SSSound13/Cambridge_640A_PowerAmp/REVIEW_ROUTING_2026-09-28.md

> Исторический документ сентября 2026 года. Его выводы и разрешения на заказ не относятся к текущим исправленным исходникам. В изготовленной v2 позднее обнаружена ошибочная связь U6.2 с +15V. Актуальная v2 находится на проверке; см. [README](README.md) и [текущие исправления](doc/v2/MINIMAL_FIXES.md).

# Проверка разводки после переразводки — 2026-09-28

Проверялась плата `640A_PowerAmp.kicad_pcb` версии от 2026-09-28 16:51 (после полной переразводки
сигнальных цепей, KiCad 10). Найденное исправлено прямо в файле платы; исходный файл —
`_archive_2026-09-28_routing_review/640A_PowerAmp.kicad_pcb.before`, скрипты проверки и план правок —
`_archive_2026-09-28_routing_review/scripts/`. Краткая запись — в `CHANGELOG.md` (2026-09-28, 18:35).

## Итог

* Ошибок соединений нет: ERC 0/0, DRC с перезаливкой зон и проверкой соответствия схеме — 0 ошибок,
  0 неразведённых, только прежние 148 исключённых пересечений courtyard.
* Главный недочёт разводки — питание выходных транзисторов U2 (−45V) и U5 (+45V): полигоны In1 были
  связаны с шинами батареи только через площадки резисторов R41/R98, а реальное сечение полигонов
  с учётом вырезов под площадки в узких местах составляло 1,1–3,3 мм при 35 мкм. Исправлено
  переходными отверстиями и расширением зон; одно узкое место (колонна −45V к U2) без перестановки
  элементов не расширяется — см. «Что осталось».
* Ширины 143 отрезков доведены до классовых там, где позволяет зазор; 8 площадок переведены на
  сплошное подключение к полигонам. Элементы не сдвигались, цепи и площадки не менялись.

## Что проверялось

| Проверка | Способ | Результат |
|---|---|---|
| Соответствие схеме, ERC, DRC | kicad-cli 10.0.6: `sch erc`, `pcb drc --schematic-parity --refill-zones --all-track-errors --severity-all` | 0 / 0 / только исключённые courtyard |
| Связность силовых цепей по меди | свой граф: дорожки, площадки, переходные отверстия, контуры зон, перекрытия зон одной цепи | +45V, −45V, PGND — по одному связному куску; найден ввод через площадки R41.2/R98.2 |
| Сечение полигонов In1/In2 | растр залитых полигонов из файла, минимальная ширина меди по строкам/столбцам | цифры ниже |
| Ширины дорожек против классов | по всем отрезкам, с расчётом максимально возможной ширины по зазору | план расширения |
| Лучи GND, возвраты АС, звезда | обход графа GND от NT1.2, PGND от NT1.1 | как описано в README (слева и справа по три луча GND; возвраты АС — плечи F.Cu 3,0 мм) |
| Параллельные пробеги сигнальных цепей с ±45V/обмотками, зазоры <0,25 мм, HV–HV <0,6 мм | геометрический перебор | замечаний нет |
| Касание корпусов | контуры слоя Fab всех посадочных мест, попарно | таблица ниже |
| Коридоры для обходных силовых дорожек | поиск самого широкого коридора (растр 0,1 мм, зазор 0,5 мм) на F.Cu, B.Cu, In1 | обходов ≥2 мм нет |

## Исправлено

### 1. Ввод ±45V в полигоны для U2 и U5

Шины батареи (B.Cu, 3,5 мм) для U2 и U5 кончались на площадках R41.2 (−45V) и R98.2 (+45V) —
fusible 150R, площадка Ø1,6 мм, отверстие 0,8 мм, тепловые мостики 4 × 1,0 мм × 35 мкм. Полигоны
In1 других связей с шиной не имели, то есть весь ток коллектора выходного транзистора шёл через
гильзу и мостики резисторной площадки.

Сделано: переходные отверстия 1,2/0,6 мм на шинах внутри полигонов —
3 шт. у R41 (111,2/133,2; 112,9/133,7; 113,8/132,8 — зона −45V расширена под них: x 112,4–116,5,
y 131,6–136,5, зазор до зоны +45V 0,6 мм), 2 шт. у R98 (187,3/112,1; 187,9/113,6).
Для U3 и U4 полигоны питались через одну гильзу конденсатора (C23.1, C30.2, Ø1,2 мм) — добавлено
по 2 отверстия на шинах рядом (121,3 и 122,6/102,73; 174,9 и 176,3/129,7). Всего 9 силовых отверстий.

Полигон +45V у U5.3 заканчивался на y = 61,0 при центре площадки 61,07 (у U2 язычок доходит до 63,2) —
связь держалась на перекрытии заливкой верхней части площадки. Язычок продлён до y = 63,2.

### 2. Сечения полигонов

Минимальная ширина меди (по заливке, с вырезами под площадки и зазоры), мм при 35 мкм.
Критерий из README: 3,5 мм внутри для 4 А при +20 °C; для тока заряда батареи (~6 А) — 6,1 мм.

| Участок | Было | Стало | Что сделано |
|---|---|---|---|
| −45V → U2, верхняя полоса (у R120) | 1,1 | 3,55 | полоса опущена с y 56,5 до 59,0 (x 82–100,5) |
| −45V → U2, колонна, ряд Q19 (y 72) | 1,7 | 2,6 | колонна расширена до x 112,4 |
| −45V → U2, колонна, ряд Q14/R27–R29 (y 91) | 2,1 | 2,1 | расширение не помогает — R27/R28 стоят в новой полосе |
| −45V → U2, колонна, y 101 | 2,2 | 3,0 | то же расширение |
| +45V → U5, верхняя полоса | 3,1 | 4,05 | полоса опущена до y 59,0 (x 193–215) |
| +45V → U5, колонна | 3,25 | 3,9 | колонна расширена до x 184,6 |
| +45V мост → батарея, стебель (ряд NT1–NT3, C25.2/C26.2) | 4,75 | 12,5 | стебель расширен до x 134–163 на y 98–118 |
| PGND между рядами батареи (у NT1.2) | 4,35 | ≥24,6 | вырезы убраны: сплошной блок x 116–181, y 107,5–134 |
| PGND у CN20.3 (стебель к мосту) | 4,65 | ≥24,6 | нижний блок x 132–165, y 142–157 |
| +45V → U3, −45V → U4 | 4,95 | 4,95 | без изменений |

Опущенные полосы оставляют 0,57 мм до ряда выводов U2/U5. В полосы попали D2.2/C46.2 (−45V) и
C48.1/D10.1 (+45V) — им дано сплошное подключение (у C48.1 тепловое подключение иначе получается
с одним мостиком, DRC «starved thermal»).

### 3. Сплошное подключение к полигонам

Было тепловое: C11.1, C65.2, C64.1, C45.2 (выводы PGND развязки 220 µF выходных каскадов),
D2.2, C46.2, C48.1, D10.1 (см. выше). R41.2/R98.2 оставлены с тепловыми мостиками — после
добавления отверстий они не несут ток полигона, а fusible-резисторы должны легко перепаиваться.

### 4. Ширины дорожек

Расширены до классовой ширины 143 отрезка там, где остаётся зазор ≥0,3 мм (≥0,5 мм до ±45V и обмоток;
до площадок — по описанной окружности прямоугольных площадок):

| Цепь | Было → стало | Отрезков |
|---|---|---|
| digital | 0,3 → 0,8 | 4 |
| digital | 0,6 → 0,7–0,8 | 31 |
| +5V | 0,6 → 0,8 | 21 |
| GND | 0,6 → 0,8 | 8 |
| PIC CLIP / DC / OVERCURRENT / STANDBY / TEMP | 0,4–0,5 → 0,5–0,8 | 38 |
| вход CN11 (Net-(CN11-Pin_1)) | 0,5 → 0,8 | 6 |
| база Q20 (термодатчик) | 0,5–0,6 → 0,7–0,8 | 21 |
| CN21.3 → D16 (вспомогательная обмотка) | 0,8 → 0,9–1,0 | 3 |
| отводы ±45V к C11, C46, C48, D10 | 1,2–1,5 → 1,35–2,0 | 11 |

Не трогались: ответвления выходных цепей RO/LO/RE/LE (R101, отводы цобеля и защиты, контрольные
точки) и отвод CN20.1 → C32 (снаббер) — ток там мал, ширина 1,0–1,5 мм выбрана осознанно.
49 отрезков остались уже классовой ширины, потому что не проходят по зазору.

## Что оставалось после 2026-09-28 (сделано 2026-09-29, см. ниже)

1. **Колонна −45V к U2 (x 104–112,4)** пересечена насквозь рядами выводов Q19 (y 72) и Q14/R27–R29
   (y 90–92): 2,1–2,6 мм × 35 мкм. По IPC-2221 (внутренний слой) это ≈2 А при +10 °C и ≈3,3 А при
   +30 °C. На 8 Ом (≈2 А RMS на плечо при полной мощности) и для музыки достаточно; длительная
   синусоида на 4 Ом (≈3,5 А RMS) даст нагрев порядка +35 °C в этом месте. Обходной дорожки ≥2 мм
   на F.Cu или B.Cu с зазором 0,5 мм по текущей расстановке нет (самый широкий коридор — 1,8 мм с
   обходом 125 мм через сигнальную зону канала). Радикально помогает только перестановка: вынести
   Q14, Q19 и R29 из колонны или развернуть их ряды вдоль неё. Правая сторона (U5) после правок
   проходит по критерию 3,5 мм.
2. **R120** (100R параллельно R116) стоит поперёк верхней полосы −45V; если повернуть его выводом 2
   на запад (x ≈ 85,5), полоса вырастет с 3,55 до ≈5,9 мм. Не делалось — при ограничении колонны
   выигрыш не реализуется.
3. **Корпуса по контурам Fab.** В комментариях исключений courtyard часть пар отнесена к «TO-92 без
   контура на Fab», но контур у `TO-92_Inline_Wide` есть, и по нему корпуса перекрываются:
   Q21/C27 — 0,50 мм, R109/Q19 — 0,27, C46/C13 — 0,10, R49/R50 — 0,09, R117/Q22 — 0,06;
   пары TO-92 с шагом 3,5 мм Q7/Q8, Q9/Q10, Q26/Q27, Q28/Q29 — 0,74 мм, Q3/Q4, Q5/Q6 — 0,23 мм
   (ставить с наклоном, как на заводской плате). Известные: R44/R45 0,36, C22/R42 0,37, C21/C22 0,24.
   Электрически это ни на что не влияет — только внимание при сборке.
4. Переходные отверстия 1,2/0,6 мм — новый размер для платы (было 0,6/0,3); стандартный для любого
   производителя, но при заказе проверить, что класс отверстий 0,6 мм включён.

## Проверки после правок

* ERC: 0 ошибок, 0 предупреждений (`_archive_2026-09-28_routing_review/erc_check.rpt`).
* DRC (KiCad 10, перезаливка зон, соответствие схеме, все ошибки дорожек): 0 ошибок, 0 неразведённых,
  0 расхождений со схемой; 148 исключённых пересечений courtyard как раньше —
  `doc/DRC_after_routing_review_2026-09-28.rpt`.
* Сравнение разобранных данных до/после: 1354 отрезка (изменена только ширина у 143 запланированных),
  6 → 15 переходных отверстий, 297 посадочных мест на тех же местах, 9 зон (контуры изменены у четырёх),
  изменены только 8 площадок (`zone_connect`), контур платы и цепи те же.
* Файл сохранён kicad-cli (перезаливка зон), концы строк CRLF, как в исходном файле. Все три файла
  открываются в KiCad 10; в KiCad 9 плата не откроется (формат 20260206 — так было и до правок).

## Доделано 2026-09-29 (по разделу «Что осталось»)

1. **Колонна −45V к U2.** Вместо перестановки Q14/Q19/R29 проложена вторая колонна −45V по свободному
   коридору In1 между полигоном +45V и центром платы: новая зона x 124,1–132,3, y 50,8–132 (приоритет 1,
   зазор 0,5 мм), соединённая со старой полосой через полосу над верхом полигона +45V (x 111,5–124,1,
   y 50,8–56,4) и питаемая с шины батареи четырьмя переходными отверстиями 1,2/0,6 мм прямо на шине.
   Сечение по заливке: колонна ≥5,0 мм, полоса над +45V 5,65 мм, старая полоса 5,75 мм. Старая колонна
   осталась параллельным путём. Сигнал PIC OVERCURRENT/SHORT, шедший по In1 через коридор, на участке
   пересечения переведён на F.Cu (два переходных отверстия 0,6/0,3).
2. **R120 повёрнут** выводом 2 на запад (оба вывода в ряду y 54,93): полоса −45V под R116/R120 — 5,75 мм
   вместо 3,55. Дорожки к U2.4 и R116.1 переподключены под 45°, надпись перенесена над корпус.
3. **Комментарии исключений DRC** для пар корпусов с реальным перекрытием по Fab переписаны с цифрами
   (Q21/C27 0,50; R109/Q19 0,27; R117/Q22 0,06; R49/R50 0,09; пары TO-92 0,74 и 0,23 мм). Корпуса не
   двигались — на сборке ставить с наклоном, как на заводской плате.
4. Отверстия 1,2/0,6 мм и 0,6/0,3 мм — стандартные; при заказе проверить класс отверстий 0,3 и 0,6 мм.

Итог по питанию выходных транзисторов (минимальное сечение полигонов In1 по заливке, 35 мкм):
U3 4,95 мм, U4 4,95 мм, U5 3,9 мм, U2 5,0 мм (новая колонна) + 2,1 мм (старая). Критерий из README —
3,5 мм для 4 А — выполнен везде.

Проверки после доделки: ERC 0/0 (`_archive_2026-09-28_routing_review/erc_check_2026-09-29.rpt`);
DRC (KiCad 10, перезаливка, соответствие схеме, все ошибки дорожек) — 0 ошибок, 0 неразведённых, только
148 исключённых пересечений courtyard (`doc/DRC_after_routing_review_2026-09-29.rpt`). Изменения в файле
платы против 28.09: +1 зона, +6 переходных отверстий, +4/−1 отрезка, 3 отрезка укорочены/сдвинуты,
повёрнут один элемент (R120), больше ничего не тронуто.

**3D-модели разъёмов.** В этой копии проекта они на месте: у CN2–CN24 ссылки `${KIPRJMOD}/640A.3dshapes/…step`,
файлы лежат в `640A.3dshapes/` (JST XH — библиотечные KiCad, JST VH — упрощённые модели проекта), kicad-cli
их грузит и рендерит (`_archive_2026-09-28_routing_review/render_cn20.png`). Если в вашем рабочем экземпляре
разъёмов в 3D нет, рядом с `640A_PowerAmp.kicad_pro` отсутствует папка `640A.3dshapes` — скопируйте её отсюда.
