SSSound13/Cambridge_640A_PowerAmp/REVIEW_REPORT_2026-09-28.md

> Исторический документ сентября 2026 года. Его выводы и разрешения на заказ не относятся к текущим исправленным исходникам. В изготовленной v2 позднее обнаружена ошибочная связь U6.2 с +15V. Актуальная v2 находится на проверке; см. [README](README.md) и [текущие исправления](doc/v2/MINIMAL_FIXES.md).

# Отчёт внешней проверки — 2026-09-28

**Cambridge Audio Azur 640A (V1), Power Amp PCB AP12707/6: схема и новая 4-слойная плата (релиз 2026-09-27/28, KiCad 9.0.4).**
Задание — `REVIEW_BRIEF.md`. Проверка сделана на копии проекта средствами KiCad 10.0.6 (kicad-cli) и скриптами по файлам схемы и платы; на железе ничего не измерялось.

## 0. Кратко

* **Блокеров не найдено.** Схема совпадает с мануалом везде, кроме заявленных доработок (проверено сравнением списков цепей по всем выводам). Распиновки, полярности, разделение земель, разъёмы и звезда на плате сходятся. ERC и DRC чистые и в KiCad 10.
* **Заказывать плату можно** после одной правки платы — заземлить радиатор U8–U10 через H7/H8 (п. 2). Остальные важные пункты — уровня BOM (диоды моста, проверка Vin для TSR) или необязательные улучшения разводки (зазоры, термобарьеры).
* Из доработок две советую пересмотреть: Шоттки SB5200 в мосте (заменить на кремниевые) и металлоплёночный резистор цобеля (оставить проволочный).

## 1. Что и как проверялось

| Проверка | Как | Результат |
|---|---|---|
| Схема ↔ мануал | список цепей проекта (kicad-cli 10) сравнён по каждому выводу со списком цепей эталонной версии — схема мануала стр. 17–20 после удаления LK и замыкания WIRE LINK | 274 общих элемента: ни один вывод не переехал; отличия — только PGND/GND/AUX0V, удалённые CN22/CN4/J17/J18, новые C16/C79–C81/R120–R123/TP1–6/NT1–3 и заявленные номиналы (`**`, 1N4004) |
| ERC / DRC | KiCad 10.0.6, с проверкой соответствия плата↔схема | 0 неразведённых, 0 нарушений меди; 140 courtyard (исключения), 199 «расхождений» — только поле Datasheet «~»/пусто (косметика, п. 11) |
| Распиновки | пад → цепь для всех транзисторов, SAP15, стабилизаторов, TSR; ориентация двойников в двух каналах | стандартная цоколёвка везде (MPSA E-B-C, BC327/337 C-B-E, MJE E-C-B, MPSA13 E-B-C, SAP15N B-D-C-S-E, SAP15P E-S-C-D-B, 7815 I-G-O, 7915 G-I-O, TSR I-G-O); повороты двойников каналов одинаковы (сдвиг 98,9 мм) |
| Полярность | электролиты и диоды по топологии цепей | мост D17–D20, вспомогательный мост, зажимные D2/D4/D8/D10, стабилитроны, все электролиты питания — верно; не проверялись C70/C71/C74/C75 (двуполярный узел детектора DC) |
| Земли | net-tie, цепи, рендеры слоёв | четыре земли соединены только в NT1–NT3 (`net_tie_pad_groups` есть, DRC замыканий не видит); лучи GND приходят на NT1.2, силовые токи входят в NT1.1 и уходят в полигон In2 — звезда сделана правильно |
| Разъёмы | пад → цепь | CN20: 1 и 2 — концы обмотки, 3 — средняя точка (PGND); CN21: 1 и 3 — концы, 2 — средняя точка (AUX0V); CN23/CN24: 1 OUT, 2 RTN (PGND) |
| Ширины, зазоры, отверстия | скрипт по файлу платы | минимальная ширина 0,30 мм (узких 0,17–0,26 мм уже нет — п. 10 брифа устарел); минимальный зазор между разными цепями 0,20 мм; сверловка под все выводы достаточна (SAP15 1,3; VH 1,7; DO-201AD 1,6; 2200 µF 1,2; TSR 1,0) |

## 2. Замечания

### Блокеры

Нет. Оговорка: цвета проводов и ориентация деталей снимались автором с реальной платы и меди оригинала; я проверил только внутреннюю согласованность проекта (см. раздел 1 и приложение).

### Важно

1. **D17–D20 SB5200 (Шоттки 5 A 200 В) — заменить на кремниевые в том же корпусе DO-201AD:** BY550-400 (обычный, 5 A) или MUR460 / UF5404 (быстрые, мягкие — под снабберы). Причина: у Шоттки класса 200 В обратный ток растёт с температурой на порядки (по даташиту до ~20 мА при 100 °C на 200 В), а диоды моста греются: при полной мощности ≈2–2,5 Вт на диод без радиатора. При 93 В обратного напряжения утечка 10 мА — ещё ≈1 Вт, положительная обратная связь по теплу. Выигрыш по Vf (≈0,85 против ≈1 В) ничтожен, запас по обратному напряжению тот же, что у 1N5402 (200 В). Плату замена не трогает.
2. **H7/H8 (штыри радиатора U8–U10) без цепи.** По списку деталей мануала U8 (7805) ставится **без** изолятора («U8 MUST NOT USE AN INSULATION KIT»), U9/U10 — с изоляторами, то есть в оригинале радиатор сидит на земле `digital` через фланец 7805. У TSR 1-2450 фланца нет — радиатор повисает: ёмкостно связан с фланцем 7915 (−Vin с пульсациями 100 Гц), работает антенной. Присвоить H7/H8 цепь `digital` (символ `Mechanical:MountingHole_Pad` на листе Power Supply, площадки уже металлизированные), изоляторы U9/U10 оставить.
3. **TSR 1-2450 — предел входного напряжения 36 В.** На той же шине стоит C53 470 µF **35 В**, то есть шина при высокой сети и холостом ходе близка к пределу модуля. Измерить `Net-(D14-K)` без нагрузки при +10 % сети; если больше 32 В — брать TSRN 1-2450 (вход до 42 В, уточнить по даташиту) или вернуть 7805 (его нагрев на общем радиаторе — штатный режим, не отказ).
4. **Зазоры на внешних слоях у ±45 В и обмотки.** Минимумы: 0,20 мм LOCLIP — конец обмотки RED (`Net-(CN20-Pin_1)`, 47 В пер.) на B.Cu у (179,5; 142,3); 0,23 мм −45V — BIAS_HI_R у площадки R121; 0,46 мм между концами обмотки (94 В пик) у CN20. IPC-2221 для 51–100 В на внешнем слое без покрытия — 0,6 мм; с маской практика допускает ~0,3. Сигнал детектора клипа в 0,2 мм от 47 В переменного — и наводка, и риск. Отвести LOCLIP на ≥0,5 мм, R121 — на 0,3 (собственное правило новых дорожек).
5. **C13/C47 «10u NP 16V»** стоят на посадочном месте плёночного конденсатора `C_Rect_L7.2mm_W3.0mm_P5.00mm`. Плёнки 10 µF в таком корпусе нет; если ставится NP-электролит с шагом 5 мм (Ø8–10), сменить посадочное место на радиальное P5.00, чтобы BOM и сборка не спорили.

### Замечания

6. **Термобарьеры на силовых площадках внутренних слоёв.** Зоны ±45V (In1) и PGND (In2) подключаются термобарьерами 1,0 мм/зазор 0,5, DRC допускает 2 спицы (`min_resolved_spokes 2`). Это единственный путь тока между слоями (переходных отверстий нет). Для батареи, моста, коллекторов SAP15, CN20.3, возвратов АС и NT1 лучше `zone_connect solid` или минимум 4 спицы: две спицы 1×0,035 мм² ток 4–6 А выдержат (короткий отрезок, теплоотвод в площадку и полигон), но запаса нет. Пайке не мешает — на внешних слоях полигонов нет.
7. **Медь под шайбами крепежа.** Ближайшие дорожки к центрам H2, H7, H8, H9 — 2,4–2,5 мм (B.Cu, медь оригинала); шайба M3 Ø7 ляжет на маску над ними. Нейлоновые шайбы или keep-out Ø7,5 на внешних слоях.
8. **NT2/NT3:** площадка 1,3 мм при сверле 1,0 — кольцо 0,15 мм, предел большинства фабрик. Сделать 2,0/1,0, место есть.
9. **Стек 70/35 мкм:** заказывать явно 2 oz снаружи и 1 oz внутри (у многих фабрик внутри по умолчанию 0,5 oz); для 2 oz уточнить у фабрики минимальные ширину/зазор (в проекте 0,30/0,20 мм).
10. **Шелкография 0,8 мм** допустима, но 1,0 мм читается надёжнее — поднять там, где есть место.
11. **Поле Datasheet:** на плате «~», в схеме пусто — KiCad 10 даёт 199 «расхождений» при проверке соответствия. Привести к одному виду, чтобы парность оставалась чистой в новых версиях.
12. **Имена каналов.** Лист «Left Channel» несёт цепи R* (RO, RE1, RICLIP…), «Right Channel» — L*; так подписаны страницы 19/20 мануала. Внутри платы всё согласовано: детекторы клипа и DC, выход и контрольные точки одного канала под одной буквой, защита суммирует оба канала — функциональных последствий нет. Какой канал физически левый, задаёт жгут (CN2/CN11 от PREOUT L/R платы Input & Tone, CN23/CN24 к Loudspeaker PCB), а он не меняется, потому что разъёмы стоят на местах клемм оригинала. Переименовать листы по цепям или добавить примечание, чтобы при наладке не искать «правый» на «левом».
13. **C66/C7/C43/C33 220 µF 50 В** сидят на ≈43 В — запас 15 %, как в оригинале; при закупке брать 63 В (Ø10×16 существует).
14. **C81 10 µF X7R:** у дискового X7R при 24 В смещения остаётся 40–60 % ёмкости — TSR хватит, но лучше 50 В-ный или два параллельно; на выходе U8 оставить C59 47 µF рядом с выводом 3.

## 3. Оценка доработок

| Доработка | Вердикт | Обоснование |
|---|---|---|
| R43, R41, R96, R98 → 150R 0,5 Вт fusible | **оставить** | ток фронт-энда 10–15 мА, рассеивание 20–30 мВт; при аварии размыкается без обугливания; корпус 0207 тот же |
| R120, R121 100R ‖ R116/R68 | **оставить** (82–100 Ом) | в мануале движок подстроечника замкнут на крайний вывод (R116.1 = R116.2): при обрыве движка сопротивление становится равным всей дорожке 47 Ом, а не бесконечности — «уход в максимум» и в оригинале ограничен. R120 снижает этот максимум до 32 Ом ценой трети диапазона регулировки: польза умеренная, вреда нет. Ниже 82 Ом не опускать. Главная защита от разогрева — термодатчик Q20/U7 — остаётся |
| TP1–TP6 | **оставить** | |
| C17, C41 → 220 µF NP | **оставить** | срез цепи ОС 0,7 Гц; постоянная времени установления смещения 0,22 с (вдвое дольше) — незаметно; после прогрева проверить смещение на выходе |
| C18, C39 → 2,2 µF плёнка | **оставить** | срез 1,9 Гц (R35 + R36 = 37,7 кОм): −0,04 дБ и 5° на 20 Гц; полюс входа выше полюса ОС — правильный порядок |
| R44, R50 → металлоплёночный 3 Вт | **изменить: оставить проволочный 3 Вт** (лучше безындуктивный, Ayrton-Perry, например Vishay AC03-AT) | индуктивность малого 3 Вт ПЭВ 0,1–0,3 мкГн — 0,1–0,2 Ом на 100 кГц против 4,7 Ом, на устойчивость не влияет. При ВЧ-возбуждении цобель греется ваттами: проволочный переживает, плёнка сгорает. Заодно снимается перекрытие корпусов R44/R45 |
| C24, C28 → 100 nF 250 В | **оставить** | |
| D17–D20 → SB5200 | **заменить**: BY550-400 или MUR460 (DO-201AD) | см. п. 1; сама идея «5 А вместо 3 А» верна, Шоттки — нет |
| R122+C79, R123+C80 | **оставить, подобрать** | 47 Ом / 100 nF — рабочий старт (полоса выше 34 кГц), мощность на 50 Гц ничтожна; при переходе на кремниевые диоды подбор обязателен |
| U8 → TSR 1-2450 | **оставить условно** | заземлить радиатор (п. 2), проверить Vin (п. 3), C81 у выводов. Помехи: модуль стоит у выпрямителя и стабилизаторов, далеко от входных каскадов, питает только цифру — приемлемо |
| Разделение земель, звезда NT1–NT3 | **оставить** | сделано правильно: опорные цепи входа на NT1.2 без тока, силовые токи в полигон In2 через NT1.1, возвраты АС отдельными плечами |
| Разъёмы CN20/CN21/CN23/CN24 | **оставить** | VH 10 А на обмотку 6 А и выходы 5,5 А, XH на вспомогательную; средние точки на CN20.3 и CN21.2 верны |

## 4. Ответы на открытые вопросы

1. **U8 и земля `digital`** — допустимо. Контур импульсного входного тока замыкается через C81 (Vin → U8 → GND → C81 → Vin) рядом с модулем, через звезду идёт только средний ток (≈0,25 × I_5V у понижающего преобразователя — меньше, чем у 7805). Переносить общий вывод на AUX0V не нужно: тогда +5 В был бы привязан к AUX0V, а PIC — к digital, и весь ток нагрузки пошёл бы через звезду. Держать C81 (и выходной C59) в пределах 5 мм от выводов.
2. **C22** — ставить. Он фильтрует опору источника тока хвоста дифкаскада (узел R42/R39, `Net-(C22-Pad2)`): без него пульсации шины через R42 попадают в опору. Коричневый клей — заводская фиксация высоких деталей; конденсатор, скорее всего, отвалился при ремонте или вибрации. Двойник C42 в правом канале должен стоять.
3. **C16/C44** — оставить DNP. 5 pF между выходом VAS и базой источника тока — коррекция «на всякий случай», завод их не ставил. Впаивать только при возбуждении на меандре 10 кГц.
4. **R120/R121 = 100 Ом** — подходит, диапазон 82–100 Ом. Если подстроечник выкручен больше 70 % — 150–220 Ом, как задумано.
5. **Снабберы** — 47 Ом / 100 nF можно оставить до подбора; вреда от неоптимальных значений нет (реактивная мощность мала). С кремниевыми диодами подобрать по Quasimodo/Hagerman.
6. **D13–D16, D31** — 1N4004, как в списке деталей (в CHANGELOG 2026-09-28 уже так; п. 6 брифа устарел). Электрически безразлично: обмотка даёт ~50 В обратного.
7. **R44** — с проволочным 3 Вт вопрос корпуса снимается: Ø4–4,5 × 12–13 мм (Vishay AC03, Royal Ohm KNP300 и подобные) входят в шаг 18,42 мм без наложения на R45. Если всё же плёнка — достаточно 2 Вт MOX 0414 (Ø4,2 × 11,5): в норме цобель рассеивает < 0,5 Вт.

## 5. Заключение

Заказывать можно после правки п. 2 (H7/H8 → `digital`). Пп. 4 и 6–8 — по желанию, в ту же итерацию платы. Пп. 1, 3, 5 — правки BOM и одно измерение, плату не трогают. Остальное — замечания.

## Приложение. Что проверить руками и что осталось за рамками

* **Цвета проводов.** По схеме верно: средние точки на CN20.3 и CN21.2. Соответствие реальным проводам (CN20: 1 YELLOW, 2 RED, 3 ORANGE; CN21: 1 GREEN, 2 VIOLET, 3 GREY) подтвердить омметром: средняя точка — вывод с одинаковым сопротивлением до двух других.
* **Ориентация корпусов** (по меди оригинала) проверена косвенно: пад→цепь соответствует стандартной цоколёвке, повороты двойников каналов одинаковы, полярности по топологии сходятся. Не проверялись C70/C71/C74/C75 (узел детектора DC с двуполярным сигналом).
* **Напряжение вспомогательной шины** (п. 3), токи покоя, устойчивость, фон — только на железе.
* **KiCad 10:** проект открывается и проверяется без ошибок; 36 предупреждений «символ отличается от библиотеки» — версии библиотек, на схему не влияют.
