SSSound13/Cambridge_640A_PowerAmp/REVIEW_BRIEF.md

> Исторический документ сентября 2026 года. Его выводы и разрешения на заказ не относятся к текущим исправленным исходникам. В изготовленной v2 позднее обнаружена ошибочная связь U6.2 с +15V. Актуальная v2 находится на проверке; см. [README](README.md) и [текущие исправления](doc/v2/MINIMAL_FIXES.md).

# Задание на повторную проверку

**Cambridge Audio Azur 640A (V1) — плата усилителя мощности AP12707/6: схема и новая 4-слойная плата в KiCad**

Релиз 2026-09-28 (вечер) · KiCad 10.0 · DRC: 0 ошибок, 0 предупреждений, 0 неразведённых, 0 расхождений
со схемой (148 обоснованных исключений) · ERC: 0 ошибок

Это второй круг. Первая проверка — `REVIEW_REPORT_2026-09-28.md` (блокеров нет, заказывать можно после
заземления радиатора). После неё плата заметно изменилась: заказаны детали и под них поправлены посадочные
места, **все сигнальные цепи разведены заново**, внесены правки по отчёту. Нужно проверить именно эти изменения.

---

## 1. Что нужно от проверяющего

1. Проверить, что правки по первому отчёту сделаны правильно (раздел 3).
2. Проверить новую разводку сигнальных цепей и новые места элементов (раздел 4) — это самое большое
   изменение, проверки первого круга его не покрывают.
3. Оценить сборочные решения там, где детали стоят впритык (раздел 5).
4. Ответить на открытые вопросы (раздел 7) и дать заключение: можно ли заказывать плату.

Формат ответа — в разделе 9.

## 2. Исходные данные

| Файл | Что это |
|---|---|
| `640A_PowerAmp.kicad_pro` | открывать проект через этот файл (KiCad 10.0) |
| `*.kicad_sch` (5 шт.) | схема: корневой лист + Power Supply, Protection, Left Channel, Right Channel |
| `640A_PowerAmp.kicad_pcb` | плата |
| `640A.pretty`, `640A.3dshapes` | свои посадочные места и 3D-модели разъёмов |
| `doc/DRC_final.rpt` | отчёт DRC с исключениями и комментариями |
| `doc/cambridge_azur-640a_sm.pdf` | сервис-мануал: схема стр. 17–20, чертёж платы стр. 21, медь стр. 22, детали стр. 23–25 |
| `doc/SAP15.pdf` | даташит Sanken SAP15N/P |
| `REVIEW_REPORT_2026-09-28.md` | отчёт первой проверки |
| `CHANGELOG.md` | хронология всех правок 2026-09-28 с координатами |
| `README.md` | описание проекта (земли, разводка, разъёмы, купленные детали) |

У изменённых и новых элементов в схеме — пометка `**` (поле `Mod`) и причина в Description. У купленных
деталей есть поля `Manufacturer`, `MPN`, `Supplier`, `Supplier PN` (номер «ЧИП и ДИП»).

## 3. Правки по отчёту первой проверки

| № отчёта | Замечание | Что сделано |
|---|---|---|
| 1 | SB5200 в мосте → кремниевые | D17–D20 → **Diotec BY550-400** (5 А, 400 В, Iпик 220 А, Ø5,4 × 7,5), посадочное место прежнее |
| 2 | радиатор U8–U10 висит | **H8 → `digital`** дорожкой к цепи digital у U8; H7 без цепи (одна точка). Изоляторы U9/U10 остаются |
| 3 | TSR 1-2450: Vin до 36 В | не менялось — нужен замер (раздел 7, вопрос 1) |
| 4 | зазоры сигналов у ±45 В и обмотки | при переразводке сигнальные дорожки держатся **≥0,5 мм** от +45V, −45V, концов обмотки CN20 и выходов RO/LO/RE/LE; LOCLIP и BIAS_HI_R разведены заново |
| 5 | C13/C47 10 µF NP на плёночном посадочном месте | новое `640A:C_Radial_D5.0mm_P5.00mm_NP` (Ø5 × 11, выводы в шаг 5) |
| 6 | термобарьеры на силовых площадках | `zone_connect solid` у 28 площадок ±45V/PGND: C21/C23/C25/C26/C29/C30/C62/C63, D17–D20, U2–U5, CN20, CN23, CN24, NT1 |
| 7 | медь под шайбами H2/H7/H8/H9 | не менялось — нейлоновые шайбы (раздел 7, вопрос 4) |
| 8 | NT2/NT3 кольцо 0,15 мм | площадки 2,0 мм при сверле 1,0 |
| 9, 10, 12, 13 | стек, шелкография, имена листов, 63 В | не менялось; стек и 63 В — при заказе |
| 11 | Datasheet «~»/пусто | плата синхронизирована со схемой, расхождений 0 |
| 14 | C81 X7R | C81 → Murata RDEC71H106K3K1H03B, 10 µF 50 В X7S |
| оценка доработок | R44/R50 оставить проволочные | R44/R50 → **Vishay AC03 4R7 3 Вт проволочный** (Ø4,8 × 13) — см. раздел 5 |

## 4. Что изменилось на плате (проверить)

### 4.1. Посадочные места под купленные детали

| Элемент | Деталь | Посадочное место | Что изменилось |
|---|---|---|---|
| C24, C28 (цобель) | TDK B32560J3104K000, 100 nF 250 В, **шаг 7,5 мм** | `C_Rect_L9.0mm_W3.2mm_P7.50mm_MKT` | отверстия раздвинуты от прежнего центра (C24: 88,5 / 96,0; C28: 89,26 / 96,76) |
| C79, C80 (снабберы) | то же | то же | C79 — (154,0; 158,5)/(154,0; 151,0); C80 — (141,8; 156,3)/(141,8; 148,8) |
| C18, C39 (вход) | WIMA MKS2 2,2 µF 100 В, **11 × 16 × 7,2 мм** | `C_Rect_L7.2mm_W11.0mm_P5.00mm_…` | C18 на своём месте, повёрнут на 90°, **C49 сдвинут на 0,3 мм**; C39 перенесён на 9 мм ниже, под C76 |
| C81 | Murata RDE 5,5 × 4,0 мм | `640A:C_Rect_L5.5mm_W4.0mm_P5.00mm_Murata_RDE` | отверстия прежние |
| C13, C47 | NP-электролит 10 µF Ø5 | `640A:C_Radial_D5.0mm_P5.00mm_NP` | отверстия прежние |
| C17, C41 | Panasonic ECE-A1AN221U 220 µF **10 В** NP, Ø8 | прежнее | номинал 16 → 10 В (на конденсаторе < 1 В) |

Остальные замены — в те же отверстия: R41/R43/R96/R98 TE FRN50 (fusible 0,5 Вт), R120/R121 MF-25 100R 1 %,
R122/R123 MO-50 47R 0,5 Вт, U8 TSR 1-2450, разъёмы JST.

### 4.2. Переразводка сигнальных цепей

Медь сигнальных цепей в первом круге была медью оригинала, переведённой из PDF (короткие отрезки,
произвольные углы, обходы по краю). Теперь **107 сигнальных цепей разведены заново** автотрассировкой:

* дорожки 0/45/90°, ширина 0,8 мм (в тесных местах 0,5–0,6), в основном B.Cu, F.Cu — для пересечений;
* **6 переходных отверстий** 0,6/0,3 мм (раньше не было ни одного): CN5-Pin_1 ×3, Q19-C, Q22-C, Q32-C;
* зазор ≥0,2 мм, до ±45V / обмотки / выходов ≥0,5 мм;
* **не трогались** (медь и топология первого круга): ±45V, PGND, GND (включая дорожки-замены WIRE LINK на
  F.Cu — пути земли оригинала), AUX0V, digital, ±15V, +5V, выходы и эмиттерные цепи, обмотки, цепи на
  внутренних слоях (PIC …), цобели и снабберы, Net-(D1-A), Net-(Q3-C), Net-(Q20-B).

Проверить:
1. **Длинные и чувствительные трассы:** входы CN2/CN11 → C18/C39 → входной каскад; цепи обратной связи;
   детекторы клипа (LICLIP/LOCLIP/RICLIP/ROCLIP) и DC; BIAS_HI/LO. Нет ли трассы, которая прошла через
   «грязную» зону (обмотка, мост, выход) или параллельно силовой шине на длинном участке.
2. **Входная цепь правого канала:** CN11.1 → C39.1 идёт по F.Cu 0,5 мм между столбцами C40 и R84, около 12 мм.
3. **Переходные отверстия** проходят сквозь полигоны In1 (±45V) и In2 (PGND) — зазор даёт заливка; нет ли
   претензий по месту (CN5-Pin_1 — три отверстия у разъёма платы входов).
4. **Земли:** медь GND/PGND/AUX0V/digital не менялась; H8 добавил связь радиатора с digital — не образует ли
   она второй путь между землями (радиатор прикручен ещё и через H7, который без цепи).

## 5. Места, где детали стоят впритык (сборка)

Все случаи — 18 новых исключений DRC «пересечение courtyard» с комментариями; корпуса по даташитам не
пересекаются, но запаса почти нет:

| Место | Зазор между корпусами | Что предлагается |
|---|---|---|
| C18 (WIMA 11 × 7,2) ↔ C49, CN2, площадки R35/R39 | 0,05 / 0,19 / 0,08 / 0,11 мм | паять прижатым ровно |
| C81 ↔ U8, U9 | ≈0,08 мм с каждой стороны | то же |
| C13 ↔ C46, C47 ↔ C48 | касание на пределе допусков (≈0,08 мм) | — |
| C80 ↔ CN20 | ≈0,3 мм | — |
| **R44 ↔ R45** | AC03 Ø4,8 мм перекроет R45 на ≈0,26 мм | **R44 (и R50) ставить на выводах с зазором 3 мм над платой**; родной проволочный встаёт без зазора |
| C21/C22, C22/R42 | по 3D-моделям KiCad 0,29/0,32 мм | C22 брать Ø5 мм |

## 6. Как проверено

* DRC KiCad 10 с перезаливкой полигонов и сверкой платы со схемой: 0/0/0/0, 148 исключений (все —
  courtyard, с комментариями). Проверка «посадочное место/символ отличается от библиотеки» отключена
  в настройках проекта: отличия намеренные (обрезанная шелкография, свои 3D-модели, NT2/NT3, свои символы).
* ERC: 0 ошибок.
* Разводка: собственная проверка зазоров по точной геометрии площадок и связности всех 107 цепей.
* На железе ничего не измерялось.

## 7. Открытые вопросы

1. **TSR 1-2450 и шина `Net-(D14-K)`** (п. 3 отчёта): замер на холостом ходу при +10 % сети ещё не сделан.
   Если выше 32 В — TSRN 1-2450 (до 42 В по даташиту?) или вернуть 7805. Есть ли у проверяющего оценка
   напряжения по данным трансформатора?
2. **Заземление радиатора через H8 на `digital`** — правильно ли выбрана точка (у U8, а не у звезды), и
   нужно ли что-то делать с H7.
3. **Переходные отверстия в силовых полигонах** — допустимы ли шесть сигнальных отверстий сквозь In1/In2,
   или лучше увести их из-под силовых зон.
4. **Шайбы крепежа** — нейлоновые шайбы под H2/H7/H8/H9 достаточно, или нужна keep-out зона на плате.
5. **C59 47 µF на выходе U8** стоит на месте оригинала, ≈30 мм от вывода 3 TSR. Нужен ли дополнительный
   конденсатор у самого модуля (отчёт, п. 14)?
6. **R44/R50 на выводах 3 мм** — нет ли возражений (вибрация, индуктивность выводов в цобеле).

## 8. Ограничения и допущения

* Схема и плата восстановлены по векторному PDF мануала и сверены с реальной платой (2026-09-25).
* Расстановка существующих деталей — заводская (AP12708/6a); отсюда 130 исключений courtyard первого круга.
* Размеры корпусов купленных деталей — по даташитам производителей.
* Ни одна доработка на железе ещё не измерена.

## 9. Каким должен быть результат проверки

* **Список замечаний:** уровень (блокер / важно / замечание), где (обозначение, цепь, слой, координаты),
  что не так, что предлагается.
* **Оценка правок по первому отчёту (раздел 3):** принято / нужно доделать.
* **Ответы на вопросы раздела 7.**
* **Заключение:** можно ли заказывать плату в текущем виде.
