SSSound13/Cambridge_640A_PowerAmp/doc/v2/preview/back-markings.png

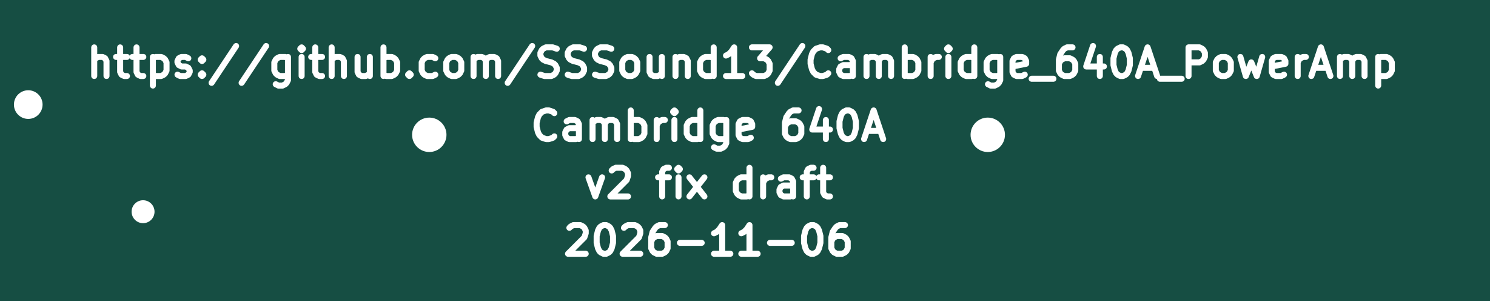
doc/v2/preview/back-markings.png
