SSSound13/Cambridge_640A_PowerAmp/doc/v2/preview/font-comparison.png

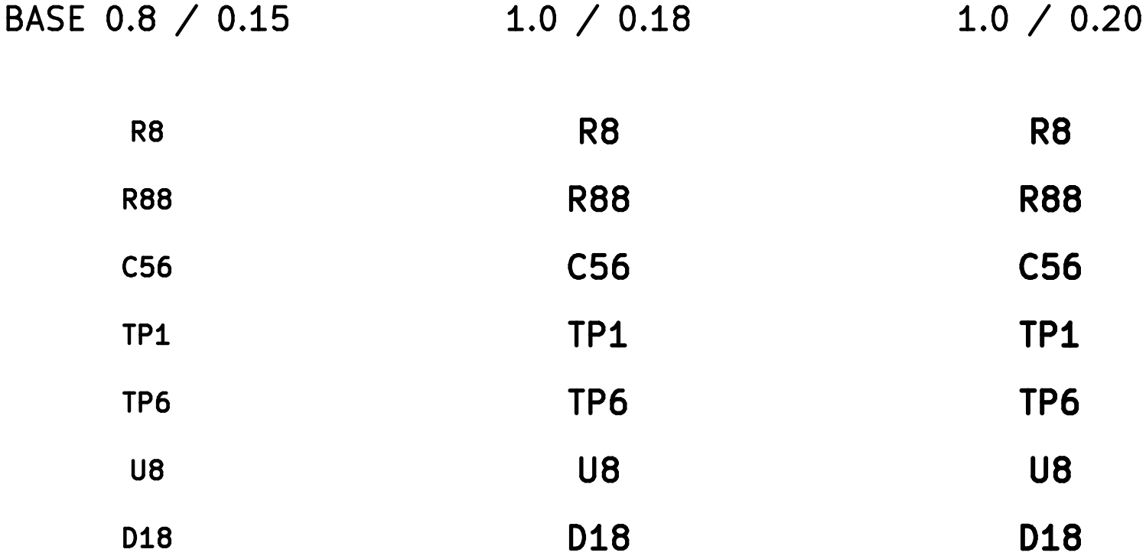
doc/v2/preview/font-comparison.png
