SSSound13/Cambridge_640A_PowerAmp/doc/v2/preview/front-silkscreen.png

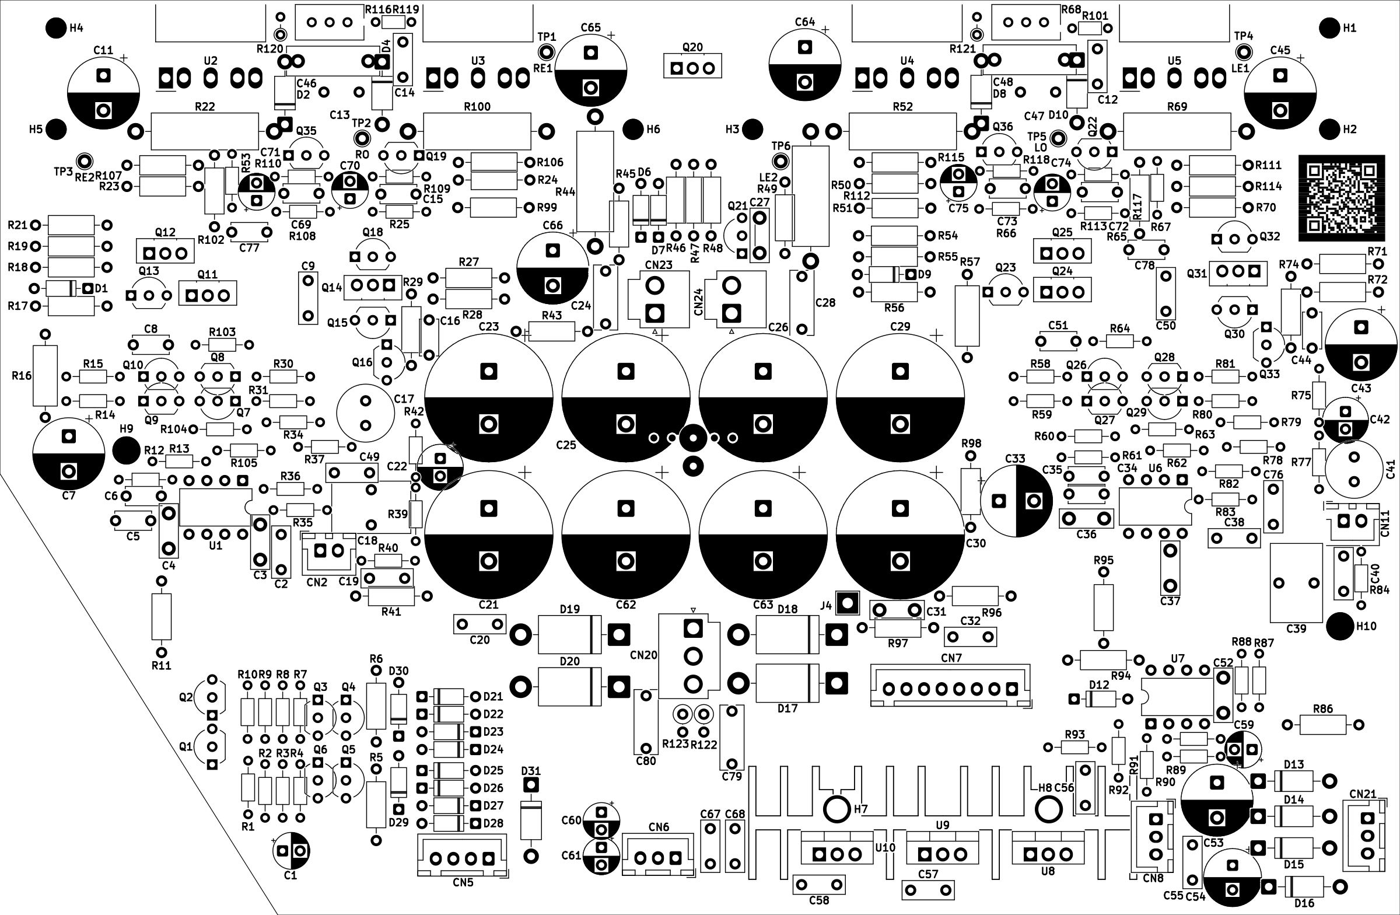
doc/v2/preview/front-silkscreen.png
