SSSound13/Cambridge_640A_PowerAmp/doc/v2/preview/R12_before_2026-11-07.png

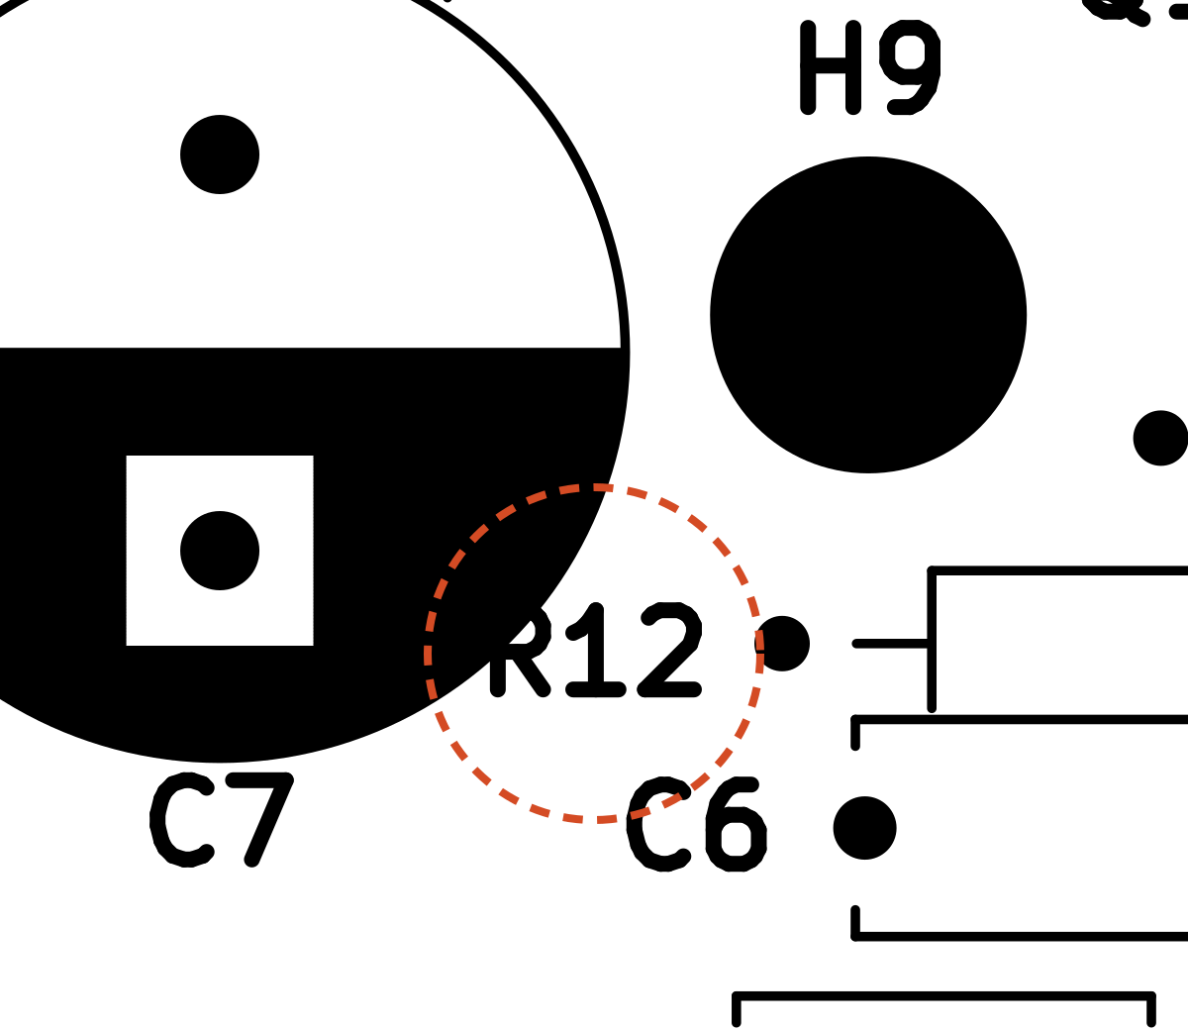
doc/v2/preview/R12_before_2026-11-07.png
