SSSound13/Cambridge_640A_PowerAmp/doc/v2/preview/top-qr.png

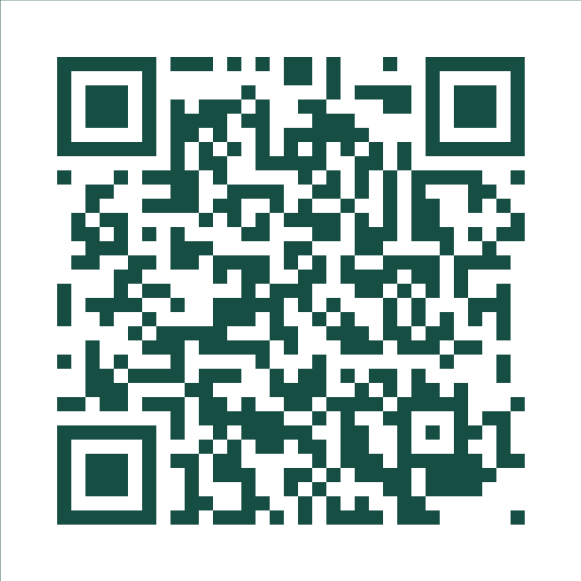
doc/v2/preview/top-qr.png
