SSSound13/Cambridge_640A_PowerAmp/BOM.md

# Перечень элементов (BOM) — Azur 640A Power Amp v2: минимальные исправления

Исходный BOM изготовленной v2 обновлён 06.11.2026 только для возврата U8=7805 и удаления C81. Всего **283 позиции**: 274 детали для пайки, 2 места не устанавливаются (C16, C44 — DNP), 7 площадок без деталей (TP1–TP6, J4). Перемычки net-tie NT1–NT3 — часть меди платы, в перечень не входят.

**Жирным** выделены элементы, которых нет в оригинале или которые заменены (в схеме у них пометка `**`). Остальное — номиналы оригинальной платы AP12707/6 по сервис-мануалу; «0,125 Вт» — резисторы с пометкой «8th» в мануале, резисторы без указания мощности — 0,25 Вт. Машиночитаемая версия — [`BOM.csv`](BOM.csv).

**Проверочная копия, не производственный релиз.** Расстановка и шаги остальных деталей сохранены как у изготовленной v2. Посадка использованного 7805 в готовую плату проверена при сборке. Проверить монтаж радиатора, изоляцию и тепловой режим. В исходниках выбран стандартный KiCad TO-220; готовые отверстия не меняются.

## Что купить, если переносите детали со своей платы 640A

Остальные детали предполагается перенести со старой платы, включая выходные модули SAP15N/SAP15P. Геометрия изготовленной v2 сохранена, но перечисленные ниже плотные посадки и фактические корпуса требуют проверки. Номера — каталог «ЧИП и ДИП», по которому детали заказывались.

| Кол-во | Обозначения | Деталь | Что это | Код «ЧИП и ДИП» |
|---:|---|---|---|---|
| 2 | C17, C41 | Panasonic ECE-A1AN221U | 220 мкФ 10 В неполярный, Ø8 (ОС) | 8072492276 |
| 2 | C18, C39 | WIMA MKS2D042201N00KO00 (MKS2-2.2U/100-R) | 2,2 мкФ 100 В плёнка MKS2 (вход) | 9000788913 |
| 4 | C24, C28, C79, C80 | TDK (EPCOS) B32560J3104K000 | 100 нФ 250 В MKT (Цобель, снабберы) | 8002013680 |
| 1 | CN20 | JST B3P-VH | разъём основной вторички | 222965310 |
| 1 | CN21 | JST B3B-XH-A | разъём вспомогательной вторички | 203820430 |
| 2 | CN23, CN24 | JST B2P-VH | разъёмы выходов на АС | 56245612 |
| 4 | D17, D18, D19, D20 | Diotec BY550-400 | диоды моста 5 А 400 В | 8026566344 |
| 4 | R41, R43, R96, R98 | TE Connectivity (Neohm) FRN50J150R/S | 150 Ом 0,5 Вт огнестойкие | 8003870514 |
| 2 | R44, R50 | Vishay AC03000004708JAC00 | 4,7 Ом 3 Вт проволочные (Цобель) | 8017149996 |
| 2 | R120, R121 | MF-25 0.25W 100R 1% | 100 Ом 1 % (ограничение подстроечника) | 47324 |
| 2 | R122, R123 | MO-50 0.5W 47R 5% | 47 Ом 0,5 Вт (снабберы) | 9000040018 |
| 1 | к CN20 | JST VHR-3N | ответная колодка | 341262979 |
| 2 | к CN23, CN24 | JST VHR-2N | ответные колодки | 22003845 |
| 1 | к CN21 | JST XHP-3 | ответная колодка | 56753032 |
| 7 | к CN20, CN23, CN24 | JST SVH-21T-P1.1 | контакты VH (обжим) | 765705792 |
| 3 | к CN21 | JST SXH-001T-P0.6 | контакты XH (обжим) | 320005067 |

Контакты лучше взять с запасом: обжим без родного инструмента не всегда получается с первого раза.

## Полный перечень

### Резисторы

| Кол-во | Обозначения | Номинал | Корпус | Деталь | Примечание |
|---:|---|---|---|---|---|
| 11 | R1, R2, R3, R8, R9, R10, R39, R42, R75, R77, R93 | 10k, 0,125 Вт | DIN0204, шаг 7,62 |  |  |
| 6 | R4, R7, R35, R83, R87, R91 | 4k7, 0,125 Вт | DIN0204, шаг 7,62 |  |  |
| 3 | R5, R6, R94 | 4k7 | DIN0207, шаг 10,16 |  |  |
| 8 | R11, R17, R21, R51, R56, R70, R95, R99 | 100R | DIN0207, шаг 10,16 |  |  |
| 4 | R12, R13, R60, R61 | 1M, 0,125 Вт | DIN0204, шаг 7,62 |  |  |
| 4 | R14, R15, R58, R59 | 47R, 0,125 Вт | DIN0204, шаг 7,62 |  |  |
| 2 | R16, R57 | 8k2 0,66 Вт | DIN0309, шаг 11,81 |  |  |
| 5 | R18, R29, R55, R74, R86 | 1k | DIN0207, шаг 10,16 |  |  |
| 4 | R19, R47, R48, R54 | 18k | DIN0207, шаг 10,16 |  |  |
| 4 | R22, R52, R69, R100 | 0.22R 3 Вт | DIN0516, шаг 19,69 |  |  |
| 4 | R23, R24, R111, R112 | 2k2 | DIN0207, шаг 10,16 |  |  |
| 4 | R25, R66, R108, R113 | 470R, 0,125 Вт | DIN0204, шаг 7,62 |  |  |
| 4 | R27, R28, R71, R72 | 150R | DIN0207, шаг 10,16 |  |  |
| 5 | R30, R31, R80, R81, R89 | 100R, 0,125 Вт | DIN0204, шаг 7,62 |  |  |
| 3 | R34, R79, R92 | 1k, 0,125 Вт | DIN0204, шаг 7,62 |  |  |
| 2 | R36, R82 | 33k, 0,125 Вт | DIN0204, шаг 7,62 |  |  |
| 2 | R37, R78 | 330k, 0,125 Вт | DIN0204, шаг 7,62 |  |  |
| 3 | R40, R84, R90 | 10R, 0,125 Вт | DIN0204, шаг 7,62 |  |  |
| 4 | **R41, R43, R96, R98** | **150R 0,5 Вт fusible** | DIN0207, шаг 10,16 | TE Connectivity (Neohm) FRN50J150R/S |  |
| 2 | **R44, R50** | **4R7 3 Вт wirewound** | DIN0516, шаг 18,42 | Vishay AC03000004708JAC00 | ставить на выводах ~3 мм над платой (иначе касается R45); можно родные со старой платы |
| 2 | R45, R49 | 47k | DIN0207, шаг 10,16 |  |  |
| 1 | R46 | 4k7, 0,125 Вт | DIN0207, шаг 10,16 |  |  |
| 1 | R53 | 150R, 0,125 Вт | DIN0204, шаг 7,62 |  |  |
| 4 | R62, R63, R104, R105 | 220k, 0,125 Вт | DIN0204, шаг 7,62 |  |  |
| 3 | R64, R67, R103 | 150R | DIN0204, шаг 7,62 |  |  |
| 2 | R65, R102 | 33k | DIN0207, шаг 10,16 |  |  |
| 2 | R68, R116 | 47R | Bourns 3296W |  | подстроечник тока покоя |
| 1 | R88 | 11k, 0,125 Вт | DIN0204, шаг 7,62 |  |  |
| 1 | R97 | 47R | DIN0207, шаг 10,16 |  |  |
| 2 | R101, R119 | 47R, 0,125 Вт | DIN0204, шаг 5,08 |  |  |
| 4 | R106, R107, R114, R115 | 100k | DIN0207, шаг 10,16 |  |  |
| 4 | R109, R110, R117, R118 | 820R, 0,125 Вт | DIN0204, шаг 7,62 |  |  |
| 2 | **R120, R121** | **100R 1%** | DIN0204 вертикально | MF-25 0.25W 100R 1% |  |
| 2 | **R122, R123** | **47R 0,5 Вт MO** | DIN0207 вертикально | MO-50 0.5W 47R 5% | номинал подобрать по звону вторички |

### Конденсаторы

| Кол-во | Обозначения | Номинал | Корпус | Деталь | Примечание |
|---:|---|---|---|---|---|
| 1 | C1 | 1u 16V | радиальный Ø5, шаг 2,5 |  |  |
| 2 | C2, C38 | 100p poly | 7,2×2,5 мм, шаг 5 |  |  |
| 6 | C3, C4, C31, C36, C37, C52 | 100n | диск Ø7,5, шаг 5 |  |  |
| 4 | C5, C6, C34, C35 | 5p | диск Ø5, шаг 5 |  |  |
| 8 | C7, C11, C33, C43, C45, C64, C65, C66 | 220u 50V | радиальный Ø10, шаг 5 |  | C7/C33/C43/C66 желательно на 63 В |
| 2 | C8, C51 | 470p | диск Ø5, шаг 5 |  |  |
| 2 | C9, C50 | 33p | 7,2×2,5 мм, шаг 5 |  |  |
| 2 | C12, C14 | 15n poly | 7,2×2,5 мм, шаг 5 |  |  |
| 2 | C13, C47 | 10u NP 16V | радиальный Ø5, шаг 5 |  |  |
| 4 | C15, C69, C72, C73 | 220p | диск Ø5, шаг 5 |  |  |
| 2 | C16, C44 | 5p | диск Ø5, шаг 5 |  | **не устанавливать** (DNP), место под коррекцию на случай возбуждения |
| 2 | **C17, C41** | **220u NP 10V (D8)** | радиальный Ø8, шаг 3,5 | Panasonic ECE-A1AN221U |  |
| 2 | **C18, C39** | **2u2 100V film (MKS2)** | 7,2×11 мм, шаг 5 | WIMA MKS2D042201N00KO00 (MKS2-2.2U/100-R) |  |
| 10 | C19, C20, C32, C40, C55, C56, C57, C58, C67, C68 | 47n poly | 7,2×2,5 мм, шаг 5 |  |  |
| 8 | C21, C23, C25, C26, C29, C30, C62, C63 | 2200uF | радиальный Ø18, шаг 7,5 |  |  |
| 2 | C22, C42 | 47u 50V | радиальный Ø6,3, шаг 2,5 |  | C22 брать Ø5 мм — место тесное |
| 4 | **C24, C28, C79, C80** | **100n 250V MKT** | 9×3,2 мм, шаг 7,5 | TDK (EPCOS) B32560J3104K000 |  |
| 1 | C27 | 4.7n | диск Ø7,5, шаг 5 |  |  |
| 2 | C46, C48 | 100n 160V Poly | 13×4 мм, шаг 10 |  |  |
| 2 | C49, C76 | 2.2n PPE Bypass (640A only) | 7,2×2,5 мм, шаг 5 |  |  |
| 1 | C53 | 470u 35V | радиальный Ø10, шаг 5 |  |  |
| 1 | C54 | 100u 35V | радиальный Ø8, шаг 3,5 |  |  |
| 1 | C59 | 47u 16V | радиальный Ø5, шаг 2,5 |  |  |
| 2 | C60, C61 | 100u 16V | радиальный Ø5, шаг 2,5 |  |  |
| 4 | C70, C71, C74, C75 | 220u 16V | радиальный Ø5, шаг 2,5 |  |  |
| 2 | C77, C78 | 22p | диск Ø5, шаг 5 |  |  |

### Диоды

| Кол-во | Обозначения | Номинал | Корпус | Деталь | Примечание |
|---:|---|---|---|---|---|
| 2 | D1, D9 | ZEN 3V3 | DO 35, шаг 7,62 |  |  |
| 4 | D2, D4, D8, D10 | 1N4004 | DO 41, шаг 8,89 |  |  |
| 10 | D6, D12, D21, D22, D23, D24, D25, D26, D27, D28 | 1N4148 | DO 35, шаг 7,62 |  |  |
| 1 | D7 | 4V7 Zener 400mW | DO 35, шаг 7,62 |  |  |
| 5 | D13, D14, D15, D16, D31 | 1N4004 | DO 41, шаг 10,16 |  |  |
| 4 | **D17, D18, D19, D20** | **BY550-400** | DO 201AD, шаг 13,97 | Diotec BY550-400 |  |
| 2 | D29, D30 | 10V Zener 400mW | DO 35, шаг 7,62 |  |  |

### Транзисторы

| Кол-во | Обозначения | Номинал | Корпус | Деталь | Примечание |
|---:|---|---|---|---|---|
| 2 | Q1, Q2 | BC327 | TO-92 |  |  |
| 4 | Q3, Q4, Q5, Q6 | BC337 | TO-92 |  |  |
| 9 | Q7, Q8, Q15, Q16, Q21, Q28, Q29, Q30, Q33 | MPSA92/93 | TO-92 |  |  |
| 10 | Q9, Q10, Q18, Q19, Q22, Q26, Q27, Q32, Q35, Q36 | MPSA42/43 | TO-92 |  |  |
| 5 | Q11, Q12, Q20, Q24, Q25 | MJE340 | TO-126 |  |  |
| 2 | Q13, Q23 | MPSA13 | TO-92 |  |  |
| 2 | Q14, Q31 | MJE350 | TO-126 |  |  |

### Микросхемы и модули

| Кол-во | Обозначения | Номинал | Корпус | Деталь | Примечание |
|---:|---|---|---|---|---|
| 2 | U1, U6 | NE5534 | DIP-8 |  |  |
| 2 | U2, U4 | SAP15P | TO-3P-5 (лёжа на радиаторе) |  | Sanken, снят с производства — переставить со старой платы |
| 2 | U3, U5 | SAP15N | TO-3P-5 (лёжа на радиаторе) |  | Sanken, снят с производства — переставить со старой платы |
| 1 | U7 | LM393 | DIP-8 |  |  |
| 1 | U8 | 7805 | TO-220 стандартный KiCad, отверстия проекта Ø1,1 мм | на изготовленной v2 Ø1,0 мм, посадка проверена при сборке | без изолятора, с термопастой на целый AP12106/1 |
| 1 | U9 | 7815 | TO-220 |  | изоляционный комплект и термопаста |
| 1 | U10 | 7915 | TO-220 |  | изоляционный комплект и термопаста |

### Разъёмы

| Кол-во | Обозначения | Номинал | Корпус | Деталь | Примечание |
|---:|---|---|---|---|---|
| 2 | CN2, CN11 | H2 2.54mm | JST XH, шаг 2,5 |  |  |
| 1 | CN5 | H4 2.54mm | JST XH, шаг 2,5 |  |  |
| 2 | CN6, CN8 | H3 2.54mm | JST XH, шаг 2,5 |  |  |
| 1 | CN7 | H8 2.54mm | JST XH, шаг 2,5 |  |  |
| 1 | **CN20** | **B3P-VH** | JST VH, шаг 3,96 | JST B3P-VH |  |
| 1 | **CN21** | **B3B-XH-A** | JST XH, шаг 2,5 | JST B3B-XH-A |  |
| 2 | **CN23, CN24** | **B2P-VH** | JST VH, шаг 3,96 | JST B2P-VH |  |

### Прочее

| Кол-во | Обозначения | Номинал | Корпус | Деталь | Примечание |
|---:|---|---|---|---|---|
| 1 | J4 | CHASSIS | площадка 3×3 мм |  | клемма связи PGND с корпусом (провод на стойку), деталь не нужна |
| 6 | **TP1–TP6** | **RE1, RO, RE2 / LE1, LO, LE2** | площадка Ø2 мм |  | контрольные точки для настройки тока покоя, деталь не нужна |

## Сборка: на что обратить внимание

- **R44, R50** (проволочные 3 Вт, Ø4,8 мм) ставить на выводах примерно в 3 мм над платой — иначе корпус R44 касается R45. Родные резисторы со старой платы встают без зазора.
- **C18** (WIMA 11 × 7,2 мм) стоит почти вплотную к соседям; проверить фактический монтаж. C81 в этой копии удалён. На уже изготовленной плате его не ставить/снять и исключить контакт оставшихся площадок с радиатором.
- **C22** — брать диаметром 5 мм: рядом C21 и R42.
- Пары TO-92 с шагом 3,5 мм (Q3/Q4, Q5/Q6, Q7/Q8, Q9/Q10, Q26/Q27, Q28/Q29) стоят так же плотно, как на заводской плате, — ставить с наклоном.
- **U2–U5 (SAP15)** лежат корпусом к радиатору, за верхний край платы; спинку класть на изолирующую прокладку, как на заводской плате. U9/U10 — через изоляторы, как в оригинале.
- **R122, R123** (снабберы) — номинал 47 Ом стартовый, подобрать по звону вторичной обмотки.
- Ток покоя: напряжение на каждом эмиттерном резисторе 0,22 Ом (между TP1–TP2, TP2–TP3 и TP4–TP5, TP5–TP6) — не меньше 13 мВ.

- **U8 (7805)**: U8 без изолятора, с пастой; U9/U10 с электрической изоляцией, как требует мануал p.25. Отдельная связь H8 с digital удалена в проекте; радиатор связан с digital через фланец U8. На уже изготовленной плате изменение исходника само по себе не разрывает старую дорожку H8.
- **C56/R92/R93** остаются на своих местах. C56 расположен в промежутке рёбер радиатора, но запас по монтажному виду около 0,38 мм: обязательна реальная примерка.
- Проверить измеренные Vin, нагрузку +5 V, допустимые напряжения фактического 7805/C53 и нагрев всех трёх стабилизаторов. Неподтверждённое число 25 В в расчёте не используется.
- **J4/корпус:** в схеме сохранена связь через R97 47 Ω параллельно C31 100 нФ. Не заменять её прямым проводом к NT1 на основании противоречивого исторического примечания.
