SSSound13/Cambridge_640A_PowerAmp/doc/v2/VALIDATION.md

# Проверки исправленных исходников v2

Результаты ниже относятся к файлам проекта, а не к готовому усилителю под нагрузкой.

## Обновление платы и Gerber от 07.11.2026

По решению пользователя исправлено только поле Reference R12: X = 64,500 мм сохранён; Y = 118,250 → 119,050 мм (на 0,8 мм вниз). Размер 1,0 × 1,0 мм, толщина 0,20 мм и угол сохранены. Все 19 пересечений R12/C7 устранены. Остальные четыре пары R121/U4, R112/R50, R65/C78 и R25/Q18 добавлены в конкретные исключения KiCad, без отключения правил.

DRC KiCad 10.0.7 с перезаливкой зон и сравнением со схемой: **0 ошибок, 0 активных предупреждений, 0 неразведённых соединений, 0 расхождений со схемой**. [Текущий отчёт](validation/gerber_2026-11-07_drc.json). [С исключениями](validation/silkscreen_2026-11-07_drc_with_exclusions.json): 146 исключённых нарушений, из них 142 прежних courtyard и четыре принятых пересечения шелкографии. [До изменения](validation/silkscreen_2026-11-07_before.json): 23 предупреждения.

[Текущие Gerber и сверловка](../../gerber/) повторно сформированы из исходника в том же коммите. Проверка файлов без меток времени подтверждает: изменился только F.Silkscreen; медь четырёх слоёв, маски, остальные слои, сверловка и IPC-D-356 неизменны. В PCB изменена ровно одна строка положения R12; компоненты, площадки, QR, исправленная цепь U6 и остальные данные платы сохранены побайтно. Схемы не менялись; ERC заново не запускался.

[Контроль изменений](validation/silkscreen_2026-11-07_validation.json). [R12 до](preview/R12_before_2026-11-07.png) и [R12 после, финальный Gerber](preview/R12_after_2026-11-07.png).

PCB SHA256 текущего исходника: `fab5ad2d169c11edd13225c05fcc267cca08748494c56a05c9273d19f9d117da`.

## Архивные проверки предыдущей платы

Файлы `final_drc.json`, `final_erc.json`, `SUMMARY.json` и остальные прежние отчёты в `validation/` сохранены как исторические результаты. Они не являются повторной проверкой коммита `5dcab897b116dd5cd4a2f4a718dbb827556a5aa2`. Для текущего экспорта используйте новый отчёт выше; ERC в рамках экспорта заново не запускался.

Проверено KiCad 10.0.7, 07.11.2026. PCB SHA256: `6fa50d8fba04d5a24a0f95fd23892cc0ee665c719e176e5d658fea1c7677dd55`.

- [ERC](validation/final_erc.json): 0 зарегистрированных нарушений.
- [DRC](validation/final_drc.json): 0 неисключённых нарушений, 0 неразведённых соединений, 0 расхождений со схемой. Остались 142 прежних исключения пересечений courtyard, которые не были устранены перемещением деталей. Новых исключений нет; четыре устаревшие записи удалены.
- Все 296 оставшихся footprints сохранили координаты, углы и UUID. Все центры площадок сохранены; геометрия U8 изменена на стандартный TO-220. Остальные отверстия, 21 via и контуры зон не менялись.
- От изготовленной базы удалены 6 сегментов: мост U6, четыре ветви C81, отдельная ветвь H8. Исправлены назначения 12 сегментов и четырёх площадок цепи U6. Схема потеряла только C81 и ошибочное присоединение цепи U6 к +15V.
- Нативная связность после графических правок совпадает с проверенным электрическим вариантом: 2049 объектов, 43281 связь. Контрольная перезаливка в отдельной копии не изменила соединений. В публикуемом PCB сохранены исходные заполнения.
- U6.2 соединён только с C34.1/R60.1/R63.2. H8 в медной модели без сети, но собранный радиатор соединяется с digital через U8.
- Все 303 видимых текста шелкографии имеют 1,0 × 1,0 мм / 0,20 мм. Удалены 26 K, все 28 катодных полос сохранены. В локальных библиотеках K тоже удалены; обновление внешних Diode_THT из библиотеки может вернуть их на PCB.
- QR перенесён на F.SilkS под H2, над R71: 12,3 × 12,3 мм с полем, модуль 0,30 мм. Прочитан из native-экспорта при 200/300/600/1200 dpi. Только 248 QR-полигонов отличаются от предыдущей main; остальные байты PCB и все схемы сохранены. Текстовый URL остаётся снизу.
- До надписи R71 0,493 мм, до края платы 2,126 мм. При условной шайбе H2 Ø6 мм зазор до QR составляет 0,631 мм. Размер крепежа, выступ кронштейна, провода, физическая печать и видимость в собранном корпусе требуют проверки.
- Два существующих поясняющих текста о L/R на листах каналов сохранены из предыдущей main. Они не меняют нетлист. Финальные ERC/DRC повторены именно с ними.

## Сохранённые отключённые правила

Проверки выполнены с прежними настройками проекта. Нулевой результат не распространяется на отключённые правила.

ERC: `power_pin_not_driven`, `single_global_label`, `four_way_junction`, `simulation_model_issue`, `lib_symbol_mismatch`, `footprint_filter`.

DRC: `footprint_filters_mismatch`, `footprint_type_mismatch`, `lib_footprint_mismatch`, `missing_courtyard`, `npth_inside_courtyard`, `pth_inside_courtyard`, `track_not_centered_on_via`, `tuning_profile_track_geometries`.

Настройки: [640A_PowerAmp.kicad_pro](../../640A_PowerAmp.kicad_pro).

## Что этим не доказано

Работа защиты, токи покоя, шум и искажения, устойчивость, реальные зазоры и высоты деталей, электрическая изоляция радиатора/крепежа, температурный запас, безопасность сетевой части и соответствие нормам не подтверждены этими файловыми проверками. Требуются проверка монтажа, безопасный запуск и измерения на реальном устройстве. Старые Gerber от 03.10 не содержат нынешних исправлений.
