SSSound13/Cambridge_640A_PowerAmp/CHANGELOG.md

# История изменений

Проект: Cambridge Audio Azur 640A (V1), Power Amp PCB AP12707/6 — схема и плата в KiCad.
Актуальные изменения, их причины и ограничения описаны в README и `doc/v2/MINIMAL_FIXES.md`. Ранние обзоры сохранены как история. Здесь приведена хронология исправлений проекта.

## 2026-11-07 — QR на верхней стороне v2

* QR перенесён с B.SilkS на F.SilkS под H2, над R71: X234,50…246,80 / Y72,00…84,30 мм. Размер 12,3 × 12,3 мм вместе с защитным полем, модуль 0,30 мм, поле по 1,20 мм. Изображение читается сверху без зеркального отражения.
* Полный GitHub URL и остальные три текстовые строки снизу сохранены. Изменены только 248 графических полигонов QR; компоненты, отверстия, медь, схемы, настройки проекта и библиотеки не менялись.
* ERC 0; DRC без новых нарушений, 0 неразведённых соединений и расхождений со схемой; прежние 142 courtyard-исключения сохранены. Нативная медная связность совпадает с предыдущей main.
* QR прочитан из нативного экспорта при 200/300/600/1200 dpi. Обновлены изображения платы и проверки. Требуются белая шелкография и тёмная маска; физическая печать, крепёж H2 и обзор внутри корпуса ещё не проверены. При условной шайбе Ø6 мм зазор до поля QR составляет 0,63 мм.
* Ветка v3, производственный архив и старые Gerber не изменены. Новые производственные файлы не выпускались.

## 2026-11-06 — минимальные исправления v2, проверка продолжается

* Исправлена ошибочная сеть U6.2/+15V в схеме и удалён F.Cu мост C34.1–C36.1. Положение элементов и оставшаяся геометрия цепи сохранены.
* U8 возвращён к 7805 со стандартным KiCad TO-220. В новых исходниках его сверловка Ø1,1 мм; готовая плата с Ø1,0 мм не рассверливается. U9/U10 уже стандартные.
* Удалены C81, четыре его конечные ветви и отдельная дорожка H8–digital. Изоляция U9/U10 обязательна; радиатор связан с digital через фланец U8.
* Все 296 оставшихся компонентов, включая C56/R92/R93, сохранили координаты. NT1.1 возвращён к Ø1,0 мм изготовленной базы; подключение корпуса через J4 и R97 ∥ C31 сохраняется, прямой обход к NT1 не предлагается.
* Шелкография приведена к 1,0 мм / 0,20 мм для всех 303 текстов. Удалены 26 букв K у диодов, сохранены катодные полосы. Добавлены обозначения сетей TP, контур общего радиатора, QR и полный GitHub URL.
* У двух подписей остаётся перекрытие модельными корпусами: R117/R65 и R39/C18. Геометрия прижимной планки и дополнительная маркировка металлической стороны TO-126/SAP15 не утверждены.
* Обновлены BOM и публичное описание. Сохранены поясняющие заметки L/R на схемах каналов. Четыре устаревших исключения удалены, новых нет.
* ERC 0; DRC 0 неисключённых, 0 неразведённых, 0 расхождений со схемой при прежних настройках. Сохраняются 142 courtyard-исключения, 6 отключённых типов ERC и 8 DRC. Проверка медной связности и контрольная перезаливка пройдены. Это не проверка реальной платы под питанием.
* **Версия 2 находится в состоянии проверки. Информация будет обновлена после проверки.** Реальная механика, изоляция, нагрев и электрические испытания ещё требуют подтверждения.
* Архив `640A_PowerAmp_v2_fab_2026-10-03.zip` и `gerber/` сохранены побайтно как история изготовленной v2, включая ошибку U6. Новые производственные файлы не выпускались. Ветка v3 не изменялась.

## 2026-11-06 — нумерация ревизий

* Изготовленная плата и её производственные файлы сохраняют обозначение v2.
* Следующей ревизии присвоен номер v3; план в TODO и ссылка в README обновлены.
* Изменена только документация; схема, плата и Gerber не менялись.

## 2026-11-05 — зафиксирован план следующей ревизии

* Добавлен `TODO.md` с намерениями по замечаниям пользователя 01–04.11:
  резисторы и шаги, контрольные точки, QR-код, выравнивание, шелкография,
  ориентация TO-126, контур радиатора и двухлапковый Faston у J4.
* Отдельно записана задача документации по двум вариантам переноса/покупки
  деталей и отмена задачи универсального посадочного места SAP15/STD03.
* В README добавлена ссылка на план. Это фиксация намерений для следующей
  ревизии после изготовленной v2; схема, плата и Gerber не менялись.

## 2026-10-17 — README: состояние проекта

* README: строка состояния обновлена — первая партия изготовлена по Gerber от 2026-10-03, после неё правка NT1
  (2026-10-14); Gerber в `gerber/` относятся к первой партии и для следующего заказа выгружаются заново.

## 2026-10-14 — NT1: отверстие PGND под провод на корпус

**Устарело: провод к корпусу к NT1 не подключать; см. исправление 06.11.2026 выше.**

* **NT1.1 (PGND, площадка Ø4,0): сверловка 1,0 → 1,6 мм** — под провод на корпус 0,75–1 мм². Поясок 1,2 мм.
  Размер 1,6 мм уже есть в сверловке (T11), новый инструмент не добавлен. NT1.2 (GND, Ø3,0) — без изменений, 1,0 мм:
  провод к ней не подключается. Посадочное место `640A:NetTie-2_THT_Star` в библиотеке исправлено так же.
* Изготовленная партия (Gerber от 2026-10-03) — с отверстием 1,0 мм. Gerber/сверловку для следующего заказа нужно выгрузить заново после DRC.

## 2026-10-03, поздний вечер — пояснение к именам цепей каналов (L/R) и LK27

* README («Нумерация элементов»): добавлено пояснение, что имена цепей каналов взяты из мануала и буквы L/R в них
  не совпадают с каналом (лист Left Channel — `RO`, `RE1`, `RE2`, `RFCLIP`, `RICLIP`; Right Channel — `LO`, `LE1`, …).
  LK27 перенесена в раздел «Перемычки LK» (её нет в мануале, но она была на реальной плате; заменена дорожкой).
* Схема: на листы Left/Right Channel добавлена текстовая заметка с тем же пояснением (под блоком «Changes»).
  Соединения, имена цепей и плата не менялись; Gerber не затронуты.

## 2026-10-03, вечер — публикация на GitHub: описание, сравнение с оригиналом, перечень деталей

* README: в начало добавлены разделы «Преимущества новой платы», «Сравнение с оригиналом», «Перечень деталей»,
  «Что не проверено»; таблица «Состав проекта» приведена к фактическому содержимому репозитория.
* Новые файлы `BOM.md` и `BOM.csv` — перечень элементов из схемы (284 позиции, 275 деталей для пайки),
  отдельно — что докупить при переносе деталей со старой платы, с кодами «ЧИП и ДИП».
* Схема и плата не менялись.

## 2026-10-03 — перед заказом: контрольные точки TP3/TP6, зазор меди у крепёжных отверстий

* **TP3 (RE2) и TP6 (LE2) сдвинуты на 3,5 мм вниз** (TP3 → 62,025; 72,915, TP6 → 160,926; 72,915), к ним добавлены
  перемычки 1,0 мм (TP3 — F.Cu, TP6 — B.Cu) от прежних мест. Открытая медь площадок была в 3,1 мм от центра
  отверстий кронштейнов H5/H3 и попадала под шайбу M3 Ø7 → риск замыкания выхода канала на кронштейн.
  Теперь ближайшая открытая медь — 5,0 мм от центра (шайба Ø7 — запас 1,5 мм, Ø9 — 0,5 мм).
* **H1–H6 (NPTH 3,0 мм): местный зазор площадки 0,5 мм** — полигон PGND на In2.Cu отступает от края отверстия
  на 0,5 мм (было 0,24 мм).
* Надпись R49 перенесена влево от вывода (мешала окружность TP6).
* Полигоны перезалиты. DRC: 0 ошибок, 0 предупреждений, 0 неразведённых, соответствие схеме — 0 расхождений
  (`doc/DRC_2026-10-03_final.rpt`). Gerber, сверловка и IPC-D-356 в `gerber/` выгружены заново.
* Независимая проверка по Gerber и сверловке: все 147 цепей целые, замыканий нет, земли PGND/GND/digital/AUX0V
  соединены только перемычками NT1–NT3; схема ↔ плата — 648 выводов, расхождений нет.
* Копия платы до правки — `_archive_2026-10-03_before_tp_npth/`.

## 2026-09-29, вечер — SAP15 лёжа: посадочное место, 3D-модель, освобождена зона над корпусом

Копии до правок — `_archive_2026-09-29_before_sap15/` (плата, проект, схемы левого и правого каналов).

* **U2–U5 (SAP15N/P) лежат корпусом к верхнему краю платы** (на радиатор). Новое посадочное место
  `640A:TO-3P-5_SAP15_Horizontal`: площадки те же; на Fab — лежачий корпус 15,4 × 28 мм с отверстием Ø3,2
  (загиб выводов 5 мм от ряда площадок, корпус выходит за край платы на ~17 мм); courtyard закрывает весь
  корпус (±8,25 мм от центрального вывода, с допуском 0,3 мм) — DRC больше не даст поставить элемент под SAP15.
  Схема (левый/правый канал) обновлена тем же посадочным местом.
* **3D-модель** `640A.3dshapes/TO-3P-5_SAP15_Horizontal.wrl` (+ `.step` для MCAD) — по чертежу `doc/SAP15.pdf`:
  корпус 15,4 × 28 × 4,5 мм, металлическая спинка 1,6 мм вниз, выводы 0,8 × 0,65 мм с широкой частью у корпуса,
  загиб в 5 мм от площадок. Проверена в KiCad 9 (3D-просмотр, оба формата).
* **Полоса между двумя SAP15 канала расставлена равномерно** (между U2 и U3, между U4 и U5 — по 22,6 мм):
  R120 (вертикально) | подстроечник R116 | R119 — зазоры корпус–корпус ≈1,07 мм везде, в том числе до
  корпусов SAP15 (раньше 0,2–0,5 мм). Правый канал — зеркально по шагу 98,956 мм (R121 | R68 | R101).
  R119/R101 (47R 1/8 Вт) переведены на посадку DIN0204 с шагом 5,08 мм вместо 7,62 — иначе в ряд не
  помещается. R120/R121 — DIN0204 вертикально (корпус MF-25 Ø2,3 проходит). Пересечений courtyard в полосе
  больше нет — исключения R116/R119 и R68/R101 удалены.
* **Под корпусами SAP15 нет меди F.Cu и переходных** (проверено по контуру корпуса с допуском 0,3 мм).
  Переразведено:
  - BIAS_LO (U2.4/U4.4 → R120/R121): F.Cu вверх в зону выводов (y 58,9), вправо за край корпуса, вверх
    мимо корпуса к R120.2; R120.2 → выводы 1–2 подстроечника по B.Cu.
  - BIAS_HI (U3.2/U5.2 → подстроечник, R120/R121): F.Cu вниз под выводы, по y 64,3–64,5 влево
    (между C13/C47 и выходной дорожкой RO/LO), вверх между выводами C46/C48 и C13/C47 к выводу 3
    подстроечника; R120.1 → вывод 3 по F.Cu.
  - digital (Q20.1 → …) шла по F.Cu вдоль верхнего края под U4: теперь от Q20.1 идёт ниже выводов U4
    (y 63,25, параллельно Net-(Q20-B)) и сходится с прежней диагональю к (200,8; 73,3).
  - RO → R119 и LO → R101: от вершины ствола по B.Cu 2,0 / 1,5 мм (как было); R119.1→C14.1, R101.1→C12.1
    по B.Cu 0,8.
* **Ширины не уменьшены:** все новые отрезки той же ширины, что заменённые (bias 0,8; digital 0,6/0,8;
  RO 2,0; LO 1,5). Связность всех цепей по площадкам не изменилась, зазоры ≥0,2 мм (до отверстий ≥0,25,
  до края ≥0,5) — проверено скриптом по всей зоне y 49–70.
* **Нужно прогнать DRC в KiCad 10** (формат файла — KiCad 10; KiCad 9 его не открывает): перезаливка зон,
  шелкография в полосе (надписи R116/R119/R120 и др.).
* TP1/TP4 — вне корпуса при ширине 15,4 мм (вид спереди в datasheet); на виде снизу указано 17,8 мм —
  если корпус окажется шире, TP1/TP4 попадут под него.
* Под корпусом остаются дорожки B.Cu (±45V к развязке) — медь закрыта платой, но корпус всё равно
  ставить на изолирующую прокладку, если спинка лежит на плате.

## 2026-09-29 — доделка по разделу «Что осталось»: вторая колонна −45V к U2, R120, комментарии исключений

Копии до правок — `_archive_2026-09-28_routing_review/640A_PowerAmp.kicad_pcb.step1_2026-09-28` (плата после правок 28.09) и `640A_PowerAmp.kicad_pro.before_2026-09-29`; скрипты — там же в `scripts/` (`apply2.py`, `hop.py`, `plan2.json`).

* **Вторая колонна −45V к U2 на In1.** Между полигоном +45V (x 113–123,5) и центром платы был свободный коридор: новая зона −45V x 124,1–132,3, y 50,8–132 (приоритет 1, зазор 0,5 мм), сверху соединена со старой полосой через полосу над верхом полигона +45V (x 111,5–124,1, y 50,8–56,4; 0,6 мм до +45V), снизу питается прямо с шины батареи через 4 переходных отверстия 1,2/0,6 мм на самой шине (x 128,4/130,2, y 128,9/130,7). Сечение по заливке: колонна ≥5,0 мм (ряд R100.1), полоса над +45V 5,65 мм, старая полоса 5,75 мм. Старая колонна x 104–112,4 с рядами Q19/Q14 осталась параллельным путём. Итого питание всех четырёх выходных транзисторов ≥3,9 мм при 35 мкм: U3/U4 4,95; U5 3,9; U2 5,0 по новой колонне. Элементы не двигались.
* **Сигнал PIC OVERCURRENT/SHORT** шёл по In1 наискосок через новый коридор (141,1/86,9 → 126,3/101,7). На участке пересечения перенесён на F.Cu: In1 до (134,5/93,5), переходное 0,6/0,3, F.Cu (134,5/93,5)→(126,3/101,7)→(126,3/105,6), переходное 0,6/0,3, дальше прежняя вертикаль по In1 от y 105,6 (участок 101,7–105,6 удалён: под ним шина +45V на B.Cu, зазор отверстия ≥0,5 мм).
* **R120 повёрнут** (90° → 180°): вывод 2 переехал с (88,08/52,39) на (85,54/54,93), оба вывода в одном ряду, полоса −45V под R116/R120 выросла с 3,55 до 5,75 мм. Связи: F.Cu-диагональ к U2.4 начинается от нового вывода (45° сохранён), к прежней B.Cu-дорожке на R116.1 добавлена B.Cu-диагональ 0,8 мм. Надпись R120 перенесена над корпус (была бы на шелкографии C46).
* **Комментарии исключений DRC** у пар корпусов, которые по контурам Fab перекрываются (в комментариях они были названы «без контура на Fab»): Q21/C27 0,50 мм, R109/Q19 0,27, R117/Q22 0,06, R49/R50 0,09, Q26/Q27, Q28/Q29, Q9/Q10, Q7/Q8 — 0,74 мм, Q3/Q4, Q5/Q6 — 0,23 мм. Корпуса не двигались: пары TO-92 с шагом 3,5 мм и Q21 у C27 ставятся с наклоном, как на заводе.
* **3D-модели разъёмов на месте:** у всех CN2–CN24 в файле платы ссылки `${KIPRJMOD}/640A.3dshapes/JST_*.step`, файлы (JST XH — библиотечные KiCad, JST VH — упрощённые) лежат в `640A.3dshapes/`, kicad-cli их грузит и рендерит (`_archive_2026-09-28_routing_review/render_cn20.png`). Если в 3D-просмотре разъёмов нет — рядом с `640A_PowerAmp.kicad_pro` нет папки `640A.3dshapes`; скопировать её из этой копии проекта.
* Проверки: ERC 0/0; DRC (KiCad 10, перезаливка зон, соответствие схеме) — 0 ошибок, 0 неразведённых, только 148 исключённых пересечений courtyard (`doc/DRC_after_routing_review_2026-09-29.rpt`). Файл платы сохранён kicad-cli, CRLF.

## 2026-09-28, 18:35 — проверка разводки после переразводки: питание выходных каскадов и полигоны

Копия платы до правок — `_archive_2026-09-28_routing_review/640A_PowerAmp.kicad_pcb.before`; скрипты проверки и план правок — там же в `scripts/`. Подробный отчёт — `REVIEW_ROUTING_2026-09-28.md`.

* **Ввод ±45V в полигоны In1 для U2 и U5 шёл только через площадки R41.2/R98.2** (fusible 150R: площадка Ø1,6 мм, отверстие 0,8 мм, тепловые мостики 4 × 1,0 мм × 35 мкм). Шины батареи на B.Cu кончались на этих площадках, других связей полигонов с шиной не было. Добавлены переходные отверстия 1,2/0,6 мм на шинах внутри полигонов: 3 у R41 (−45V; зона расширена под них — x 112,4–116,5, y 131,6–136,5) и 2 у R98 (+45V). Для симметрии по 2 таких же отверстия у C23.1 (+45V, U3) и C30.2 (−45V, U4), где полигон питался через одну гильзу конденсатора.
* **Полигон +45V у U5.3 заканчивался на y = 61,0 при центре площадки 61,07** — связь держалась на перекрытии медью площадки. Язычок продлён до y = 63,2, как у U2.
* **Сечения полигонов In1 (35 мкм) с учётом вырезов под площадки** измерены по заливке: −45V→U2 — верхняя полоса 1,1 мм у R120, колонна 1,7 мм в ряду Q19 и 2,1 мм в ряду Q14/R27–R29; +45V→U5 — полоса 3,1, колонна 3,25 мм; +45V мост→батарея — 4,75 мм в ряду NT1–NT3/C25.2/C26.2; PGND (In2) между рядами батареи — 4,35 мм у NT1.2 и 4,65 мм у CN20.3. По критерию из README (3,5 мм внутри для 4 А) это мало. Сделано: верхние полосы обеих зон опущены с y 56,5 до 59,0 (0,57 мм до ряда выводов U2/U5; D2.2/C46.2 и C48.1/D10.1 попали в полосу — им дано сплошное подключение); колонны расширены на 0,9 мм в сторону соседних полигонов (зазор +45V/−45V 0,6 мм); стебель +45V от моста расширен до x 134–163 на y 98–118; в PGND убраны вырезы между рядами батареи и у CN20.3 (сплошные блоки x 116–181 / y 107,5–134 и x 132–165 / y 142–157). Стало: −45V→U2 полоса 3,55 мм, колонна 2,6 (Q19) и 2,1 (Q14) мм; +45V→U5 4,05 / 3,9 мм; мост→батарея 12,5 мм; PGND ≥24,6 мм; U3/U4 без изменений 4,95 мм.
* **Осталось (без перестановки элементов не исправить):** колонна −45V к U2 (x 104–112,4) пересечена рядами Q19 (y 72) и Q14/R27–R29 (y 90–92) насквозь — 2,1–2,6 мм × 35 мкм ≈ 2 А при +10 °C, 3,3 А при +30 °C (IPC-2221). Для музыки и 8 Ом достаточно; длительная синусоида на 4 Ом (≈3,5 А RMS на плечо) — нагрев порядка +35 °C. Обходной дорожки 2 мм на F.Cu/B.Cu с зазором 0,5 мм нет (поиск коридора: максимум 1,8 мм с обходом 125 мм). Варианты: сдвинуть Q14/Q19 (и R29) из колонны либо принять. R120 при желании повернуть выводом 2 на запад — полоса вырастет с 3,55 до ~5,9 мм.
* **Сплошное подключение к полигонам** (было тепловое): выводы PGND развязки выходных каскадов C11.1, C65.2, C64.1, C45.2 и попавшие в полосу D2.2, C46.2, C48.1, D10.1 (у C48.1 иначе DRC даёт «неполный термобарьер»).
* **Ширины дорожек доведены до классовых** там, где зазор ≥0,3 мм (≥0,5 мм до ±45V и обмоток) позволяет: 143 отрезка — digital 0,3→0,8 (4) и 0,6→0,7–0,8 (31), +5V 0,6→0,8 (21), GND (8), сигналы PIC 0,4/0,5→0,5–0,8 (38), вход CN11 0,5→0,8 (6), база Q20 0,6→0,8 (21), CN21.3→D16 0,8→1,0 (3), отводы ±45V к C11/C46/C48/D10 1,2–1,5→2,0 (11). Не трогались ответвления выходных цепей (R101, отводы цобеля/защиты, TP) и снаббер C32 — ток там мал. 49 отрезков остались уже — не проходят по зазору.
* **Проверено без замечаний:** ERC 0/0; DRC с перезаливкой зон и проверкой соответствия схеме — 0 ошибок, 0 неразведённых, только прежние 148 исключённых пересечений courtyard (`doc/DRC_after_routing_review_2026-09-28.rpt`); лучи GND к NT1.2 и возвраты АС — как в README; ни одна сигнальная цепь не идёт параллельно ±45V; LOCLIP у выпрямителя ≥0,5 мм от обмотки.
* **Корпуса по контурам Fab** (в комментариях исключений часть пар названа «TO-92 без контура на Fab», но контур у TO-92_Inline_Wide есть): Q21/C27 перекрываются на 0,5 мм, R109/Q19 0,27, C46/C13 0,10, R49/R50 0,09, R117/Q22 0,06; пары TO-92 Q7/Q8, Q9/Q10, Q26/Q27, Q28/Q29 — 0,74 мм, Q3/Q4, Q5/Q6 — 0,23 (шаг 3,5 мм: ставить с наклоном, как на заводе). Известные R44/R45 0,36, C22/R42 0,37, C21/C22 0,24.
* Файл платы сохранён KiCad 10 (kicad-cli с перезаливкой зон), концы строк CRLF как были. Элементы не сдвигались, цепи и площадки не менялись.

## 2026-09-28, 16:50 — DRC чистый (KiCad 10)

* Надписи R117/R118 перенесены внутрь корпусов; контур C26 подрезан у площадки C28.
* «Обновить плату по схеме»: синхронизированы поля (Datasheet и др.; 199 расхождений платы и схемы → 0).
  Побочно: у J4, NT1–NT3, TP1–TP6 снят атрибут «исключить из файлов размещения» (так в схеме) — для ручной
  сборки не важно.
* 18 пересечений courtyard новых/сдвинутых элементов оформлены исключениями с комментариями (всего 148).
* **DRC: 0 ошибок, 0 предупреждений, 0 неразведённых, 0 расхождений со схемой** — `doc/DRC_final.rpt`.
* **Сборка: R44 (и R50) — проволочный AC03 Ø4,8 мм ставить с зазором 3 мм над платой** (иначе касается R45);
  родной проволочный со старой платы встаёт без зазора.

## 2026-09-28, 16:30 — по DRC/ERC после переразводки

DRC (KiCad): 0 неразведённых, 0 нарушений зазоров. Исправлено:
* **Шелкография** C18, C39, C24, C28, C79, C80, C81, C13, C47 обрезана по соседним контурам и площадкам;
  обозначения C18/C39/C24/C13/C47 перенесены внутрь корпуса. У C13/C47 контур на шелкографии не помещается
  (вплотную к C46/C48) — остался только на слое Fab.
* **Проверка «посадочное место/символ отличается от библиотеки»** (DRC lib_footprint_mismatch, ERC
  lib_symbol_mismatch) переведена в «игнорировать» в настройках проекта: локальные правки (обрезанная
  шелкография, 3D-модели разъёмов из `640A.3dshapes`, NT2/NT3 с площадками 2,0 мм, свои символы транзисторов)
  — намеренные; при другой версии библиотек KiCad эти предупреждения всплывают массово.
* **Пересечения courtyard** (18 шт.) оформить исключениями в окне DRC: C18 с R35/CN2/R39/R42/C49, C24 с R43/R45,
  C28 с R50, C39 с CN11, C80 с CN20, C81 с U8/U9, C13 с C46, C47 с C48 — корпуса не касаются (проверено по
  размерам корпусов, 0,05–0,3 мм); Q3/Q4, Q5/Q6, R47/R46, R47/R48 — плотная заводская расстановка, были в
  исключениях, но маркеры сместились.

## 2026-09-28, 14:40 — переразводка сигнальных цепей и правки по отчёту проверки (REVIEW_REPORT_2026-09-28)

Копия до правок — `_archive_2026-09-27/before_parts_0928/` (состояние утра) и `_archive_2026-09-28/before_reroute/`.

* **Все сигнальные цепи разведены заново** (107 цепей, класс Default): старая медь, перенесённая из PDF
  оригинала (короткие отрезки, «пузыри», произвольные углы, обходы по краю), заменена дорожками 0/45/90°
  шириной 0,8 мм (в тесных местах 0,5–0,6) по B.Cu, F.Cu — для пересечений; 6 переходных отверстий
  (0,6/0,3: CN5-Pin_1 ×3, Q19-C, Q22-C, Q32-C). Зазор ≥0,2 мм, **до ±45V, концов обмотки CN20 и выходов
  RO/LO/RE/LE — ≥0,5 мм** (п. 4 отчёта: LOCLIP и BIAS_HI_R больше не подходят к ним ближе 0,5 мм).
* **Не трогались** (топология и ширины как были): ±45V, PGND, GND (включая перемычки-замены WIRE LINK на
  F.Cu — это пути земли оригинала), AUX0V, digital, ±15V, +5V, выходы и эмиттерные цепи, обмотки,
  цепи на внутренних слоях (PIC …), цобели и снабберы, Net-(D1-A), Net-(Q3-C), Net-(Q20-B).
* **Радиатор U8–U10 (п. 2):** H8 → `digital` (дорожка 0,8 мм к цепи digital у U8), H7 без цепи — одна точка
  заземления. Изоляторы U9/U10 оставить.
* **NT2/NT3 (п. 8):** площадки 1,3 → 2,0 мм при сверле 1,0.
* **Силовые площадки на полигонах (п. 6):** `zone_connect` solid у 28 площадок ±45V/PGND — батарея
  C21/C23/C25/C26/C29/C30/C62/C63, мост D17–D20, SAP15 U2–U5, CN20, CN23, CN24, NT1.
* **C13/C47 (п. 5):** посадочное место плёночного конденсатора заменено на
  `640A:C_Radial_D5.0mm_P5.00mm_NP` (NP-электролит 10 µF 16 V Ø5 × 11, выводы отформовать в шаг 5 мм).
* **Поле Datasheet (п. 11):** пустые значения в схеме заменены на «~», как на плате.
* **После открытия в KiCad: залить полигоны (B) и прогнать DRC.** Заливка в файле старая; курсовые зоны
  C80/CN20 и C81/U8/U9 пересекаются (корпуса не касаются) — оформить исключениями.
* Не делалось (решение автора / BOM): п. 3 — измерить Net-(D14-K) на холостом ходу при +10 % сети, если
  > 32 В — брать TSRN 1-2450 или вернуть 7805; п. 7 — нейлоновые шайбы под H2/H7/H8/H9; п. 9 — заказывать
  явно 2 oz снаружи / 1 oz внутри; п. 10, 12 — шелкография и имена листов; п. 13 — C66/C7/C43/C33 брать на 63 В.

## 2026-09-28, 13:30 — по внешней проверке: мост и цобель

* **D17–D20: SB5200 → Diotec BY550-400** (кремниевый 5 А 400 В, Iпик 220 А, Ø5,4 × 7,5 мм, «ЧИП и ДИП»
  8026566344). У SB5200 допустимый импульсный ток 125 А — меньше, чем у оригинального 1N5402 (200 А), то есть
  исходная причина замены не выполнялась; утечка Шоттки растёт с температурой. Посадочное место прежнее
  (DO-201AD, шаг 13,97, отверстие 1,6 мм).
* **R44/R50: 4R7 2 W металлоплёнка → 4R7 3 W проволочный Vishay AC03** (Ø4,8 × 13 мм, «ЧИП и ДИП» 8017149996),
  как в оригинале; допустимо поставить снятые родные. Посадочное место прежнее.
* SB5200 и HKR MF200 из первого заказа — в запас.

## 2026-09-28, 12:30 — купленные детали в схеме и на плате

Детали заказаны в «ЧИП и ДИП». У всех изменённых и новых элементов в схеме и на плате появились поля
`Manufacturer`, `MPN`, `Supplier` («ЧИП и ДИП»), `Supplier PN` (номенклатурный номер магазина), см. README.
Копия файлов до правки — `_archive_2026-09-27/before_parts_0928/`.

* **Значения:** C17/C41 → `220u NP 10V (D8)` (Panasonic ECE-A1AN221U; 16 В в Ø8 не нашлось, на конденсаторе
  < 1 В); R44/R50 → `4R7 2W metal film` (HKR MF2004R7JTB07573); C24/C28/C79/C80 → `100n 250V MKT`;
  C81 → `10u 50V X7S`; R120/R121 → `100R 1%`; R122/R123 → `47R 0.5W MO`. Описания (Description) обновлены.
* **C24, C28, C79, C80 — TDK B32560J3104K000, у него шаг выводов 7,5 мм** (а не 5): посадочное место
  `C_Rect_L9.0mm_W3.2mm_P7.50mm_MKT`. C24 и C28 — отверстия раздвинуты симметрично от прежнего центра
  (C24: 87,86 / 95,36; C28: 89,26 / 96,76), до банок C25/C26 остаётся 0,9–1,5 мм. C79 и C80 сдвинуты:
  C79 — выводы (154,0; 158,5) и (154,0; 151,0); C80 — (141,8; 156,3) и (141,8; 148,8). Подводящие дорожки
  продлены (0/45/90°): C24 B.Cu, C28 B.Cu и In1, C79 F.Cu, C80 B.Cu. Выводы PGND у C79/C80 — в полигоне In2.
* **C81 — Murata RDE 5,5 × 4,0 мм:** новое посадочное место `640A:C_Rect_L5.5mm_W4.0mm_P5.00mm_Murata_RDE`
  (добавлено в `640A.pretty`), отверстия на прежних местах. Корпус встаёт между U9 и U8 с зазором ≈0,1 мм
  с каждой стороны; courtyard пересекается с U8/U9 — ожидаемо.
* **C18/C39 — WIMA MKS2 2,2 µF 100 V (11 × 16 × 7,2 мм)**, посадочное место
  `C_Rect_L7.2mm_W11.0mm_P5.00mm_FKS2_FKP2_MKS2_MKP2`.
  * C18 остался на своём месте, повёрнут на 90°: выводы (102,75; 119,55) и (102,75; 124,55); корпус между
    C49 и CN2 и между площадками R35 и R39 (по 0,05 мм). Для этого **C49 сдвинут на 0,3 мм вверх** — единственный
    сдвинутый существующий элемент. Дорожки: CN2-Pin_1 — новая диагональ B.Cu в обход нижнего вывода;
    C18-Pad2 — от R35 по F.Cu; signal1 (x 105,2) — диагональ опущена на 0,6 мм.
  * C39 — на 9 мм ниже прежнего места, в свободном месте под C76 и левее C40: выводы (236,7; 132,8) и
    (231,7; 132,8). Дорожки по F.Cu: C39-Pad2 от C76.2 вниз, CN11-Pin_1 от CN11.1 между Q20-B и C40 (0,5 мм).
    Старые отрезки к прежним выводам C39 удалены.
  * Высота корпуса 16 мм — проверить, что над C18/C39 ничего нет (кабели, плата входов).
* H7 → `AUX0V` — отменено в 14:40, см. ниже (радиатор заземлён на `digital` через H8).
* **После открытия платы в KiCad нужно залить полигоны (B) и запустить DRC** — заливка в файле старая.

## 2026-09-28, день — C81, 1N4004, выравнивание ширин после ручной доводки

За основу взята плата после ручной доводки автора (08:07). Её копия и копии схем — в
`_archive_2026-09-27/before_widths_c81/`.

* **C81 10 мкФ 50 В X7R** (керамика, дисковый корпус D ≤ 4,7 мм, толщина ≤ 4 мм, шаг 5 мм) — развязка
  стабилизатора U8 прямо у выводов 1–2 (Net-(D14-K) / digital). Добавлен в схему (Power Supply) и на плату
  слева от U8; дорожки 0,8 мм.
* **D13–D16, D31 → 1N4004** (значения в схеме и на плате).
* **R44/R50** — в описание добавлено требование к корпусу (безындукционный металлоплёночный 2–3 Вт,
  D ≤ 4,5 мм, L ≤ 16 мм при шаге 18,42 мм, либо монтаж с зазором 2–3 мм над платой).
* **Ширины дорожек.** Внутри одной ветки (от площадки/узла до площадки/узла) ширина теперь постоянная —
  ступеньки 0 (было больше 60). 115 веток, более узких, чем требует класс цепи, расширены до ширины класса
  там, где позволяет зазор 0,2 мм (98 целиком, 17 частично). Короткие отрезки < 0,1 мм и дробления в местах
  стыка убраны, коллинеарные отрезки слиты.
* **Исправлены стыки:** D23-A (Y-стык → T), Q3-C (ступенька → 45°), RO у R109/C15 (единая ветка 2,0 мм
  с отводом 1,5 мм), дублирующий огрызок digital у (99,0; 154,5).
* **C52 вывод 2 (digital) не был подключён** — оставался огрызок 0,3 мм. Соединён с R89.2 (B.Cu 0,8 мм).
* **U2 вывод 3 (−45V), In1.Cu:** площадка стояла на краю полигона −45V, к ней шла одна перемычка
  термобарьера из двух. Вырез полигона опущен с Y = 61,0 до 63,2 мм.
* ERC 0/0; DRC 0 нарушений, 0 неразведённых, 0 расхождений со схемой; 219 исключений прежние
  (`doc/ERC_final.rpt`, `doc/DRC_final.rpt`).

## 2026-09-28 — чистка разводки B.Cu, классы цепей

* **Медь слоя B.Cu пересобрана.** Это медь оригинала, переведённая из векторного PDF: 2207 штрихов,
  из них 460 короче 0,3 мм, 553 под произвольными углами, ~20 разных «дюймовых» ширин (0,336 / 0,448 /
  0,672 / 1,12 мм …), «пузыри» из наложенных штрихов у площадок, хвосты за площадками, мелкие петли.
  Для каждой цепи построен граф «какие площадки чем соединены» (соединением считается перекрытие меди),
  каждая ветка заменена одной ломаной под 0/45/90° по трассе оригинала; хвосты, петли и дубли убраны;
  ширина ветки — ближайшая большая из стандартного ряда (0,448→0,5; 0,672→0,8; 1,12→1,2 мм и т. п.).
  Где новая линия не проходила по зазору (одна ветка у R1, +5V), оставлены штрихи оригинала.
  Итог: 1807 сегментов вместо 2207; связность всех цепей совпадает с исходной (проверено по всем площадкам),
  зазоры ≥ 0,2 мм. Слои F.Cu, In1.Cu, In2.Cu не менялись. Копия платы до чистки —
  `_archive_2026-09-27/before_trace_cleanup/`.
* **Классы цепей и стандартный ряд ширин** (Power / Output / Transformer / AuxWinding / Supply / Default) —
  для ручной доводки, см. README.
* DRC: 0 ошибок, 0 предупреждений, 0 неразведённых, 0 расхождений со схемой; 219 исключений прежние.

## Релиз 2026-09-27

* Проект переведён на KiCad 9.0.4 (формат файлов KiCad 9).
* ERC и DRC доведены до нуля (подробности ниже, по этапам).
* Выгружен актуальный PDF схемы (`doc/640A_PowerAmp.pdf`); прежний экспорт и отчёт ERC KiCad 10 — в архиве.
* Рабочие файлы (промежуточные отчёты, резервные копии, тестовые проекты) перенесены в `_archive_2026-09-27/`.
* README разделён: описание проекта (`README.md`), хронология (`CHANGELOG.md`), задание на проверку (`REVIEW_BRIEF.md`).

### Исправления 2026-09-27 (после проверки в KiCad 9)

* **Плата открывалась без дорожек.** Ошибка генератора: при добавлении C16 его посадочное место дописывалось после закрывающей скобки файла, а дорожки и полигоны попадали внутрь этого посадочного места. KiCad читает файл до первой закрывающей скобки корня, поэтому дорожек, полигонов и самого C16 не видел. Исправлено: в файле один корень, внутри 296 посадочных мест, 2515 отрезков дорожек, 9 полигонов. Генератор (`step0`) тоже исправлен.
* **Схема в KiCad 9 рассыпалась на куски.** Провода касались середины других проводов (Т-узлы и пересечения). KiCad 9 соединяет провода только концами, поэтому 89 цепей распадались, а 205 выводов считались неподключёнными. Теперь провода разрезаны в каждом узле и в точках глобальных меток +15V/−15V. Список соединений схемы, построенный по правилу «только концы», совпадает с платой по всем 646 площадкам.

### Исправления 2026-09-27, вечер (проверка в KiCad 9.0.4)

* **Схема рассыпалась при каждом открытии.** Причина была в файле проекта, а не в схемах: у класса цепей `Default` в `640A_PowerAmp.kicad_pro` не были заданы толщина провода (`wire_width`) и шины (`bus_width`). С пустыми значениями KiCad 9 не распознаёт узлы проводов: при открытии проекта он удаляет все точки соединения (junction) как «лишние», склеивает разрезанные провода обратно и не ставит точки при рисовании новых Т-соединений. Отсюда 205 «неподключённых» выводов и 238 висящих концов проводов в ERC, хотя геометрически всё сходилось. Добавлены стандартные значения KiCad (провод 6 mil, шина 12 mil). Если в «Настройках схемы → Классы цепей» эти поля снова окажутся пустыми, проблема вернётся.
* **Обозначения с `**` KiCad считал неаннотированными.** KiCad принимает обозначение за аннотированное, только если оно заканчивается цифрой, поэтому `C17**`, `R50**`, `U8**` и остальные (29 шт.) блокировали проверку соответствия схемы и платы и «Обновить плату из схемы» (на плате они шли как 199 «лишних посадочных мест»). Звёздочки перенесены из обозначения в отдельное видимое поле `Mod` рядом с ним — на листе по-прежнему видно `C17**`. На плате обозначения и автоматические имена цепей (`Net-(C28-Pad1)` вместо `Net-(C28**-Pad1)`) переименованы так же.
* **Узел net-tie NT1–NT3 (Power Supply) стоял вне сетки** на 0,28 мм (NT1 на X = 300,0 мм). Весь узел вместе с проводами и символами земли сдвинут на сетку 1,27 мм; соединения не изменились.
* Оригиналы файлов до этих правок — в `_archive_2026-09-27/zz_junction_test/backup_before_fix/`.

### Исправления платы 2026-09-27, поздний вечер (DRC в KiCad 9.0.4)

После обновления платы из схемы DRC давал 155 ошибок и 8 неразведённых соединений. Исправлено:

* **8 разрывов** — дорожки кончались в 0,1–2,5 мм от площадки или соседней дорожки своей цепи
  (+45V у C25, LICLIP у R83, R50–C28, C18–CN2, R78–C76, CN11 вывод 1, D31/CN5, CN21 вывод 3); добавлены
  короткие перемычки той же ширины. Неразведённых соединений — 0.
* **3 нарушения зазора** (0,115–0,15 мм при норме 0,2 мм) — перепроложены: +15V на In1.Cu у D29,
  +5V на B.Cu у D31, база Q21 на B.Cu у D6. Новый минимальный зазор ≥ 0,7 мм.
* **Пересекающиеся зоны одной цепи** (+45V на In1.Cu, PGND на In2.Cu) — одной зоне в каждой паре дан
  приоритет 1; заодно ушла ошибка неполного термобарьера у C26.
* Слиты сонаправленные отрезки дорожек (2529 → 2473) и удалены 12 изолированных обрывков/висящих отрезков.
  Автоматическое «удаление дорожек, не подключённых с одного конца» KiCad **не применять**: он удаляет и
  отрезки, к середине которых примыкают другие дорожки, и рвёт 2 соединения.

Итог DRC на тот момент: 0 неразведённых, соответствие схеме — 0 расхождений, ошибок — только
140 пересечений courtyard. Они унаследованы от оригинальной расстановки (плотная плата, отверстия совпадают
с оригиналом), поэтому элементы не сдвигались. Предупреждения: шелкография (397), 25 мелких висящих
обрывков, перекрытых соседними дорожками той же цепи, 5 посадочных мест отличаются от библиотеки.
ERC: 0 ошибок, 36 предупреждений «символ отличается от библиотеки» — символы не обновлялись, так как
у MPSA42/92, BC327/337 в проекте своя цоколёвка.

### Чистка ERC/DRC до нуля, 2026-09-27, ночь

Итог: **ERC — 0 ошибок, 0 предупреждений** (`doc/ERC_final.rpt`); **DRC — 0 ошибок, 0 предупреждений,
0 неразведённых, 0 расхождений со схемой** (`doc/DRC_final.rpt`), 219 нарушений оформлены исключениями с
комментарием (видны в DRC при включённом флажке «Исключения»).

* **Символы.** `Q_NPN_ECB/EBC`, `Q_PNP_ECB` перепривязаны из `Device` в `Transistor_BJT` (в KiCad 9 они
  там). Все символы обновлены из библиотек KiCad 9 без изменения полей (Footprint, Mod и др. не тронуты,
  проверено по всем 349 экземплярам). Отличия были только косметические: длина вывода базы 2,54 вместо
  5,08 мм, тип вывода passive→input, текст описания AUX0V. Номера выводов (цоколёвка) у всех совпадали.
* **Посадочные места.** NT1–NT3, H7, H8 обновлены из библиотек (отличались
  вспомогательные контуры и свойства; площадки, отверстия, положение и цепи не менялись).
* **Висящие обрывки дорожек** удалены скриптом в консоли KiCad с проверкой связности после каждого
  удаления (скрипт — в `_archive_2026-09-27/zz_claude_backup/`); узел J4–C31–R97 (цепь `Net-(C31-Pad2)`) из шести
  наложенных огрызков заменён тремя чистыми дорожками.
* **Шелкография.** Контуры корпусов обрезаны там, где они заходили на площадки (с зазором 0,1 мм) или
  на контур соседнего корпуса — 79 посадочных мест. Метки катода «K» у 18 диодов перенесены на свободное
  место рядом с выводом 1.
* **Исключения DRC** (`640A_PowerAmp.kicad_pro`, у каждого свой комментарий):
  * 79 × «посадочное место отличается от библиотеки» — это обрезанная шелкография. Геометрия меди та же.
    **Если выполнить «Обновить посадочные места из библиотеки», обрезка пропадёт.**
  * 140 × пересечение courtyard: 106 — корпуса не касаются (пересекаются только запасы 0,25 мм);
    4 — корпуса соприкасаются (≤0,07 мм); 27 — TO-92/контрольные точки/крепёж без контура на Fab
    (пары Q7/Q8, Q9/Q10, Q26/Q27, Q28/Q29 и т. п., шаг 3,5 мм как на заводской плате);
    **3 требуют внимания при сборке:**
    * **R44/R45** — корпуса перекрываются на 0,36 мм (модель DIN0516 Ø5 мм); см. «Проверки» в README.
    * **C21/C22** (0,29 мм) и **C22/R42** (0,32 мм) — расстановка заводская, перекрытие даёт типовой
      корпус KiCad для C22 (CP Ø6,3). Реальный C22 47 µF 50 V бывает Ø5 — с ним помещается.
* Копии файлов до этого этапа — `_archive_2026-09-27/zz_claude_backup/before_step2/`.

## До 2026-09-27

Первая версия схемы (2026-09-25 и ранее): перенос схемы из мануала, удаление перемычек LK, замыкание
WIRE LINK, разделение земель и звезда на net-tie, доработки (**), разъёмы CN20–CN24, плата по оригиналу
AP12708/6a, 4-слойная разводка (версия звезды земли 6). Подробности — в README.

## 2026-11-07: R12 и принятые пересечения шелкографии

- R12: только Reference смещён вниз на 0,8 мм от C7.
- R121/U4, R112/R50, R65/C78, R25/Q18: четыре конкретных исключения DRC по решению пользователя.
- Повторный DRC с перезаливкой и сравнением со схемой: 0 активных нарушений; существующие исключения и отключённые правила сохранены.
- Gerber, сверловка, архивы и отчёты обновлены. Медь, расстановка, QR и U6 не менялись.
