SSSound13/Cambridge_640A_PowerAmp/TODO.md

# План доработок платы v3

Зафиксировано 05.11.2026 по замечаниям пользователя в чате «Заметки по версии 2»
(01–04.11.2026) и подтверждено пользователем при переносе проекта.

Это план доработок **после уже изготовленной v2 THT**, собранный по опыту её монтажа.
Пункты ниже ещё не реализованы в схеме, плате или производственных файлах.
Текущая изготовленная версия сохраняет номер **v2**; следующая ревизия — **v3**.
Изготовленная v2 соответствует Gerber от 03.10.2026; правка NT1 от 14.10 есть только
в исходниках. Статус этой правки описан в README и CHANGELOG.

## Плата и удобство сборки

- [ ] **Вернуть штатный U8 (7805) вместо TRACO TSR 1-2450 и сохранить целый
  оригинальный радиатор без распиливания** (решение по результатам сборки v2 для реализации в v3, 06.11.2026).
  U9 (7815) и U10 (7915) оставить штатными с изоляцией от радиатора.
  Добавленный C81 не устанавливать; штатные конденсаторы питания и развязки
  сохранить. В следующей ревизии убрать C81 и его открытые площадки из зоны
  радиатора. На уже изготовленной плате изолировать открытые площадки C81
  от радиатора, особенно площадку входного плюса U8.
  **Убрать отдельное соединение H8 с digital**; H8 оставить механическим
  креплением без цепи. Связь радиатора с digital обеспечить через металлический
  фланец штатного 7805, как в оригинале. Перед выпуском проверить корпус U8,
  контакт фланца, изоляцию U9/U10, крепления и отсутствие нежелательных связей.
  Это итоговое решение заменяет предложение сохранить отдельную землю H8.
  При реализации обновить схему, плату, BOM и инструкцию. Пока это только план:
  исходники схемы и платы, а также Gerber этим пунктом не изменяются.

- [ ] **TP1–TP6 сделать крупнее и подписать по назначению** (01.11).
  Предусмотреть удобные площадки и отверстия под штырь/петлю, рядом обозначить канал
  и функцию. Перед подписями обязательно сверить сети TP в KiCad; названия вроде
  «L +E / L OUT / L −E» пока только пример.
- [ ] **Все резисторы разместить лежачими**, с единым шагом выводов внутри каждой
  мощности (01.11). Для 0,125 Вт согласовать шаг с малыми диодами и стабилитронами
  DO-35, предварительно проверив реальные корпуса. Найти место для лежачих
  R120/R121 и R122/R123, при необходимости передвинуть соседей.
- [ ] **Унифицировать шаг R101/R119 с остальными 0,125 Вт** (16.10, уточнено 01.11).
  Сейчас у них 5,08 мм, у большинства — 7,62 мм. Изучить перенос соответствующих
  RC-цепочек ближе к выходу и переразводку участка: простое растягивание посадочного
  места мешает SAP15 и подстроечникам. Перед переносом сверить пары R/C по схеме:
  в исторических заметках встречаются несовпадающие сочетания C12/C14.
- [ ] **Добавить QR-код проекта на шелкографию** (01.11).
  Ссылка: https://github.com/SSSound13/Cambridge_640A_PowerAmp . Рядом предусмотреть
  читаемый текст; место выбрать вне радиатора и кронштейна. Размер определить
  по возможностям печати и проверить считывание на изготовленной плате.
- [ ] **Выровнять компоненты по горизонтальным и вертикальным линиям** (01.11),
  согласовать ряды и симметричные узлы каналов; выполнять вместе с изменением шага.
- [ ] **Убрать знак коллектора «К» у транзисторов** (01.11).
  Это не отменяет обозначение катода у диодов.
- [ ] **Однозначно обозначить сторону установки TO-126** (04.11): штрихованная
  полоса со стороны металлической подложки, как на оригинале. Согласовать обозначение
  для TO-126 и SAP15/TO-3P, сверить распиновку с даташитами и платой. Это отдельная
  задача от удаления знака «К».
- [ ] **Нанести контур радиатора и кронштейна** (04.11), включая зону выходного
  каскада U2–U5, Q20 и крепления H1–H6. Размеры снять с реального узла;
  контур не должен пересекать площадки и подписи.
- [ ] **Переделать J4 (CHASSIS) под двухлапковый Faston 6,3 мм** (04.11).
  Выбрать конкретный лепесток (TE 62409-1 обсуждался как пример), взять шаг и
  сверловку из его чертежа. Обе ножки подключить к сети J4, сохранив штатную связь
  с PGND через R97 ∥ C31. У изготовленной v2 одно отверстие: по принятому решению
  провод в него впаивается в самом конце сборки.
- [ ] **Исключить наложения площадок и шелкографии, обеспечить монтаж без
  подгибки штатных выводов** (02.11). Посадочные места выбирать по фактическим
  деталям; учитывать зазоры, медь и маску. Итог проверить DRC и в 3D, отдельно
  пересмотреть прежние исключения courtyard и шелкографии.

## Документация

- [ ] Подготовить два варианта комплектации/переноса деталей (01.11):
  1. Максимальный перенос с существующей платы; электролиты в этом варианте
     всё равно отмечать к замене.
  2. «Перенос только новых деталей» — формулировка пользователя. Её точное
     значение ещё требуется уточнить; трактовка «купить всё новым, кроме SAP15
     и недоступных деталей» в чате предлагалась, но не была подтверждена.
  Сверить документ с актуальным BOM и закупками. Личный план сборки v2 с переносом
  недавно заменённых электролитов не подменяет эти два сценария документации.

## Отложено по решению пользователя

Универсальное посадочное место **SAP15/STD03**, включая овальные отверстия,
обсуждалось 01.11 и затем было снято с задач словами «Убираем пока эту задачу».
Не включать его в следующий релиз без нового решения пользователя. SAP15N/P сохраняются.

## Перед реализацией и выпуском

Сверить исходники, реальные комплектующие и изготовленную плату; разобраться
с противоречащими историческими советами о подключении корпуса к NT1 и J4.
После реализации плана выполнить ERC/DRC с пересмотром исключений, проверить
механику и подписи, затем заново сформировать и проверить Gerber/Excellon.
Закрывать пункты только по фактически выполненным изменениям.
