SSSound13/Cambridge_640A_PowerAmp/doc/v2/MINIMAL_FIXES.md

# Cambridge 640A v2: минимальные исправления

**Версия 2 находится в состоянии проверки. Информация будет обновлена после проверки. Исправленные исходники от 07.11.2026 не являются производственным релизом.** Открыть `640A_PowerAmp.kicad_pro` в корне репозитория. Исходная база изготовленной платы: `8b50969ccdb2c14b596d69ecaa82c7d5dde71d09`. Это не симметричная компоновка v3. Исправленные исходники опубликованы в основной ветке; архив изготовленной v2 и её Gerber сохранены без изменений. Ветка v3 ведётся отдельно.

## Что изменено

1. **U6:** устранено ошибочное объединение входа 2 с +15V в схеме и PCB. Сигнальная сеть U6.2–C34.1–R60.1–R63.2 отделена от питания. Удалён единственный ошибочный F.Cu отрезок C34.1–C36.1. Остальная геометрия этой цепи сохранена; выводы U6 не переставлялись.
2. **U8:** вместо TRACO восстановлен 7805 с обычным библиотечным `Package_TO_SOT_THT:TO-220-3_Vertical`. Центры выводов и ориентация сохранены; площадки стали 1,905 × 2,0 мм, сверло Ø1,1 мм вместо Ø1,0 мм. U9/U10 уже имели этот стандартный footprint и не требуют изменения монтажа. Посадка использованного TO-220 в отверстия изготовленной v2 проверена при сборке; это не рекомендация рассверливать готовую плату.
3. **C81 и H8:** C81 удалён вместе с четырьмя конечными ветвями. Удалена только отдельная дорожка H8 к digital; площадка H8 оставлена без назначенной сети. Это не изолирует общий радиатор от digital: связь остаётся через неизолированный фланец U8.
4. **Шелкография:** единый шрифт KiCad, высота 1,0 мм и штрих 0,20 мм. Позиционные подписи переразмещены без движения деталей. Буквы K у диодов удалены, полосы катода сохранены. Добавлен контур общего радиатора по сервис-мануалу и функциональные обозначения контрольных точек.
5. **Ссылка на проект:** QR на F.SilkS под H2, над R71, для чтения сверху. На обратной стороне сохранены обычная полная текстовая ссылка `https://github.com/SSSound13/Cambridge_640A_PowerAmp`, название платы, отметка `v2 fix draft` и дата. Текст того же единого размера и толщины. QR рассчитан на белую шелкографию и тёмную маску.
6. **Документация:** BOM изготовленной v2 обновлён только для U8 и удаления C81; шаги остальных деталей не заменены вариантами v3. Удалены четыре больше не действующих courtyard-исключения проекта; новые исключения не добавлялись.

## Что не перемещалось

Все 296 оставшихся компонентов сохранили координаты, углы и UUID. C56, R92, R93 остаются на прежних местах. Контур платы, механические отверстия, 21 via и остальная разводка не менялись. NT1.1 остаётся Ø1,0 мм. Изменение размеров трёх площадок U8 относится только к новым исходникам.

## Проверки

**Итог:** ERC 0, DRC 0 неисключённых нарушений, неразведённых соединений 0, расхождений со схемой 0. Связность всех 2049 медных объектов совпадает с проверенным электрическим вариантом. Контрольная перезаливка зон в отдельной копии не изменила соединений; исходные заполнения в выдаваемой копии сохранены.

Итоговые результаты находятся в `validation/`, просмотр платы в `preview/`. Проверки выполнены KiCad 10.0.7 с настройками исходного проекта. Сохранены добавленные ранее поясняющие текстовые заметки на схемах каналов о несовпадении L/R и имён сетей; соединения от этих заметок не меняются.

В проекте сохранены 142 прежних исключения пересечений courtyard. Отсутствие новых DRC не означает, что плотные реальные корпуса и нагрев проверены. Часть правил исходного проекта выключена; точный список приведён в [описании проверок](VALIDATION.md).

## Шелкография и просмотр

- Все **303 видимых текста** имеют 1,0 × 1,0 мм / 0,20 мм, без уменьшенных исключений: 293 позиционных обозначения, 6 названий сетей TP и 4 строки на обороте. По сравнению с основными старыми подписями 0,8 / 0,15 это +25% по высоте и +33% по штриху. Сравнение 0,8/.15, 1,0/.18 и 1,0/.20: `preview/font-comparison.png`.
- TP1=RE1, TP2=RO, TP3=RE2, TP4=LE1, TP5=LO, TP6=LE2. Это проверенные имена сетей; буквенные префиксы не заменены интерпретацией каналов, так как названия листов проекта расходятся с ними.
- Удалены 26 букв K, сохранены катодные полосы всех 28 осевых диодов. В двух локальных библиотеках диодов K также удалена. У внешних стандартных Diode_THT это правка экземпляров на PCB: Update Footprints from Library может вернуть K. После обновления повторить проверку, не удаляя полос катода.
- Контур радиатора: 80 печатных отрезков F.SilkS, с разрывами около площадок и подписей; полный 162-сегментный контур находится на Dwgs.User. Это монтажный ориентир с указанными ниже ограничениями, а не допусковый чертёж.
- Из 299 лицевых текстов 297 не пересекают модельные корпуса Fab. **R117 может быть закрыт корпусом R65, R39 корпусом C18.** Их шрифт не уменьшен и детали не перемещены; дальние неоднозначные варианты надписей отвергнуты. Полная видимость после реальной сборки не гарантируется и для остальных: неизвестны фактические корпуса, выводы и крепёж.
- Новая маркировка металлической стороны TO-126/SAP15 не добавлялась: для всех позиций не получено однозначного проверенного соответствия поверхности. Существующая ориентация корпусов и площадок сохранена; использовать монтажный вид и datasheet конкретного корпуса.
- QR: **12,3 × 12,3 мм** вместе с полем, модуль 0,30 мм, 33 × 33 модуля, коррекция M. Защитное поле 4 модуля = 1,20 мм с каждой стороны. На **F.SilkS**, X234,50…246,80 / Y72,00…84,30 мм, под H2 и над R71. Прочитан из native-экспорта при 200/300/600/1200 dpi. До ближайшей надписи R71 0,493 мм, до courtyard детали 1,654 мм, до открытия маски 2,131 мм, до правого края платы 2,126 мм. Полный URL снизу и его зазор 0,366 мм сохранены. Нужны контрастные **белая шелкография и тёмная маска**. Физическая печать и обзор в собранном корпусе не проверялись.
- Для условной шайбы H2 Ø6 мм остаётся 0,631 мм до поля QR. Чтобы сохранить запас 0,5 мм, диаметр крепежа в этой проекции должен быть не больше 6,26 мм. Фактические шайбу, кронштейн и прокладку проводов необходимо сверить на усилителе; размеры крепежа не заданы в PCB.

`preview/front-silkscreen.png` показывает шелкографию с отверстиями/маской; чёрные площадки не являются печатным текстом. `preview/front-assembly.png` дополнительно показывает Fab-корпуса; только палитра просмотра сделана контрастнее на белом фоне, геометрия native-экспорта не менялась. Серые буквы K относятся к непечатному Fab, а не к шелкографии. `preview/back-silkscreen.svg` и PNG ориентированы для нормального просмотра снизу; `preview/back-markings.png` показывает сохранённые текстовые строки снизу; `preview/top-qr.png` показывает верхний QR в ожидаемой полярности белой краски на тёмной маске. Для векторного вида лицевой стороны можно экспортировать SVG из исходного PCB в KiCad. В репозитории для быстрого просмотра представлены PNG.

## Изготовленная плата: это отдельная работа

Обновление файлов не исправляет уже изготовленную медь. Перед вмешательством отключить питание и убедиться, что накопительные конденсаторы разряжены. На четырёхслойной плате нельзя углублять надрез или перерезать другие слои. Конкретное место физического разрыва необходимо сверить с реальной платой и прозвонкой.

- После устранения ошибочного моста U6.2 должен сохранять связь с C34.1/R60.1/R63.2, U6.7 с C36.1/U9.3. Между U6.2 и +15V не должно оставаться прямого медного соединения. Перемычка для этого исправления не нужна.
- C81 не устанавливать/снять для целого радиатора. Его старые площадки и остатки припоя не должны касаться металла.
- Отдельную ветвь H8 проверять до установки проводящего радиатора. После сборки прозвонка H8–digital может снова показывать связь через радиатор и U8; это не доказывает, что старая дорожка осталась.

## Радиатор, изоляция и тепло

[Сервис-мануал Cambridge AP14676/1](https://manuals.sterremuur.nl/Amplifier/CambridgeAudio/cambridge_azur-640a_sm.pdf): питание p.17, монтаж p.21, радиатор и изоляция p.25. Радиатор AP12106/1 рассчитан на три TO-220.

- **U8/7805:** без изоляционного комплекта, с термопастой по мануалу. Фланец обычного металлического TO-220 связан с выводом 2/digital.
- **U9/7815 и U10/7915:** изоляционные комплекты, термопаста и электрическая изоляция крепежа. У обычного металлического 7915 фланец связан с отрицательным входом, а не с землёй. Неизолированный U10 может замкнуть входную отрицательную шину на digital через радиатор/U8. Проверить datasheet фактического производителя и исполнение корпуса.
- Контур радиатора выведен из монтажного рисунка, **не из размерного чертежа**. Номинальная оболочка 55,129 × 16,042 мм; допуски и высоты неизвестны. C56 находится в промежутке рёбер с малым расчётным запасом около 0,38 мм. Нужна реальная примерка целого радиатора, выводов и крепежа.
- Реальные Vin, ток +5V, суммарные потери U8/U9/U10, температура среды и тепловое сопротивление неизвестны. Тепловой запас не подтверждён. Оценка 7805: примерно `(Vin − 5) × I5V` плюс собственное потребление, а радиатор принимает также тепло U9/U10. Проверить максимальное напряжение фактического 7805 и номинал C53. Непроверенное предположение о 25 В не используется.
- Сохраняются плотные места оригинальной v2: особенности установки R44/R50, C18 и TO-92 перечислены в BOM. Масштабный чертёж силовой прижимной планки отсутствует; её геометрию не изобретали.

## Земля и корпус

J4 в схеме подключён через R97 47 Ω параллельно C31 100 нФ; NT1 соединяет PGND и GND. Не заменять этот путь прямым проводом к NT1 по историческому противоречивому примечанию. Схема защитного заземления корпуса не изменялась.

Новых Gerber для заказа в комплекте нет. Перед производственным выпуском остаются реальная механическая примерка, безопасные электрические и тепловые испытания и проверка ограничений изготовителя.
