SSSound13/Cambridge_640A_PowerAmp/doc/640A_PowerAmp_v2_assembly.pdf

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

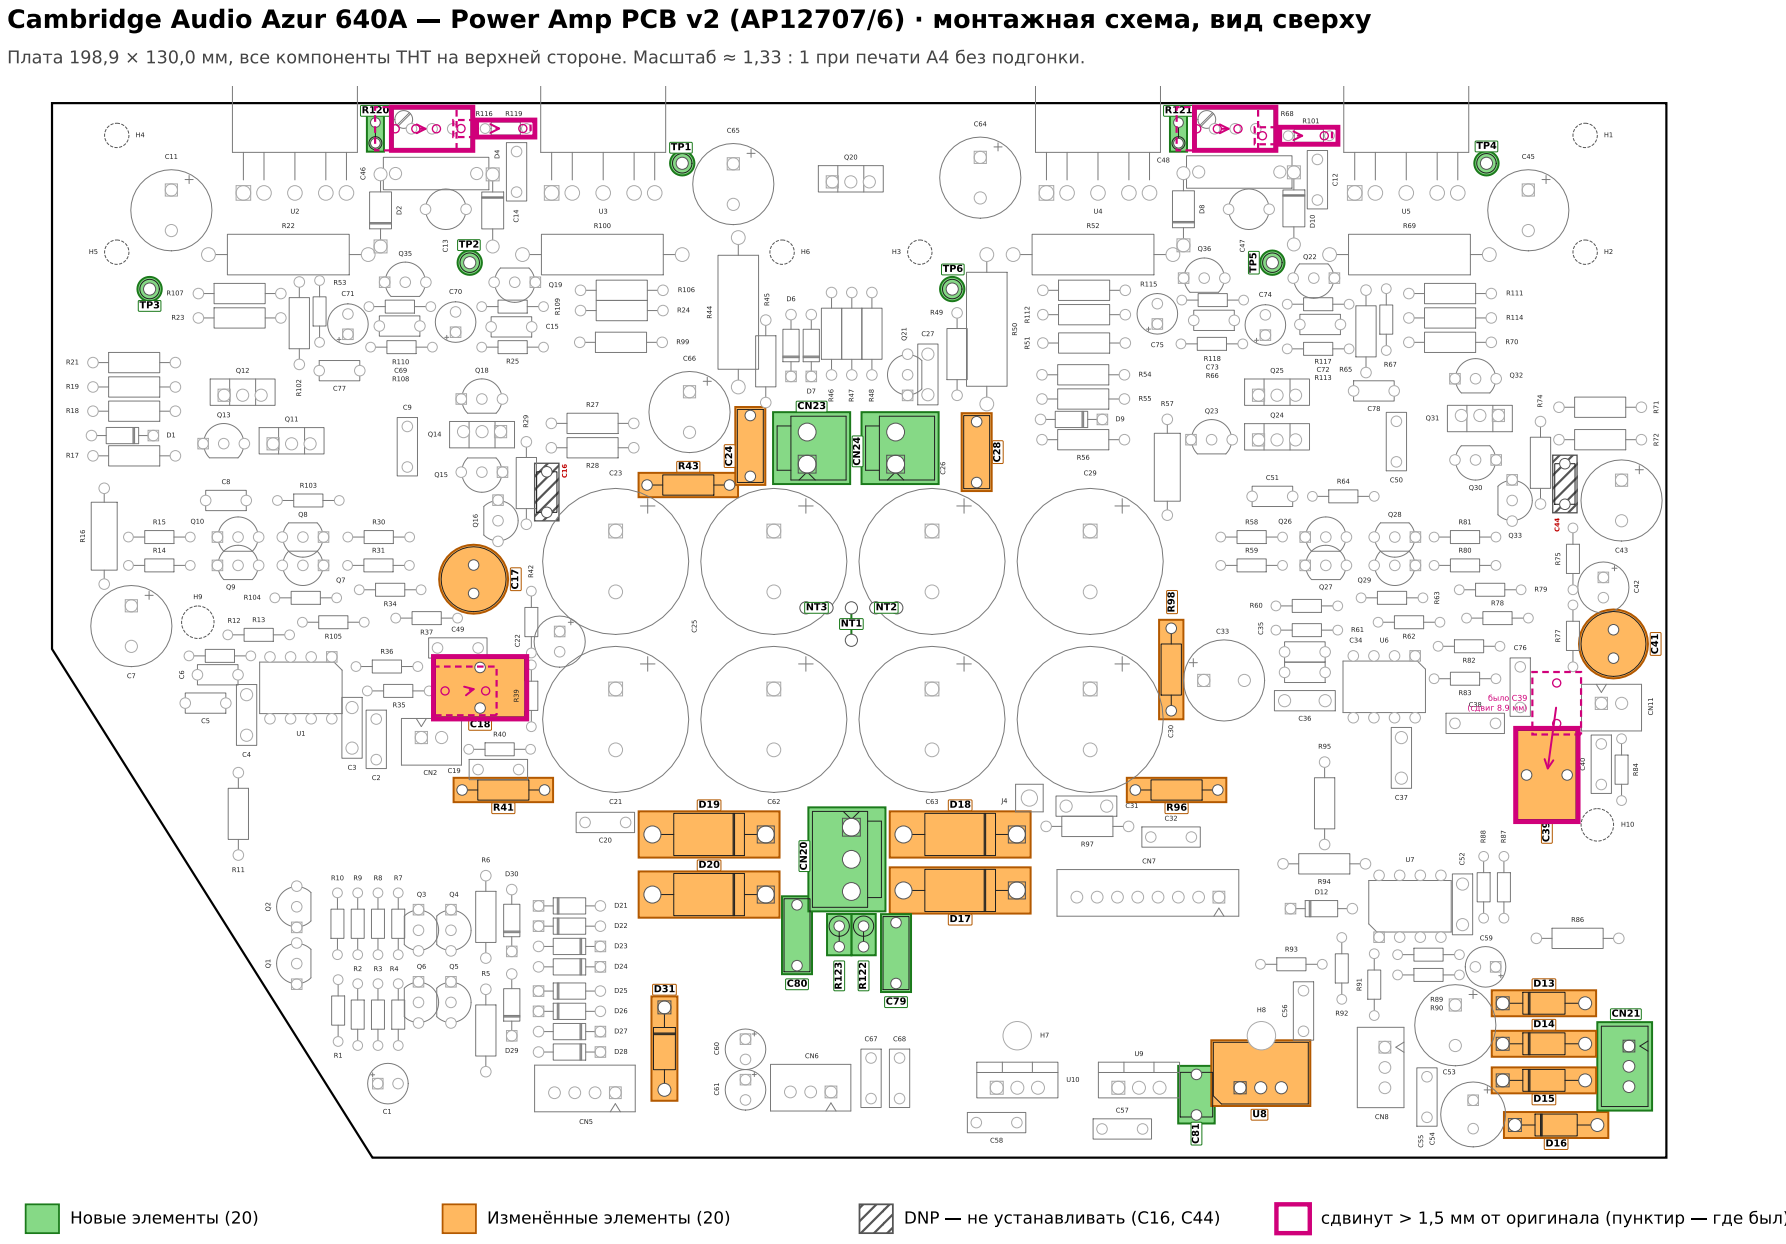
[picture p9: page 1]

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

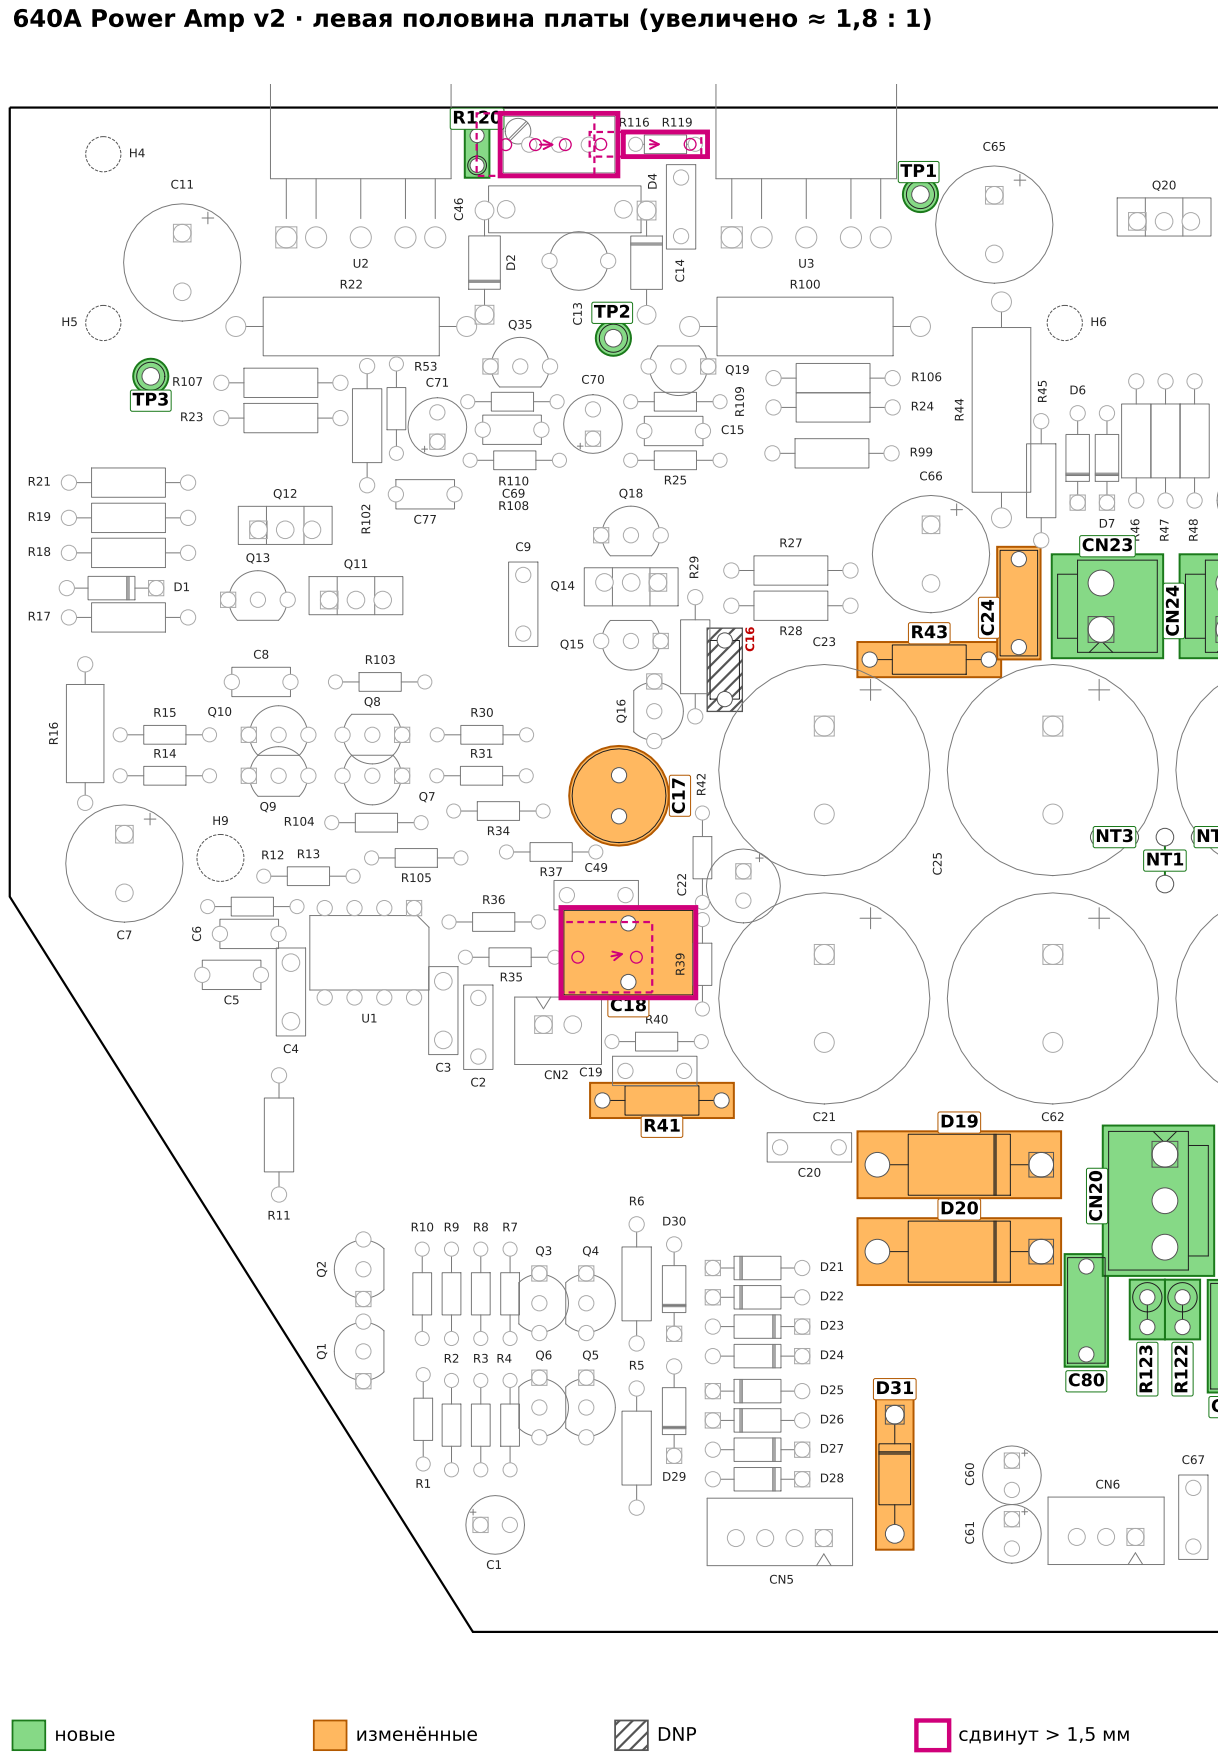
[picture p10: page 2]

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

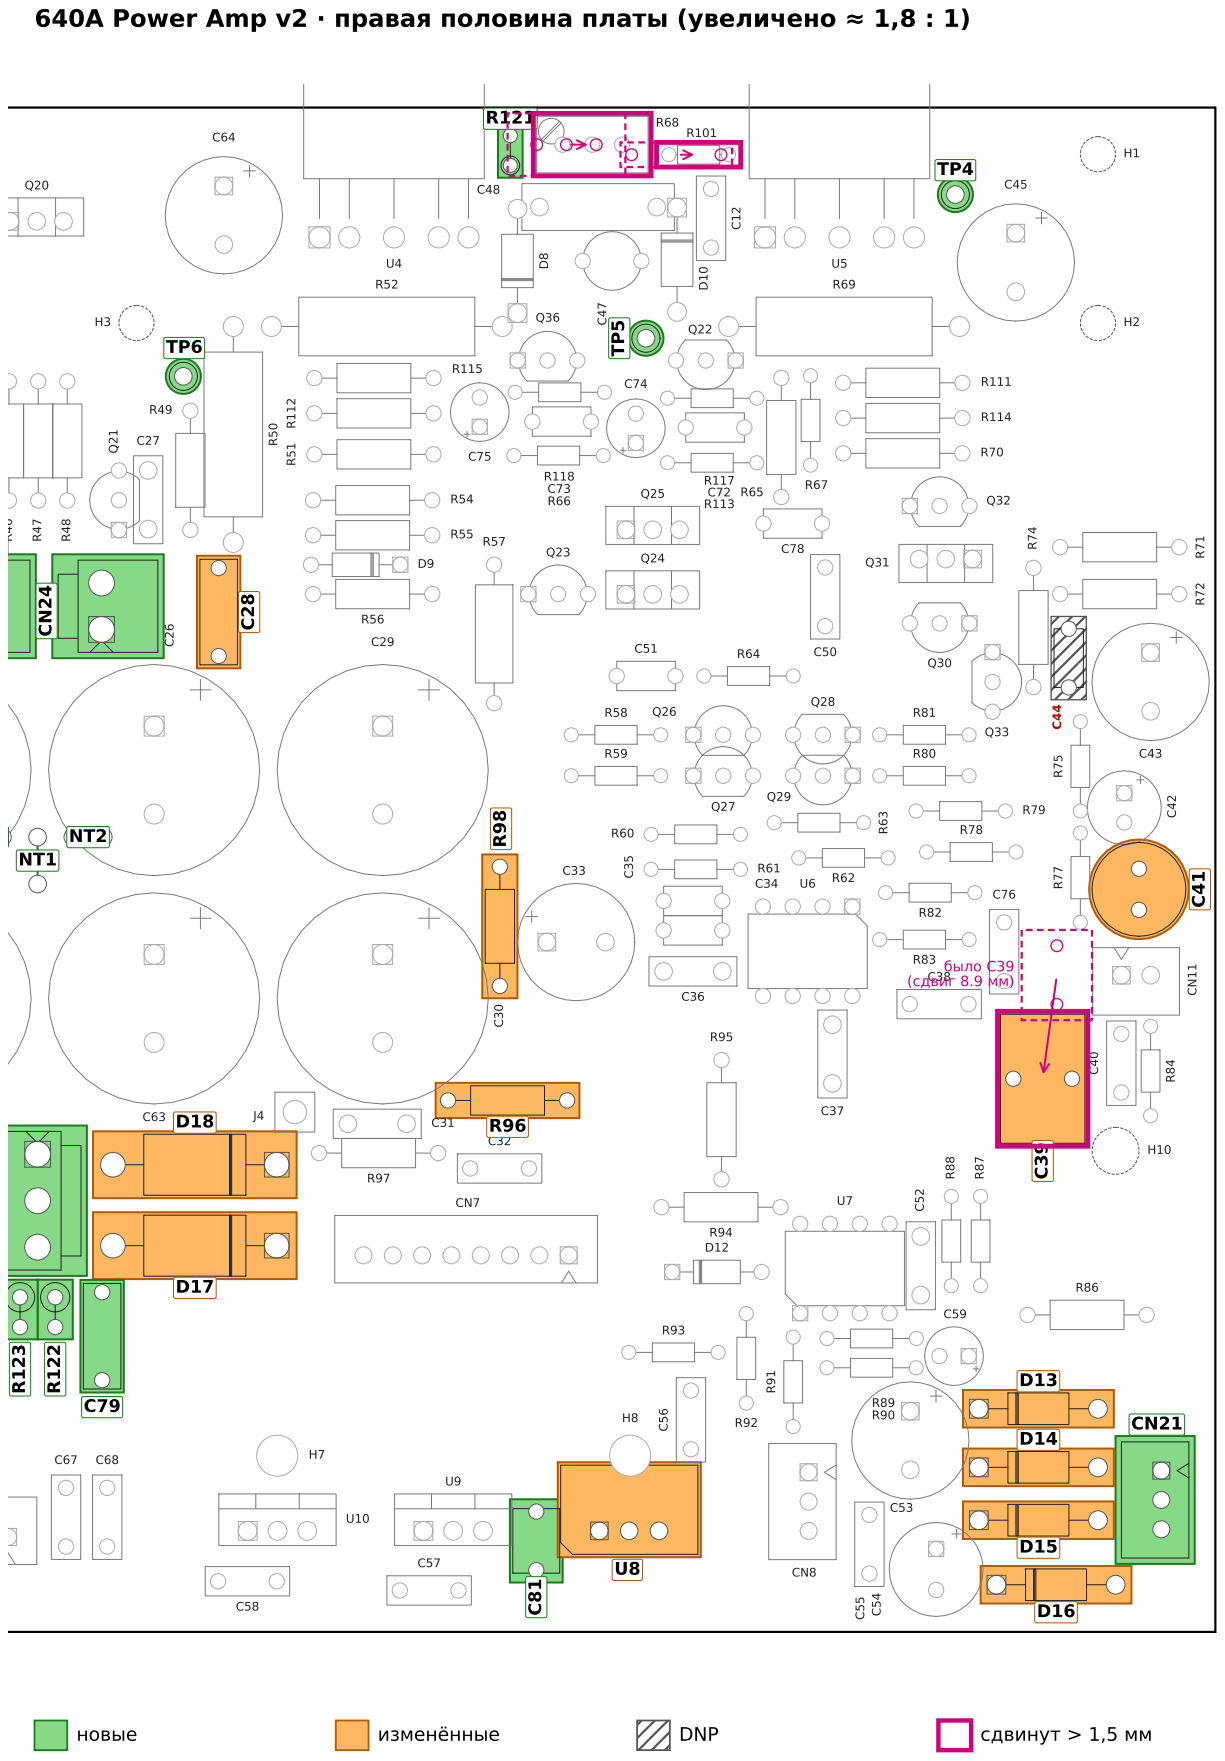
[picture p11: page 3]

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

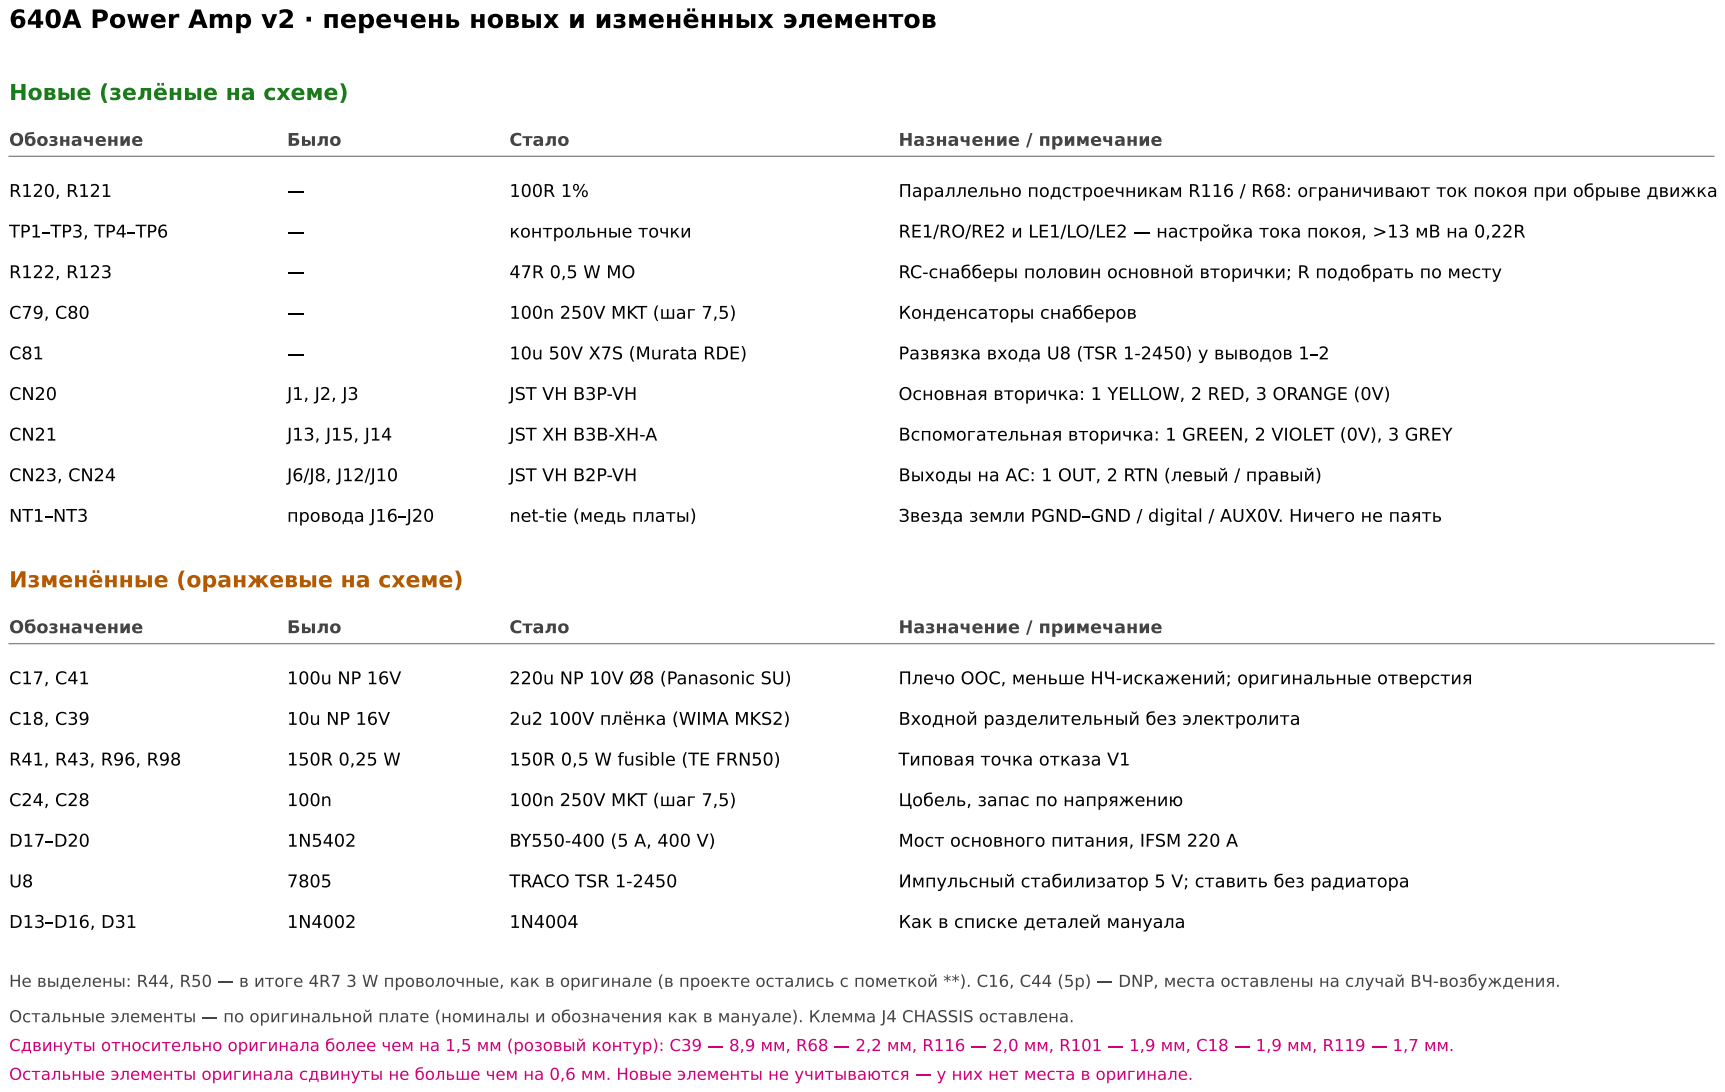
[picture p12: page 4]
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
