SSSound13/Cambridge_640A_PowerAmp/doc/640A_PowerAmp_v2_assembly_order.pdf

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

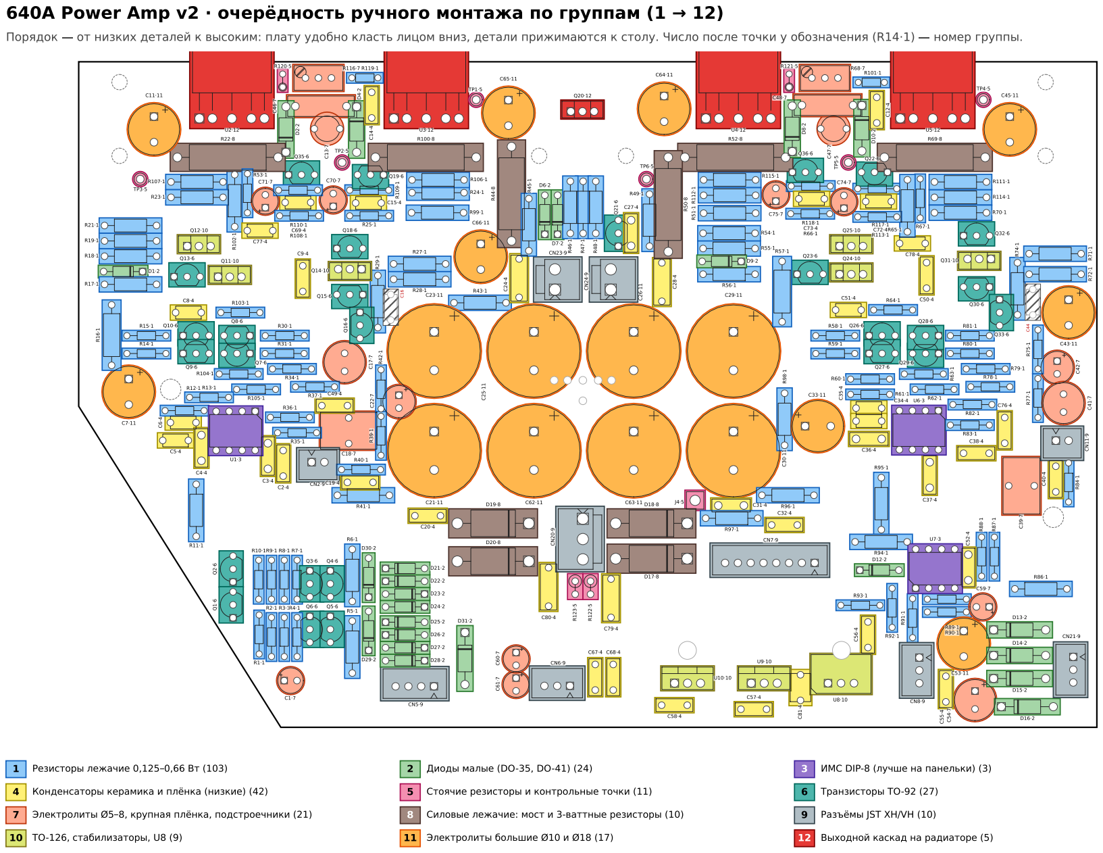
[picture p13: page 1]

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

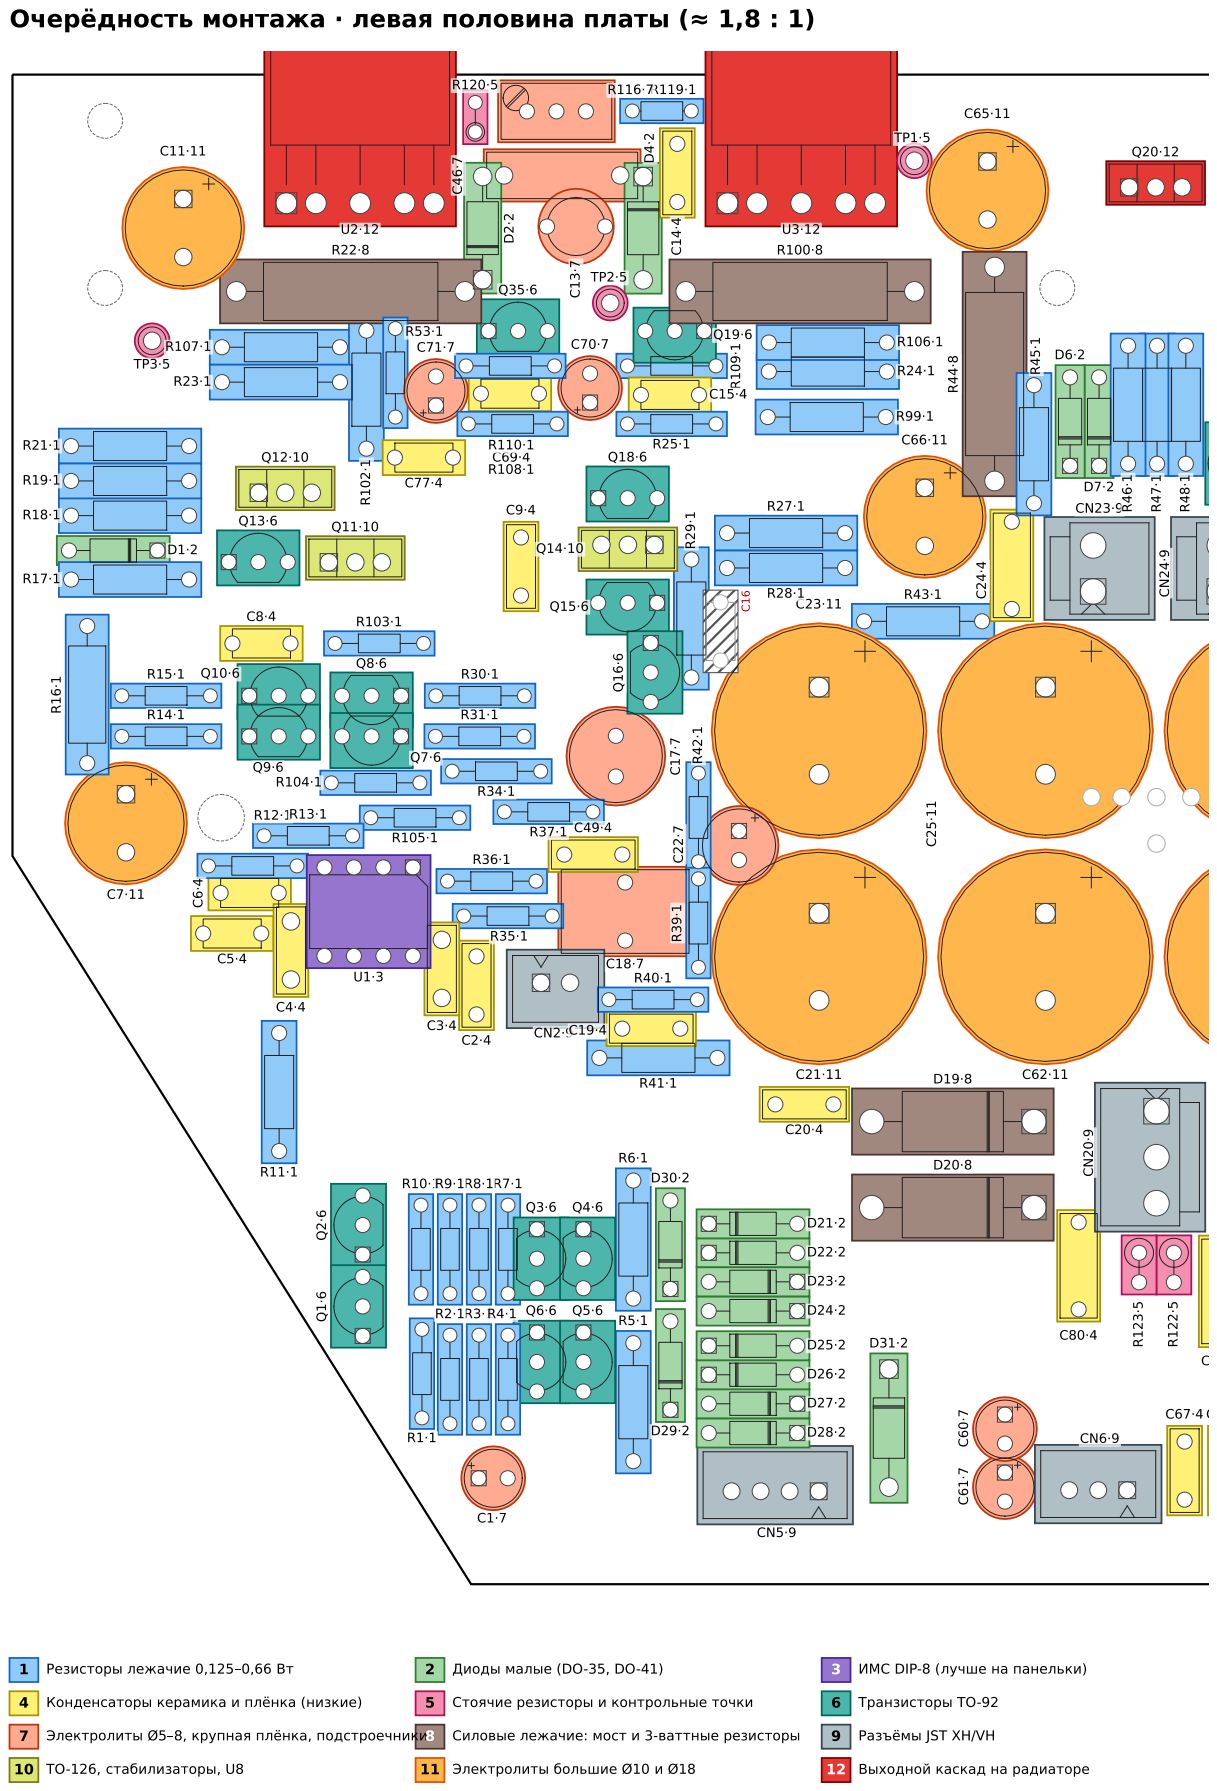
[picture p14: page 2]

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

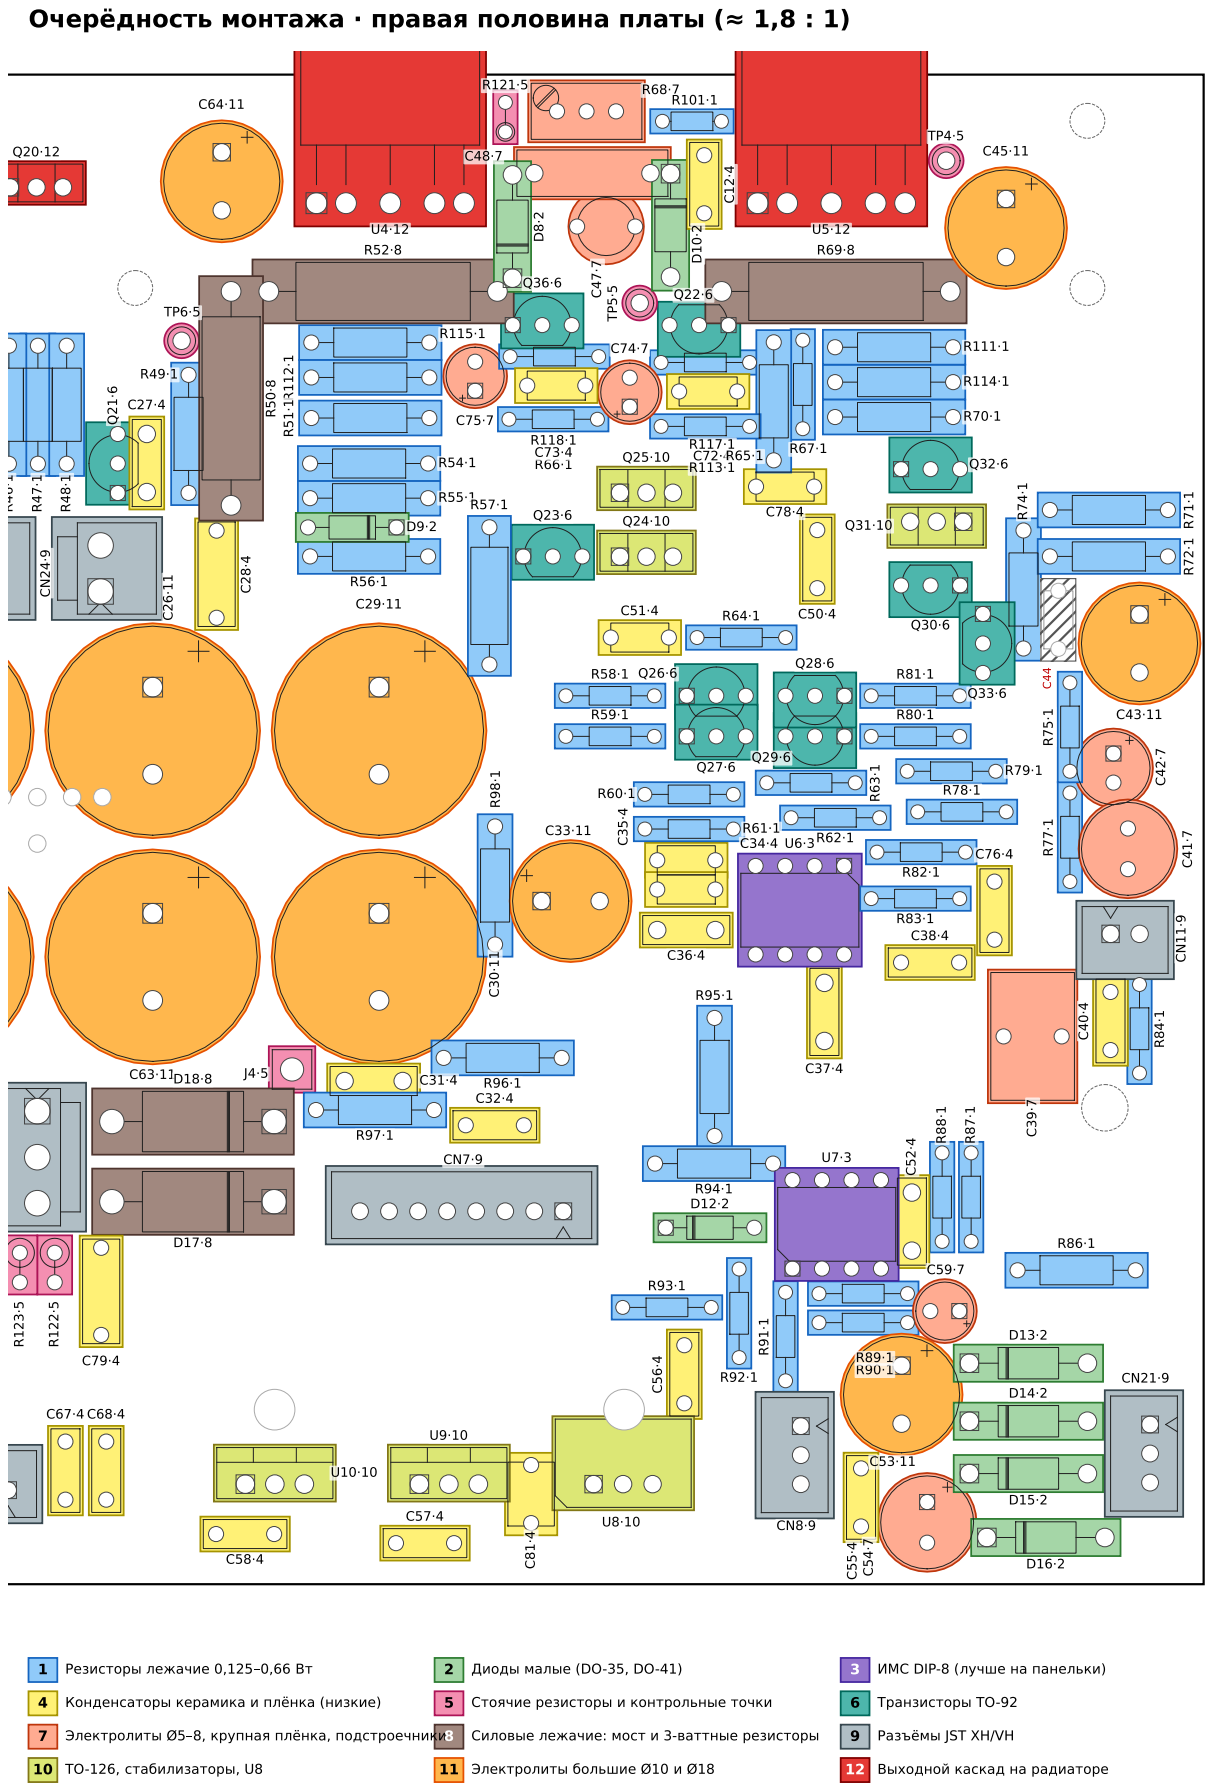
[picture p15: page 3]

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

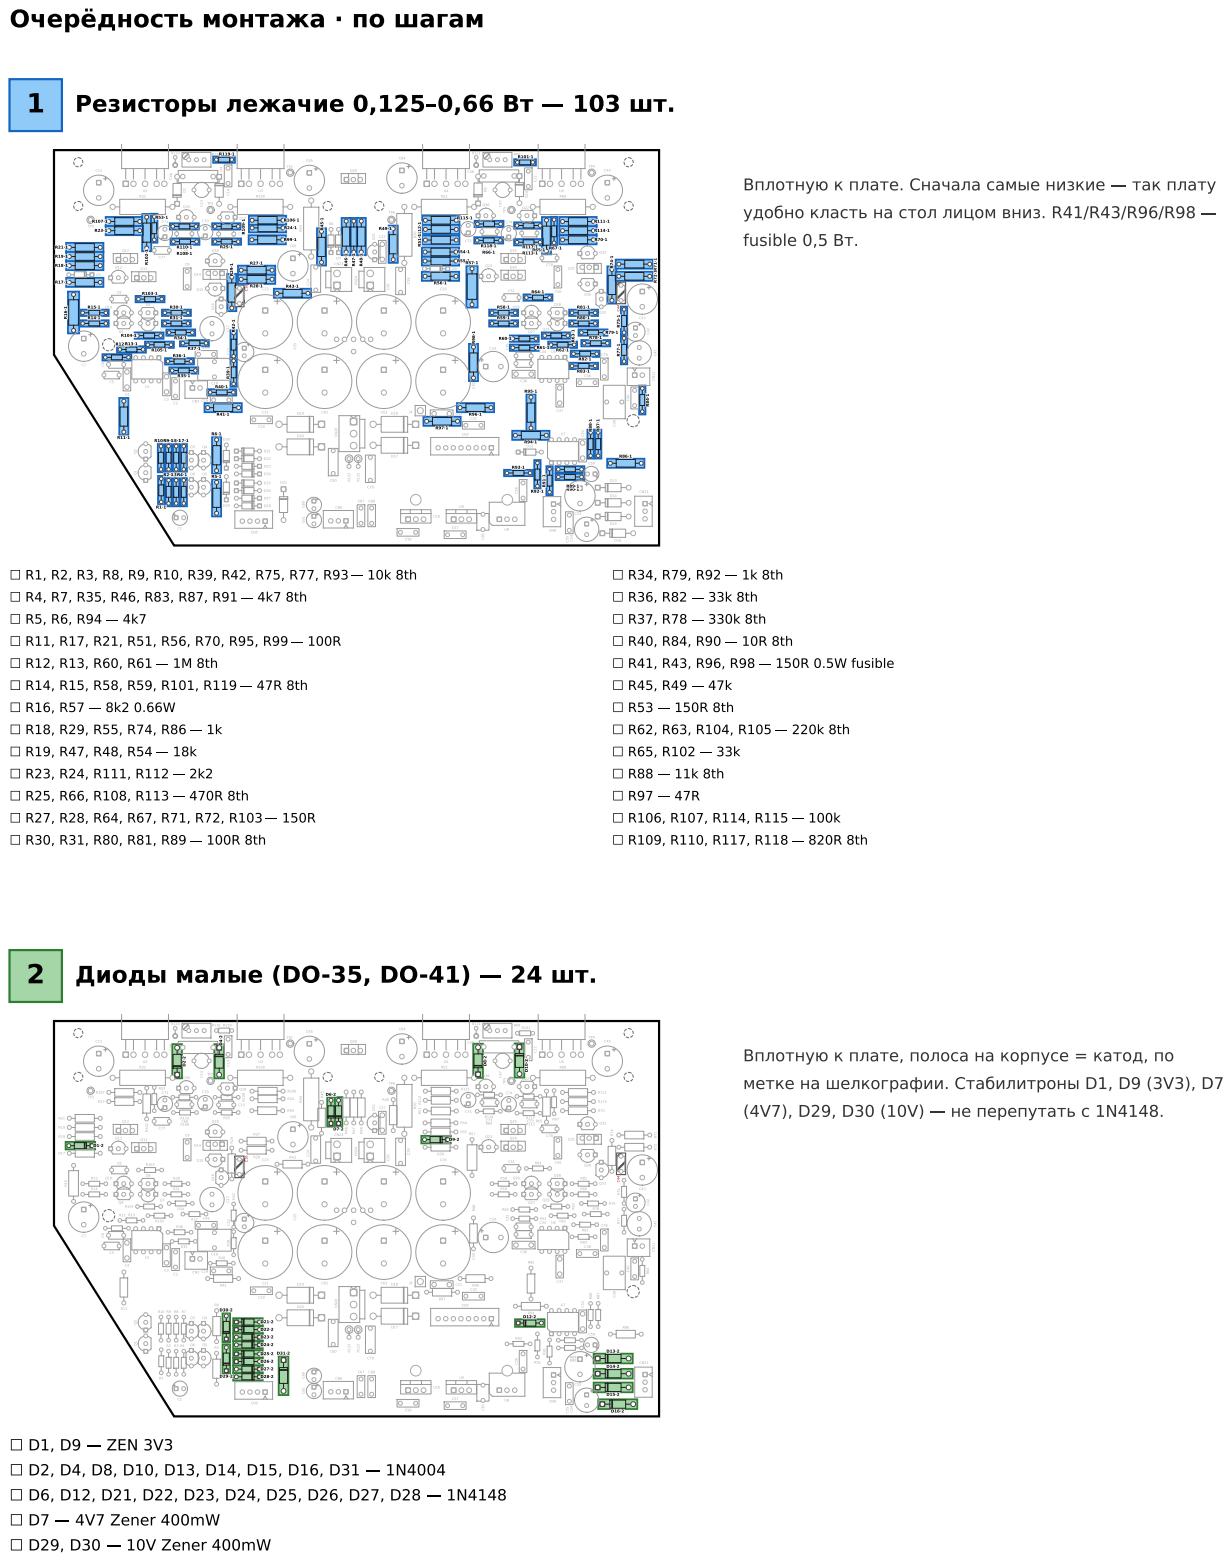
[picture p16: page 4]

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

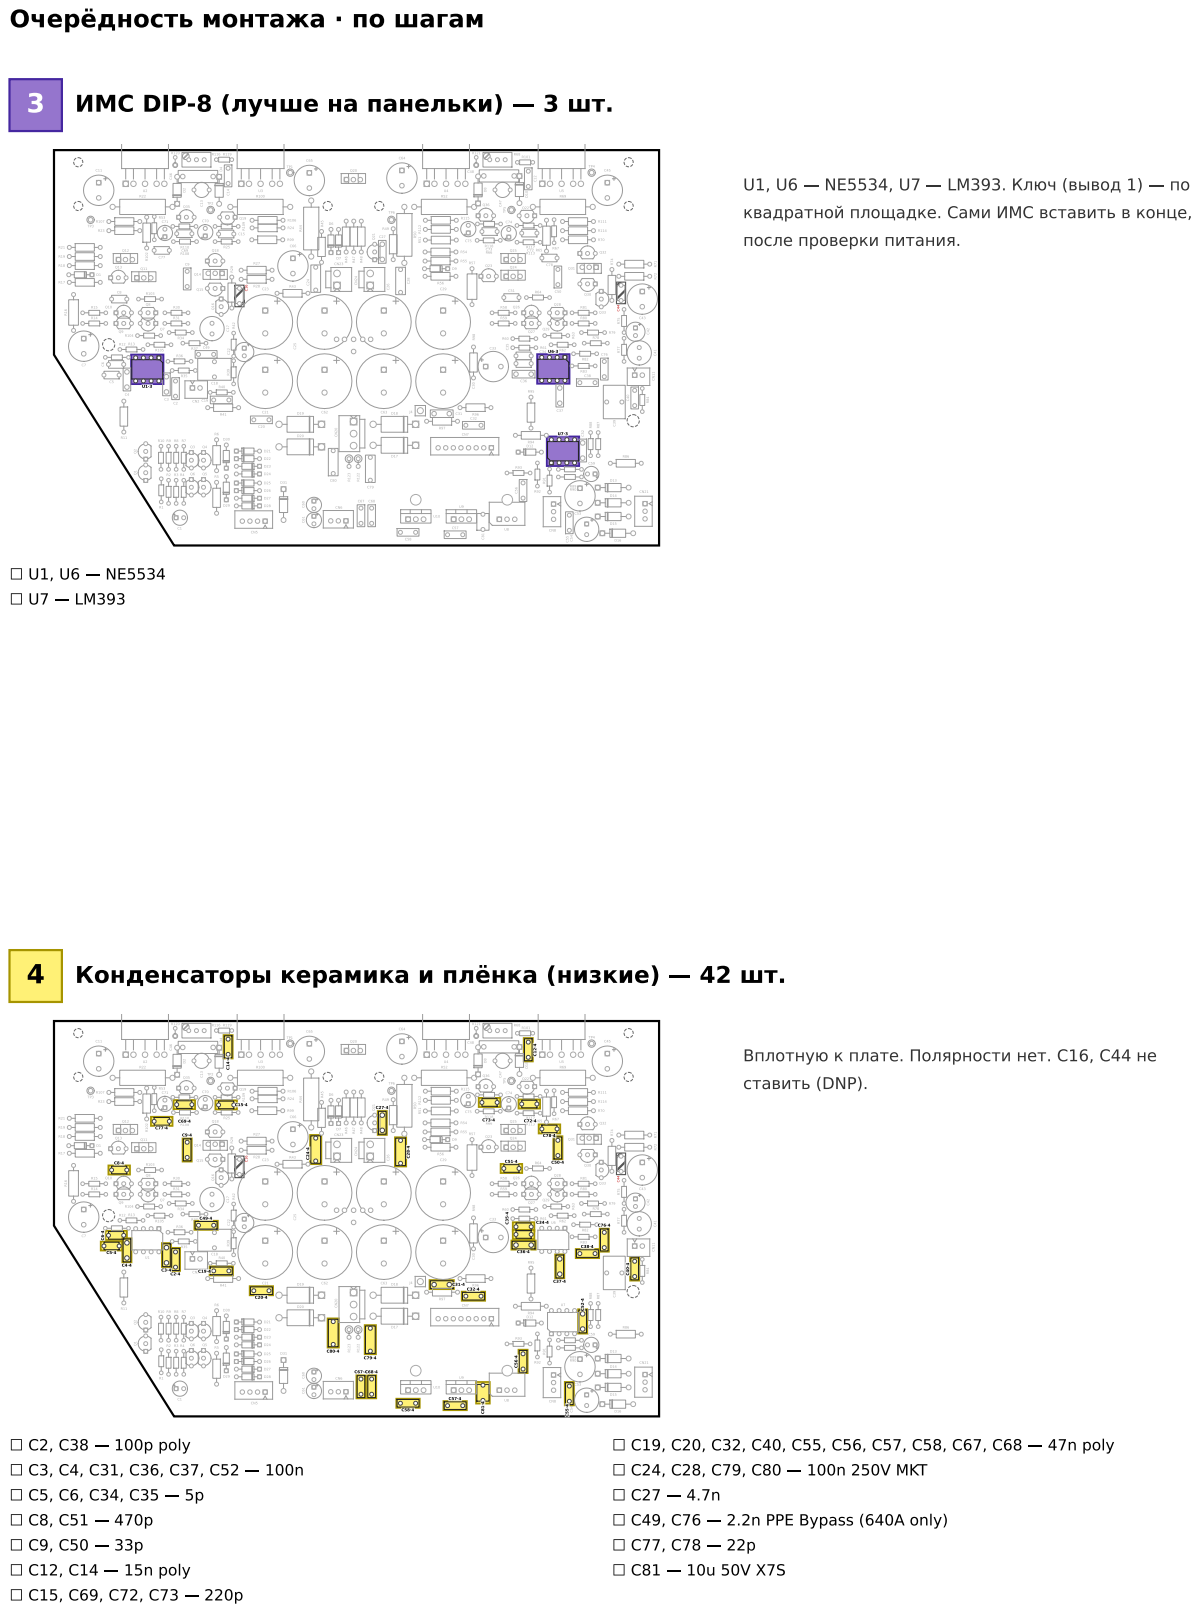
[picture p17: page 5]

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

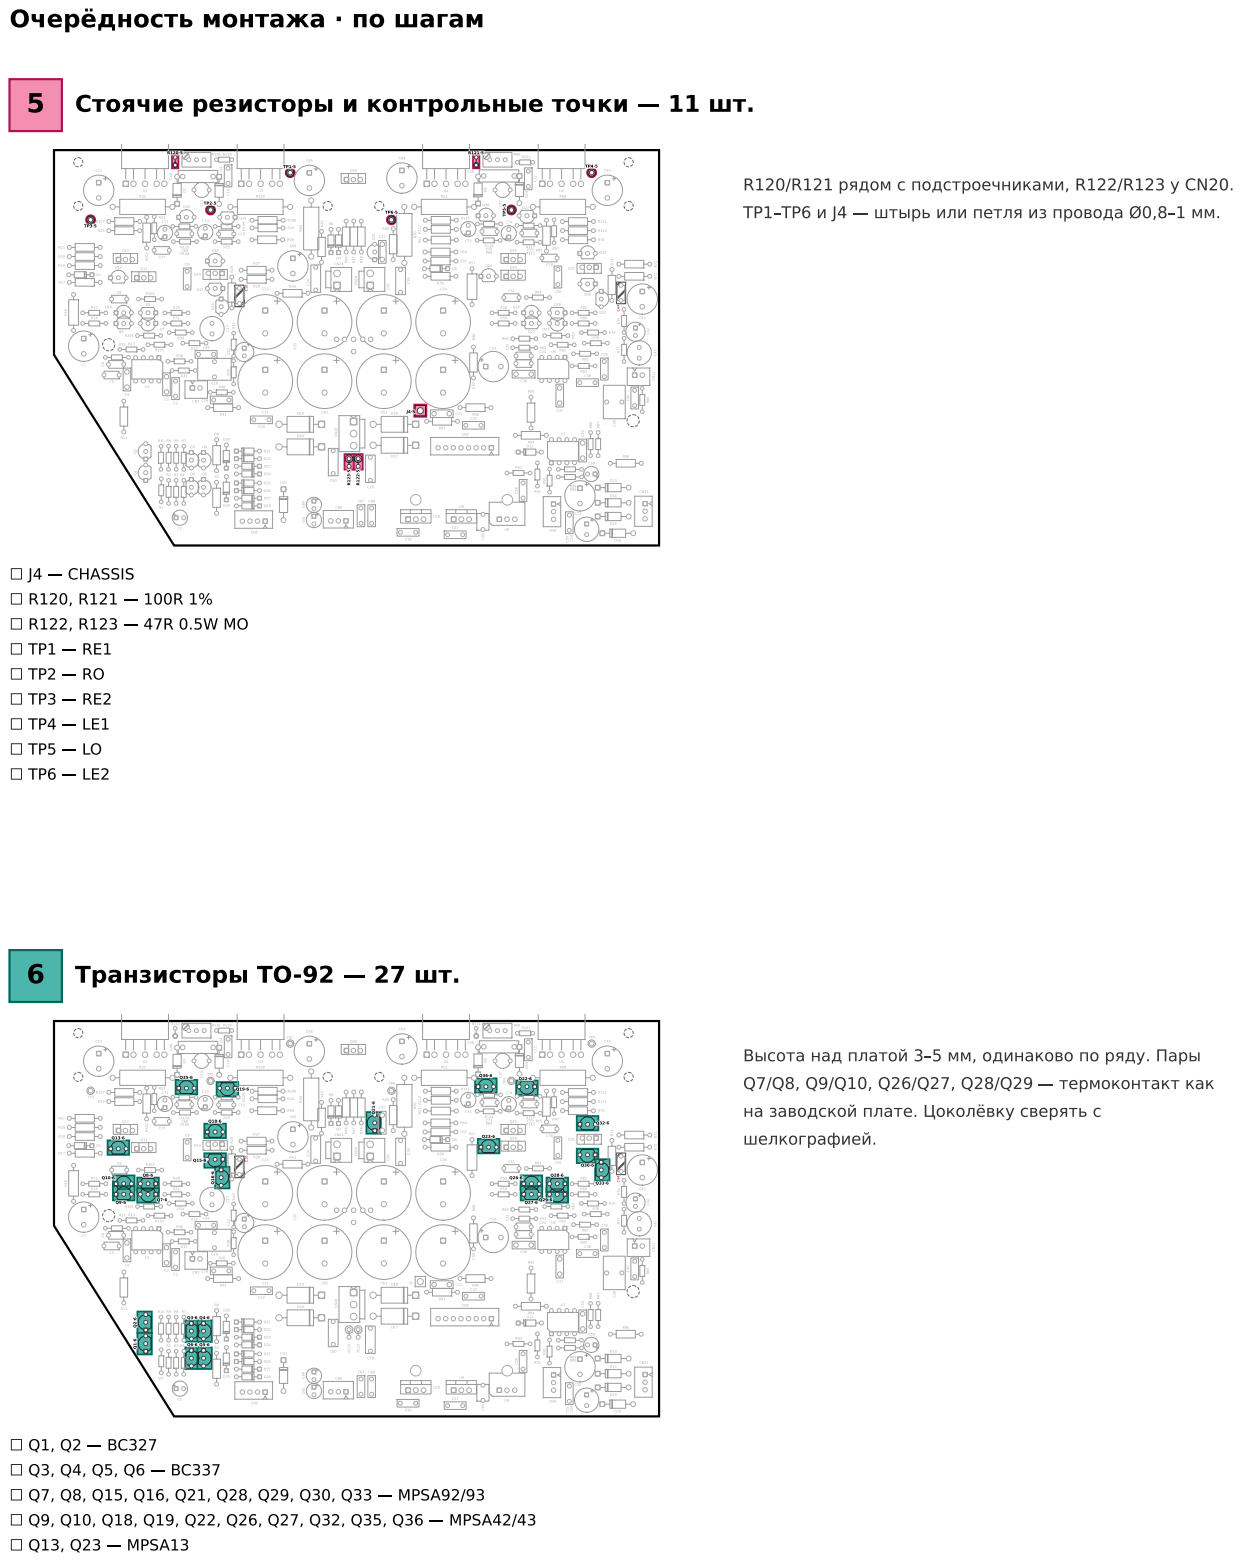
[picture p18: page 6]

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

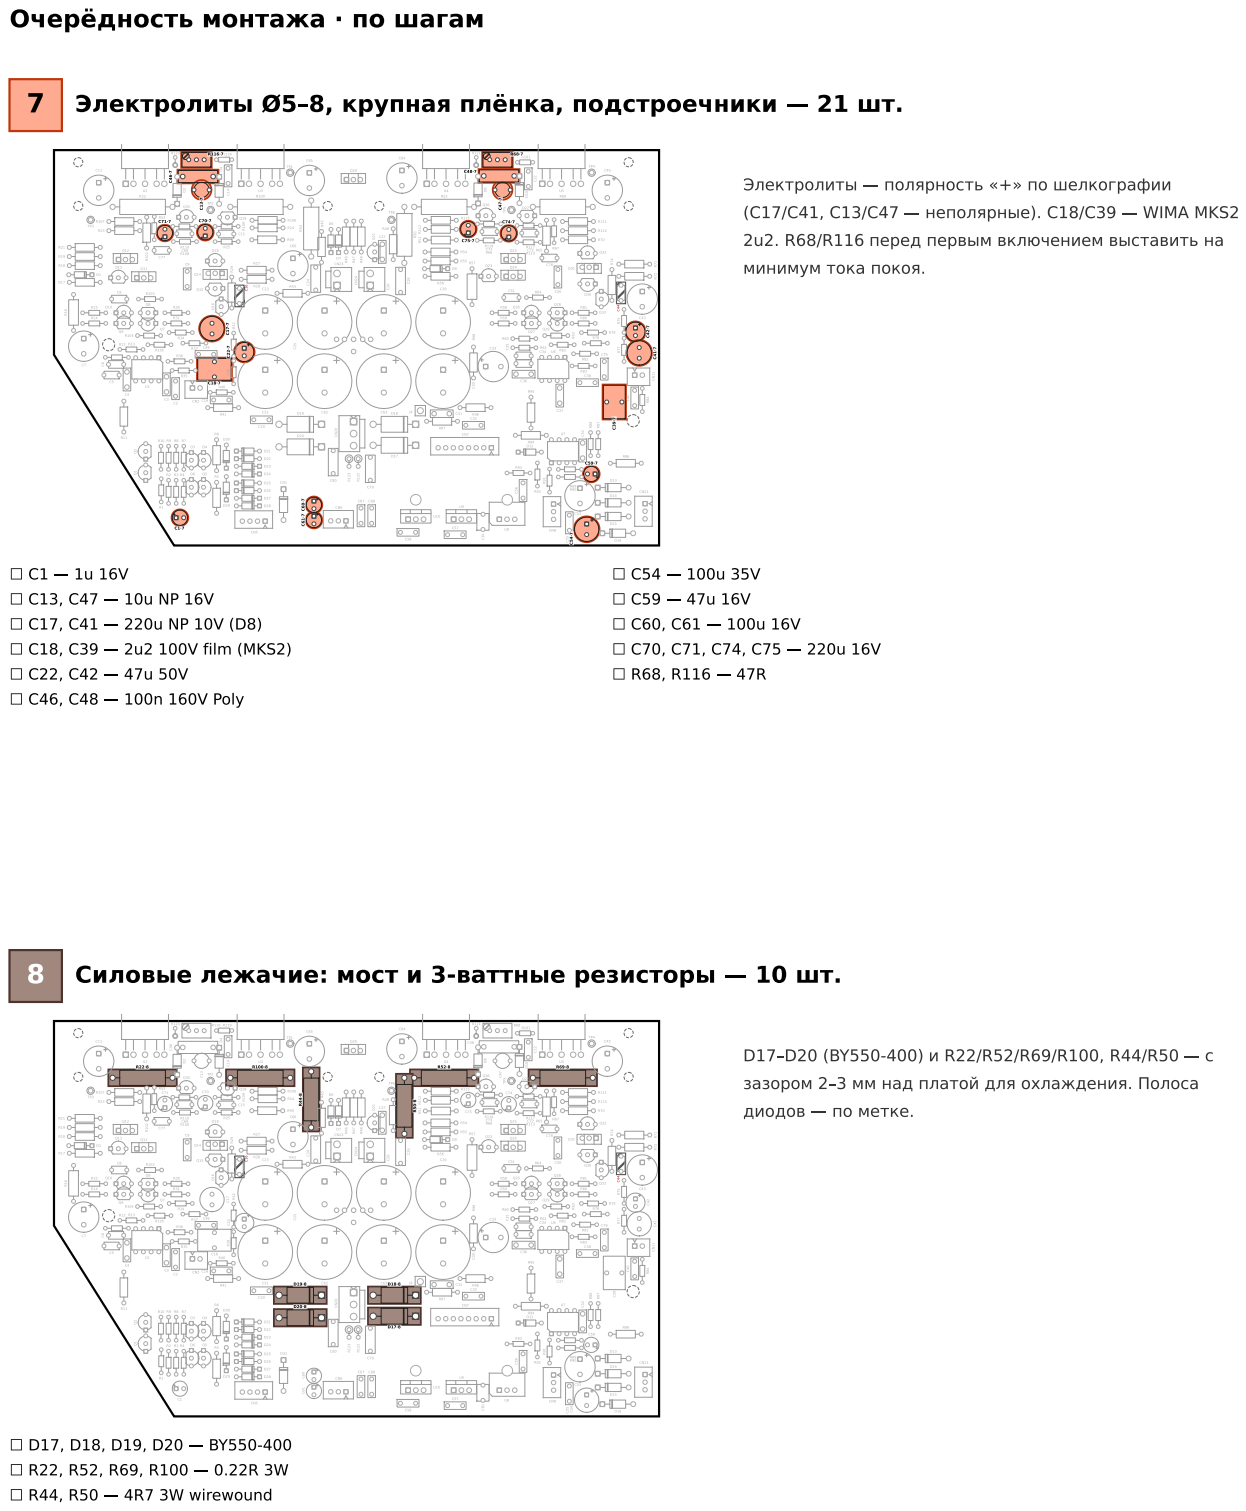
[picture p19: page 7]

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

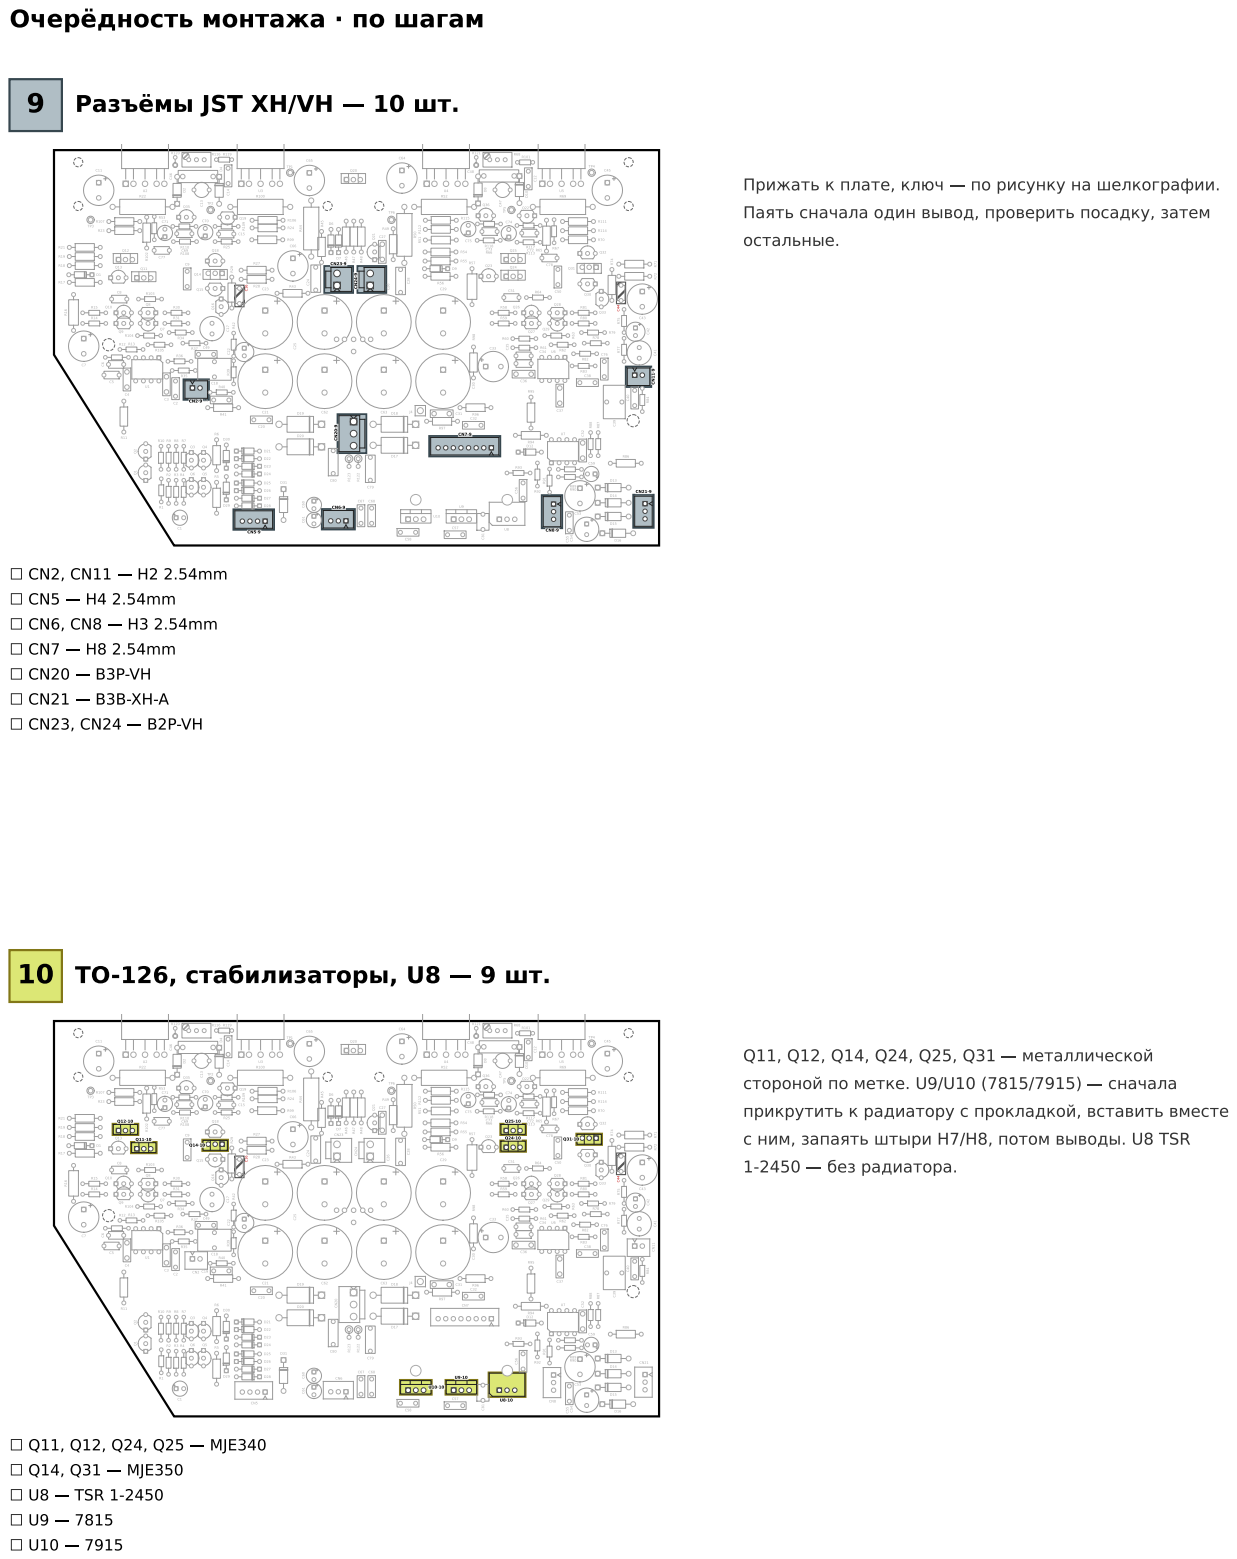
[picture p20: page 8]

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

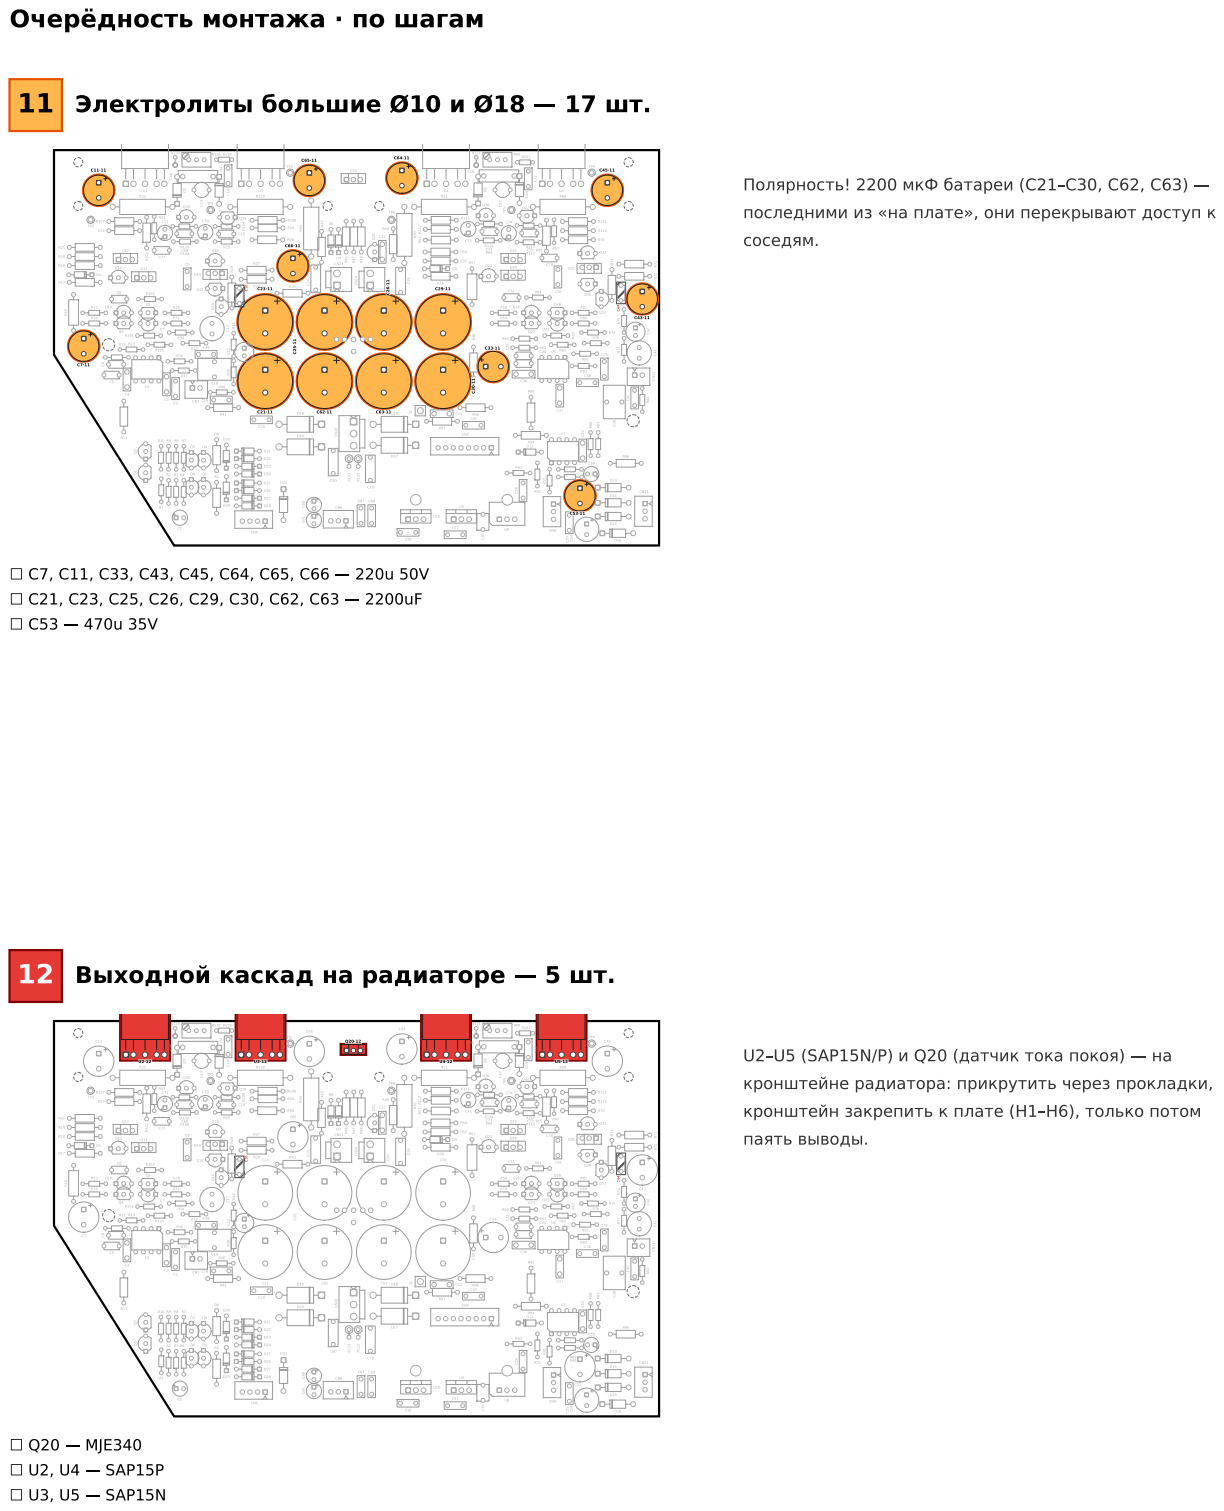
[picture p21: page 9]
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
