SSSound13/Cambridge_640A_PowerAmp/doc/640A_PowerAmp_v2_wiring.pdf

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

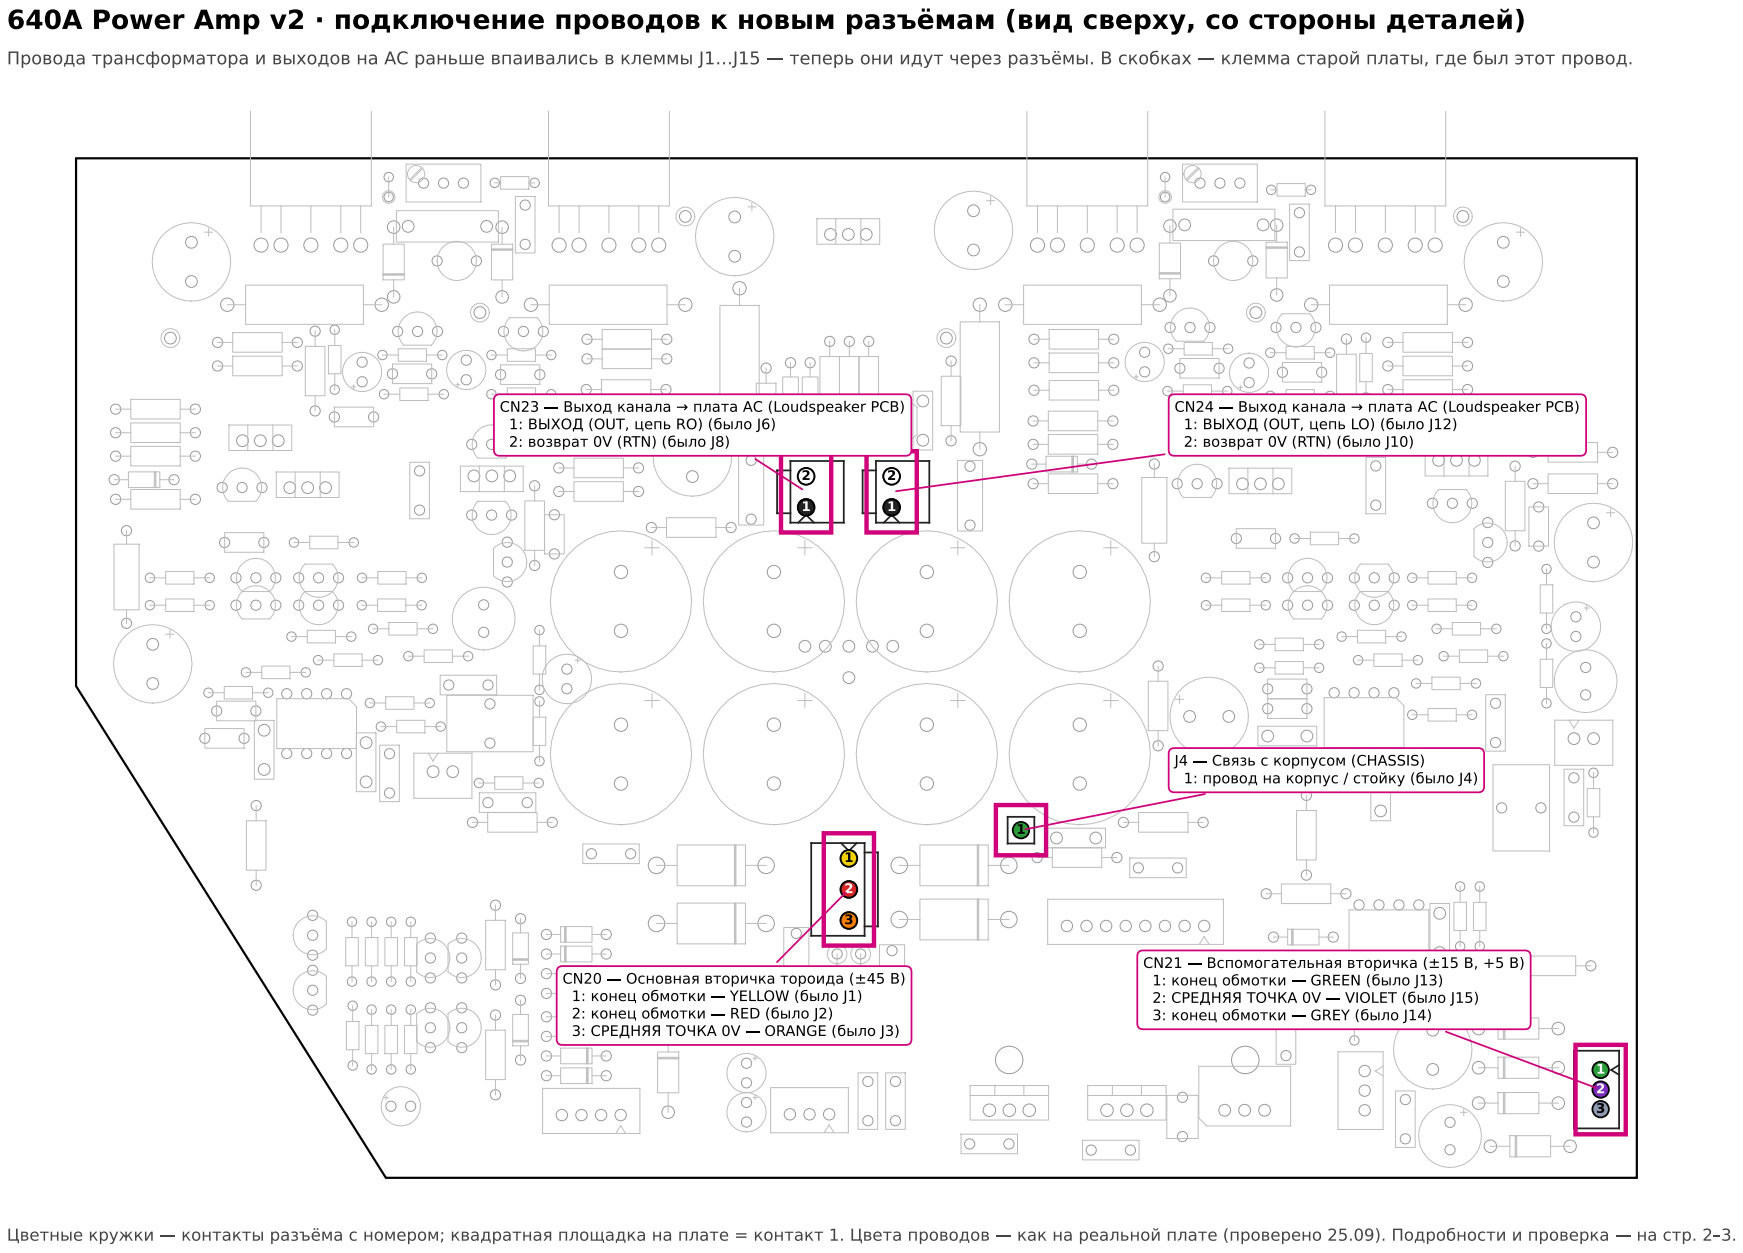
[picture p22: page 1]

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

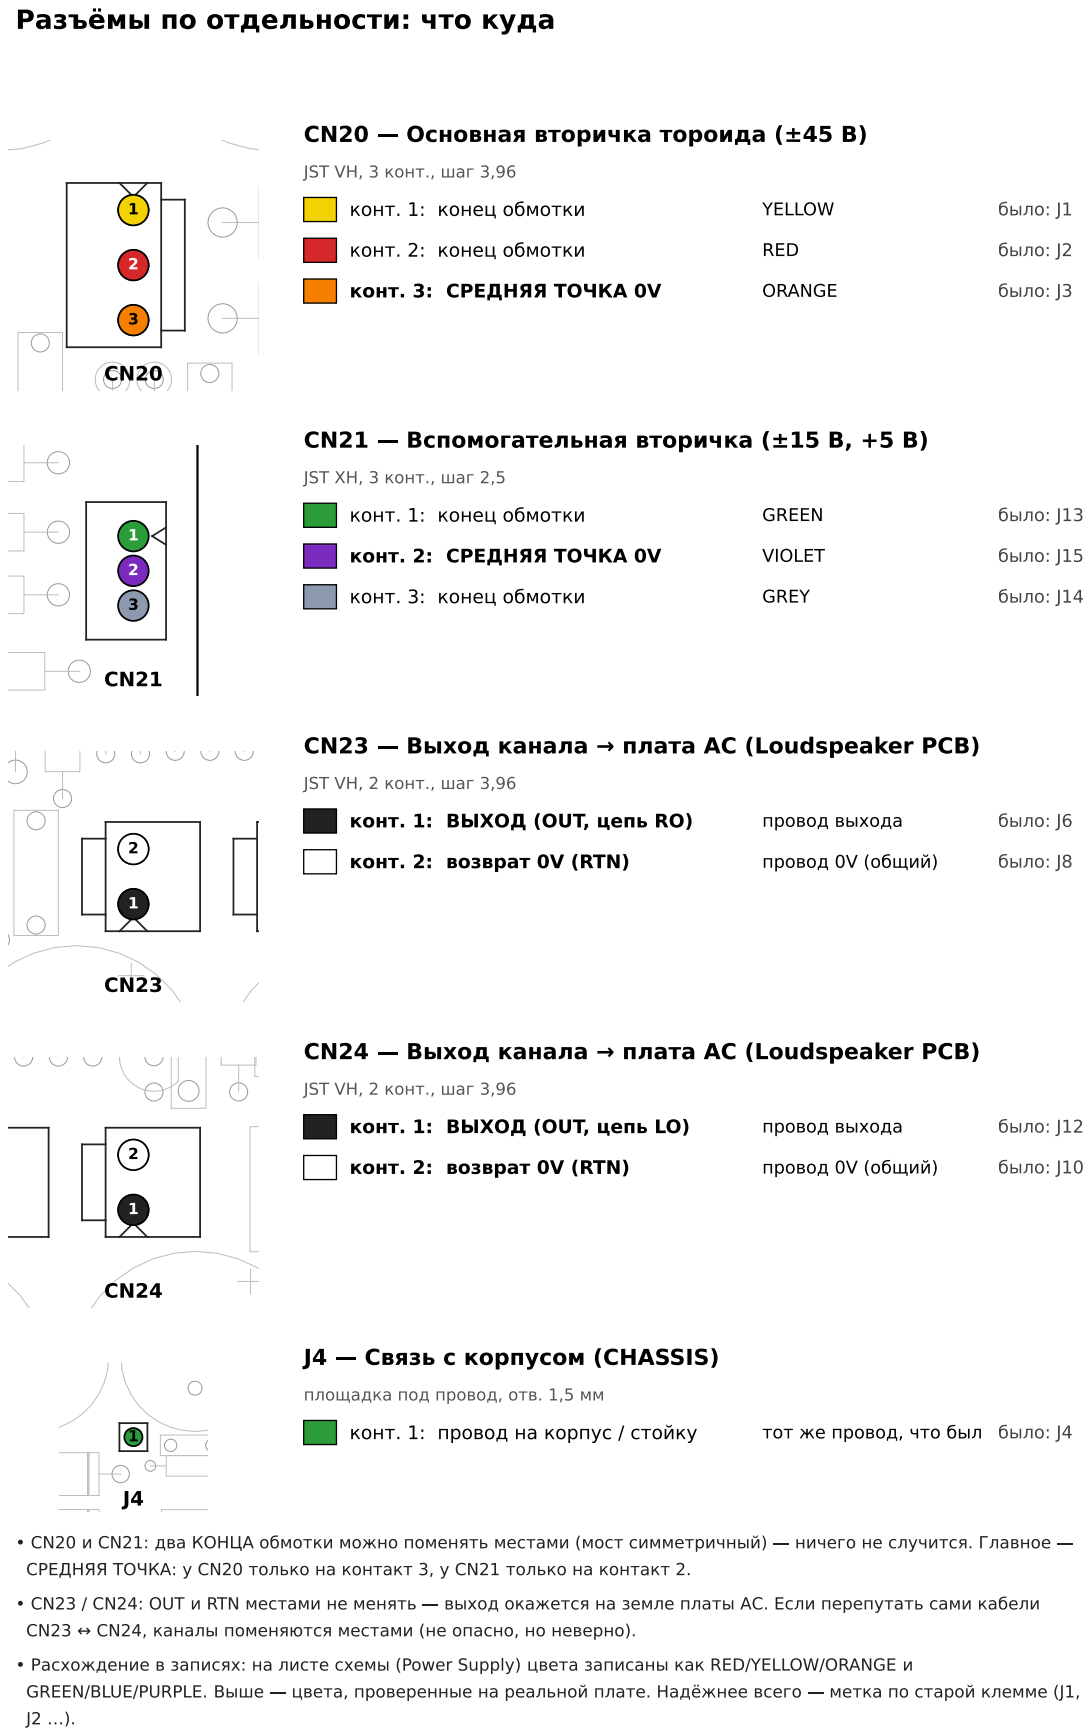
[picture p23: page 2]

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

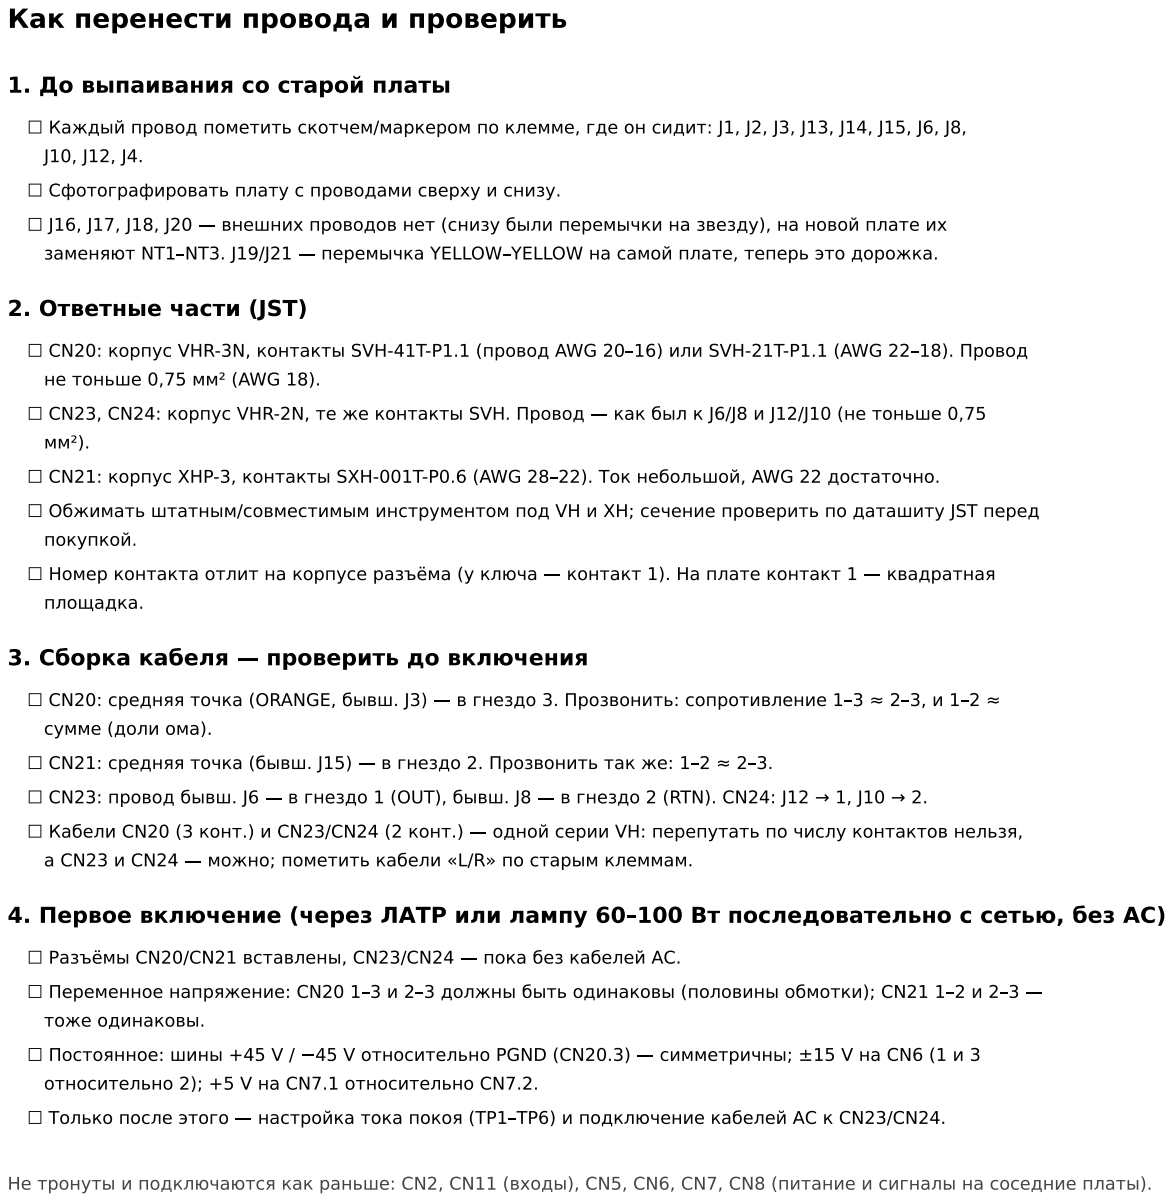
[picture p24: page 3]
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
