SSSound13/Cambridge_640A_PowerAmp/640A_PowerAmp.kicad_pcb

## KiCad design 640A_PowerAmp.kicad_pcb (2026-11-07)

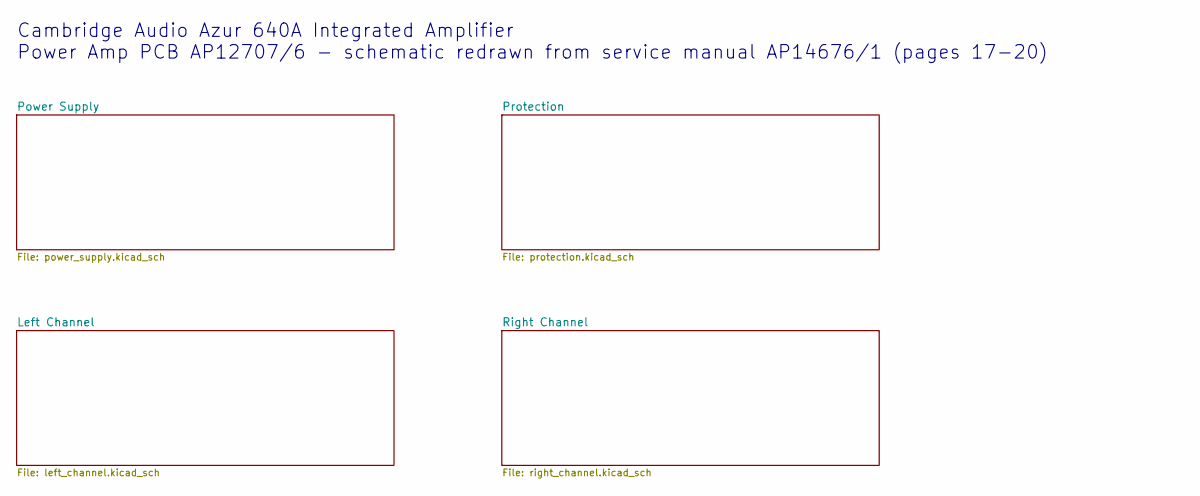
[picture p25: schematic 640A_PowerAmp.kicad_sch, Cambridge Azur 640A - Power Amp PCB AP12707/6]

Notes on the sheet:
Cambridge Audio Azur 640A Integrated Amplifier Power Amp PCB AP12707/6 - schematic redrawn from service manual AP14676/1 (pages 17-20)

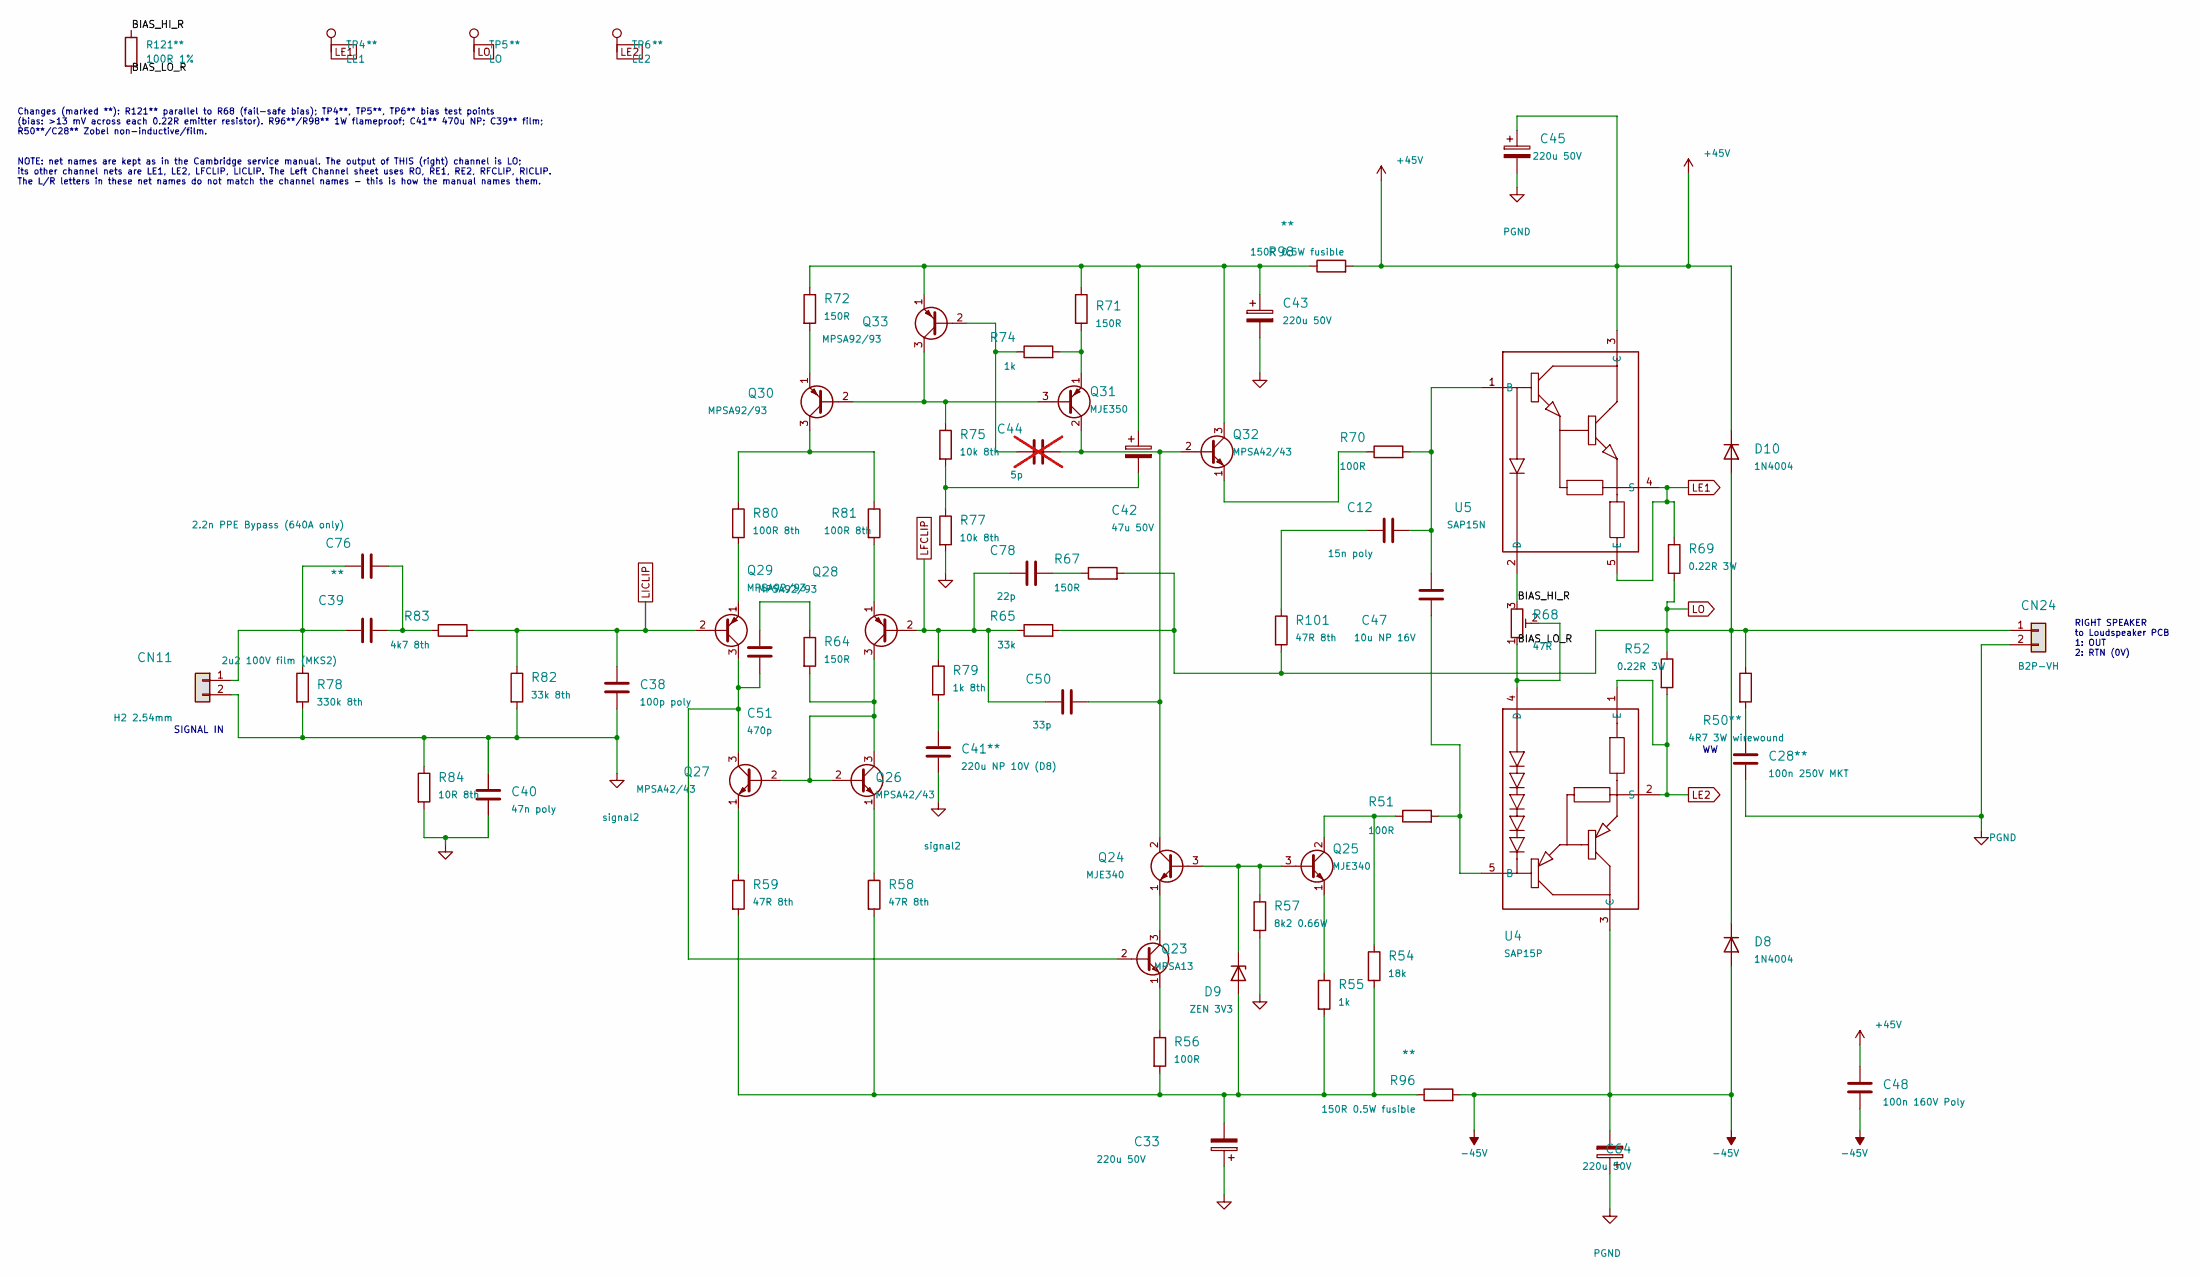
[picture p26: schematic right_channel.kicad_sch, AP12707/6 Power Amp Schematic (Right Channel)]

Parts:
C12: 15n poly; C_Rect_L7.2mm_W2.5mm_P5.00mm_FKS2_FKP2_MKS2_MKP2
C28: 100n 250V MKT; C_Rect_L9.0mm_W3.2mm_P7.50mm_MKT; MPN B32560J3104K000
C33, C43, C45, C64: 220u 50V; CP_Radial_D10.0mm_P5.00mm
C38: 100p poly; C_Rect_L7.2mm_W2.5mm_P5.00mm_FKS2_FKP2_MKS2_MKP2
C39: 2u2 100V film (MKS2); C_Rect_L7.2mm_W11.0mm_P5.00mm_FKS2_FKP2_MKS2_MKP2; MPN MKS2D042201N00KO00 (MKS2-2.2U/100-R)
C40: 47n poly; C_Rect_L7.2mm_W2.5mm_P5.00mm_FKS2_FKP2_MKS2_MKP2
C41: 220u NP 10V (D8); C_Radial_D8.0mm_H11.5mm_P3.50mm; MPN ECE-A1AN221U
C42: 47u 50V; CP_Radial_D6.3mm_P2.50mm
C44: 5p; C_Disc_D5.0mm_W2.5mm_P5.00mm; not fitted
C47: 10u NP 16V; C_Radial_D5.0mm_P5.00mm_NP
C48: 100n 160V Poly; C_Rect_L13.0mm_W4.0mm_P10.00mm_FKS3_FKP3_MKS4
C50: 33p; C_Rect_L7.2mm_W2.5mm_P5.00mm_FKS2_FKP2_MKS2_MKP2
C51: 470p; C_Disc_D5.0mm_W2.5mm_P5.00mm
C76: 2.2n PPE Bypass (640A only); C_Rect_L7.2mm_W2.5mm_P5.00mm_FKS2_FKP2_MKS2_MKP2
C78: 22p; C_Disc_D5.0mm_W2.5mm_P5.00mm
CN11: H2 2.54mm; JST_XH_B2B-XH-A_1x02_P2.50mm_Vertical
CN24: B2P-VH; JST_VH_B2P-VH_1x02_P3.96mm_Vertical; MPN B2P-VH
D8, D10: 1N4004; D_DO-41_SOD81_P8.89mm_Horizontal
D9: ZEN 3V3; D_DO-35_SOD27_P7.62mm_Horizontal
Q23: MPSA13; TO-92_Inline_Wide
Q24, Q25: MJE340; TO-126-3_Vertical
Q26, Q27, Q32: MPSA42/43; TO-92_Inline_Wide
Q28, Q29, Q30, Q33: MPSA92/93; TO-92_Inline_Wide
Q31: MJE350; TO-126-3_Vertical
R50: 4R7 3W wirewound; R_Axial_DIN0516_L15.5mm_D5.0mm_P18.42mm_Horizontal; MPN AC03000004708JAC00
R51, R56, R70: 100R; R_Axial_DIN0207_L6.3mm_D2.5mm_P10.16mm_Horizontal
R52, R69: 0.22R 3W; R_Axial_DIN0516_L15.5mm_D5.0mm_P19.69mm_Horizontal
R54: 18k; R_Axial_DIN0207_L6.3mm_D2.5mm_P10.16mm_Horizontal
R55, R74: 1k; R_Axial_DIN0207_L6.3mm_D2.5mm_P10.16mm_Horizontal
R57: 8k2 0.66W; R_Axial_DIN0309_L9.0mm_D3.2mm_P11.81mm_Horizontal
R58, R59: 47R 8th; R_Axial_DIN0204_L3.6mm_D1.6mm_P7.62mm_Horizontal
R64, R67: 150R; R_Axial_DIN0204_L3.6mm_D1.6mm_P7.62mm_Horizontal
R65: 33k; R_Axial_DIN0207_L6.3mm_D2.5mm_P10.16mm_Horizontal
R68: 47R; Potentiometer_Bourns_3296W_Vertical
R71, R72: 150R; R_Axial_DIN0207_L6.3mm_D2.5mm_P10.16mm_Horizontal
R75, R77: 10k 8th; R_Axial_DIN0204_L3.6mm_D1.6mm_P7.62mm_Horizontal
R78: 330k 8th; R_Axial_DIN0204_L3.6mm_D1.6mm_P7.62mm_Horizontal
R79: 1k 8th; R_Axial_DIN0204_L3.6mm_D1.6mm_P7.62mm_Horizontal
R80, R81: 100R 8th; R_Axial_DIN0204_L3.6mm_D1.6mm_P7.62mm_Horizontal
R82: 33k 8th; R_Axial_DIN0204_L3.6mm_D1.6mm_P7.62mm_Horizontal
R83: 4k7 8th; R_Axial_DIN0204_L3.6mm_D1.6mm_P7.62mm_Horizontal
R84: 10R 8th; R_Axial_DIN0204_L3.6mm_D1.6mm_P7.62mm_Horizontal
R96, R98: 150R 0.5W fusible; R_Axial_DIN0207_L6.3mm_D2.5mm_P10.16mm_Horizontal; MPN FRN50J150R/S
R101: 47R 8th; R_Axial_DIN0204_L3.6mm_D1.6mm_P5.08mm_Horizontal
R121: 100R 1%; R_Axial_DIN0204_L3.6mm_D1.6mm_P2.54mm_Vertical; MPN MF-25 0.25W 100R 1%
TP4: LE1; TestPoint_THTPad_D2.0mm_Drill1.0mm
TP5: LO; TestPoint_THTPad_D2.0mm_Drill1.0mm
TP6: LE2; TestPoint_THTPad_D2.0mm_Drill1.0mm
U4: SAP15P; TO-3P-5_SAP15_Horizontal
U5: SAP15N; TO-3P-5_SAP15_Horizontal

Connections:
+45V: C45.1, C48.1, D10.1 (K), R98.2, U5.3 (C); also elsewhere on the board
-45V: C48.2, C64.2, D8.2 (A), R96.2, U4.3 (C); also elsewhere on the board
/Right Channel/BIAS_HI_R: R68.3, R121.1, U5.2 (D)
/Right Channel/BIAS_LO_R: R68.1, R68.2, R121.2, U4.4 (D)
GND: C33.1, C40.2, C43.2, R57.2, R77.2, R84.2; also elsewhere on the board
LE1: R69.1, TP4.1 (1_1), U5.4 (S), U5.5 (E); also elsewhere on the board
LE2: R52.2, TP6.1 (1_1), U4.1 (E), U4.2 (S); also elsewhere on the board
LFCLIP: C50.1, C78.1, Q28.2 (B), R65.1, R79.1; also elsewhere on the board
LICLIP: C38.1, Q29.2 (B), R82.1, R83.2; also elsewhere on the board
LO: CN24.1, D8.1 (K), D10.2 (A), R50.1, R52.1, R65.2, R67.2, R69.2, R101.2, TP5.1 (1_1); also elsewhere on the board
unnamed: C12.1, R101.1
unnamed: C28.1, R50.2
unnamed: C39.2, C76.2, R83.1
unnamed: C41.1, R79.2
unnamed: C42.2, R75.2, R77.1
unnamed: C51.1, R64.1
unnamed: C78.2, R67.1
unnamed: C39.1, C76.1, CN11.1, R78.1
unnamed: C33.2, D9.2 (A), R54.2, R55.2, R56.2, R58.2, R59.2, R96.1
unnamed: D9.1 (K), Q24.3 (B), Q25.3 (B), R57.1
unnamed: C51.2, Q23.2 (B), Q27.3 (C), Q29.3 (C)
unnamed: Q23.3 (C), Q24.1 (E)
unnamed: Q23.1 (E), R56.1
unnamed: C44.2, C50.2, Q24.2 (C), Q31.2 (C), Q32.2 (B)
unnamed: Q25.2 (C), R51.1, R54.1
unnamed: Q25.1 (E), R55.1
unnamed: Q26.2 (B), Q26.3 (C), Q27.2 (B), Q28.3 (C), R64.2
unnamed: Q26.1 (E), R58.1
unnamed: Q27.1 (E), R59.1
unnamed: Q28.1 (E), R81.2
unnamed: Q29.1 (E), R80.2
unnamed: Q30.2 (B), Q31.3 (B), Q33.3 (C), R75.1
unnamed: Q30.3 (C), R80.1, R81.1
unnamed: Q30.1 (E), R72.2
unnamed: Q31.1 (E), R71.2, R74.2
unnamed: C42.1, C43.1, Q32.3 (C), Q33.1 (E), R71.1, R72.1, R98.1
unnamed: Q32.1 (E), R70.1
unnamed: C44.1, Q33.2 (B), R74.1
unnamed: C47.2, R51.2, U4.5 (B)
unnamed: C12.2, C47.1, R70.2, U5.1 (B)
PGND: C28.2, C45.2, C64.1, CN24.2; also elsewhere on the board
signal2: C38.2, C40.1, C41.2, CN11.2, R78.2, R82.2, R84.1

Notes on the sheet:
RIGHT SPEAKER to Loudspeaker PCB 1: OUT 2: RTN (0V)
NOTE: net names are kept as in the Cambridge service manual. The output of THIS (right) channel is LO; its other channel nets are LE1, LE2, LFCLIP, LICLIP. The Left Channel sheet uses RO, RE1, RE2, RFCLIP, RICLIP. The L/R letters in these net names do not match the channel names - this is how the m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
SIGNAL IN
Changes (marked **): R121** parallel to R68 (fail-safe bias); TP4**, TP5**, TP6** bias test points (bias: >13 mV across each 0.22R emitter resistor). R96**/R98** 1W flameproof; C41** 470u NP; C39** film; R50**/C28** Zobel non-inductive/film.

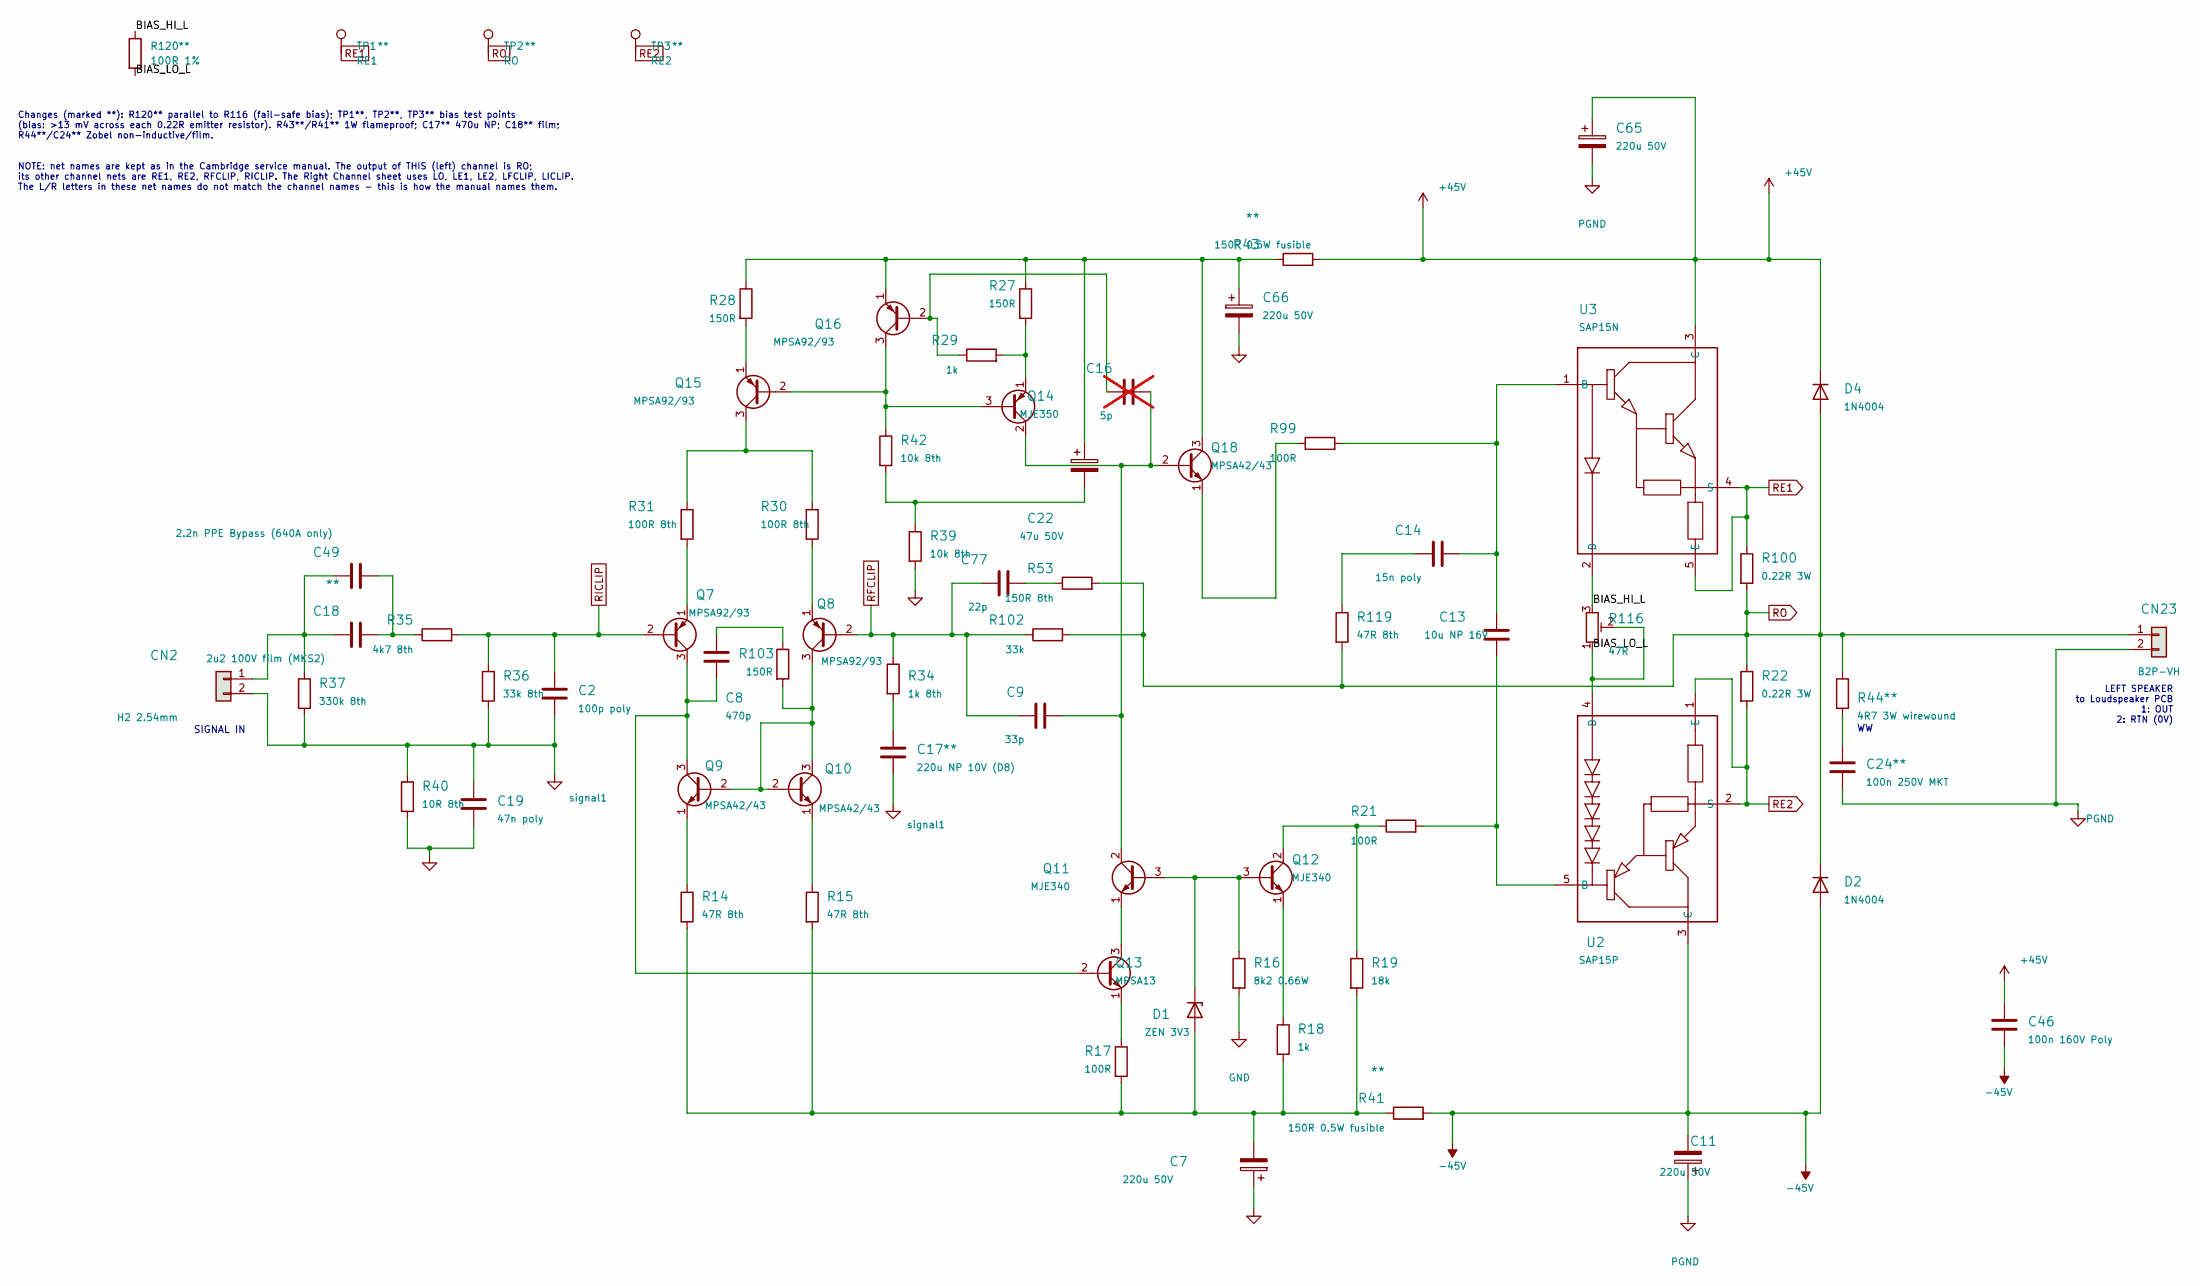
[picture p27: schematic left_channel.kicad_sch, AP12707/6 Power Amp Schematic (Left Channel)]

Parts:
C2: 100p poly; C_Rect_L7.2mm_W2.5mm_P5.00mm_FKS2_FKP2_MKS2_MKP2
C7, C11, C65, C66: 220u 50V; CP_Radial_D10.0mm_P5.00mm
C8: 470p; C_Disc_D5.0mm_W2.5mm_P5.00mm
C9: 33p; C_Rect_L7.2mm_W2.5mm_P5.00mm_FKS2_FKP2_MKS2_MKP2
C13: 10u NP 16V; C_Radial_D5.0mm_P5.00mm_NP
C14: 15n poly; C_Rect_L7.2mm_W2.5mm_P5.00mm_FKS2_FKP2_MKS2_MKP2
C16: 5p; C_Disc_D5.0mm_W2.5mm_P5.00mm; not fitted
C17: 220u NP 10V (D8); C_Radial_D8.0mm_H11.5mm_P3.50mm; MPN ECE-A1AN221U
C18: 2u2 100V film (MKS2); C_Rect_L7.2mm_W11.0mm_P5.00mm_FKS2_FKP2_MKS2_MKP2; MPN MKS2D042201N00KO00 (MKS2-2.2U/100-R)
C19: 47n poly; C_Rect_L7.2mm_W2.5mm_P5.00mm_FKS2_FKP2_MKS2_MKP2
C22: 47u 50V; CP_Radial_D6.3mm_P2.50mm
C24: 100n 250V MKT; C_Rect_L9.0mm_W3.2mm_P7.50mm_MKT; MPN B32560J3104K000
C46: 100n 160V Poly; C_Rect_L13.0mm_W4.0mm_P10.00mm_FKS3_FKP3_MKS4
C49: 2.2n PPE Bypass (640A only); C_Rect_L7.2mm_W2.5mm_P5.00mm_FKS2_FKP2_MKS2_MKP2
C77: 22p; C_Disc_D5.0mm_W2.5mm_P5.00mm
CN2: H2 2.54mm; JST_XH_B2B-XH-A_1x02_P2.50mm_Vertical
CN23: B2P-VH; JST_VH_B2P-VH_1x02_P3.96mm_Vertical; MPN B2P-VH
D1: ZEN 3V3; D_DO-35_SOD27_P7.62mm_Horizontal
D2, D4: 1N4004; D_DO-41_SOD81_P8.89mm_Horizontal
Q7, Q8, Q15, Q16: MPSA92/93; TO-92_Inline_Wide
Q9, Q10, Q18: MPSA42/43; TO-92_Inline_Wide
Q11, Q12: MJE340; TO-126-3_Vertical
Q13: MPSA13; TO-92_Inline_Wide
Q14: MJE350; TO-126-3_Vertical
R14, R15: 47R 8th; R_Axial_DIN0204_L3.6mm_D1.6mm_P7.62mm_Horizontal
R16: 8k2 0.66W; R_Axial_DIN0309_L9.0mm_D3.2mm_P11.81mm_Horizontal
R17, R21, R99: 100R; R_Axial_DIN0207_L6.3mm_D2.5mm_P10.16mm_Horizontal
R18, R29: 1k; R_Axial_DIN0207_L6.3mm_D2.5mm_P10.16mm_Horizontal
R19: 18k; R_Axial_DIN0207_L6.3mm_D2.5mm_P10.16mm_Horizontal
R22, R100: 0.22R 3W; R_Axial_DIN0516_L15.5mm_D5.0mm_P19.69mm_Horizontal
R27, R28: 150R; R_Axial_DIN0207_L6.3mm_D2.5mm_P10.16mm_Horizontal
R30, R31: 100R 8th; R_Axial_DIN0204_L3.6mm_D1.6mm_P7.62mm_Horizontal
R34: 1k 8th; R_Axial_DIN0204_L3.6mm_D1.6mm_P7.62mm_Horizontal
R35: 4k7 8th; R_Axial_DIN0204_L3.6mm_D1.6mm_P7.62mm_Horizontal
R36: 33k 8th; R_Axial_DIN0204_L3.6mm_D1.6mm_P7.62mm_Horizontal
R37: 330k 8th; R_Axial_DIN0204_L3.6mm_D1.6mm_P7.62mm_Horizontal
R39, R42: 10k 8th; R_Axial_DIN0204_L3.6mm_D1.6mm_P7.62mm_Horizontal
R40: 10R 8th; R_Axial_DIN0204_L3.6mm_D1.6mm_P7.62mm_Horizontal
R41, R43: 150R 0.5W fusible; R_Axial_DIN0207_L6.3mm_D2.5mm_P10.16mm_Horizontal; MPN FRN50J150R/S
R44: 4R7 3W wirewound; R_Axial_DIN0516_L15.5mm_D5.0mm_P18.42mm_Horizontal; MPN AC03000004708JAC00
R53: 150R 8th; R_Axial_DIN0204_L3.6mm_D1.6mm_P7.62mm_Horizontal
R102: 33k; R_Axial_DIN0207_L6.3mm_D2.5mm_P10.16mm_Horizontal
R103: 150R; R_Axial_DIN0204_L3.6mm_D1.6mm_P7.62mm_Horizontal
R116: 47R; Potentiometer_Bourns_3296W_Vertical
R119: 47R 8th; R_Axial_DIN0204_L3.6mm_D1.6mm_P5.08mm_Horizontal
R120: 100R 1%; R_Axial_DIN0204_L3.6mm_D1.6mm_P2.54mm_Vertical; MPN MF-25 0.25W 100R 1%
TP1: RE1; TestPoint_THTPad_D2.0mm_Drill1.0mm
TP2: RO; TestPoint_THTPad_D2.0mm_Drill1.0mm
TP3: RE2; TestPoint_THTPad_D2.0mm_Drill1.0mm
U2: SAP15P; TO-3P-5_SAP15_Horizontal
U3: SAP15N; TO-3P-5_SAP15_Horizontal

Connections:
+45V: C46.1, C65.1, D4.1 (K), R43.2, U3.3 (C); also elsewhere on the board
-45V: C11.2, C46.2, D2.2 (A), R41.2, U2.3 (C); also elsewhere on the board
/Left Channel/BIAS_HI_L: R116.3, R120.1, U3.2 (D)
/Left Channel/BIAS_LO_L: R116.1, R116.2, R120.2, U2.4 (D)
GND: C7.1, C19.2, C66.2, R16.2, R39.2, R40.2; also elsewhere on the board
unnamed: C8.1, R103.1
unnamed: C14.1, R119.1
unnamed: C17.1, R34.2
unnamed: C18.2, C49.2, R35.1
unnamed: C22.2, R39.1, R42.2
unnamed: C24.1, R44.2
unnamed: C77.2, R53.1
unnamed: C18.1, C49.1, CN2.1, R37.1
unnamed: C7.2, D1.2 (A), R14.2, R15.2, R17.2, R18.2, R19.2, R41.1
unnamed: D1.1 (K), Q11.3 (B), Q12.3 (B), R16.1
unnamed: Q7.1 (E), R31.2
unnamed: Q8.1 (E), R30.2
unnamed: Q9.1 (E), R14.1
unnamed: Q8.3 (C), Q9.2 (B), Q10.2 (B), Q10.3 (C), R103.2
unnamed: Q10.1 (E), R15.1
unnamed: C9.2, C16.2, Q11.2 (C), Q14.2 (C), Q18.2 (B)
unnamed: Q11.1 (E), Q13.3 (C)
unnamed: Q12.2 (C), R19.1, R21.1
unnamed: Q12.1 (E), R18.1
unnamed: C8.2, Q7.3 (C), Q9.3 (C), Q13.2 (B)
unnamed: Q13.1 (E), R17.1
unnamed: Q14.3 (B), Q15.2 (B), Q16.3 (C), R42.1
unnamed: Q14.1 (E), R27.2, R29.2
unnamed: Q15.3 (C), R30.1, R31.1
unnamed: Q15.1 (E), R28.2
unnamed: C16.1, Q16.2 (B), R29.1
unnamed: C22.1, C66.1, Q16.1 (E), Q18.3 (C), R27.1, R28.1, R43.1
unnamed: Q18.1 (E), R99.1
unnamed: C13.2, R21.2, U2.5 (B)
unnamed: C13.1, C14.2, R99.2, U3.1 (B)
PGND: C11.1, C24.2, C65.2, CN23.2; also elsewhere on the board
RE1: R100.1, TP1.1 (1_1), U3.4 (S), U3.5 (E); also elsewhere on the board
RE2: R22.2, TP3.1 (1_1), U2.1 (E), U2.2 (S); also elsewhere on the board
RFCLIP: C9.1, C77.1, Q8.2 (B), R34.1, R102.1; also elsewhere on the board
RICLIP: C2.1, Q7.2 (B), R35.2, R36.1; also elsewhere on the board
RO: CN23.1, D2.1 (K), D4.2 (A), R22.1, R44.1, R53.2, R100.2, R102.2, R119.2, TP2.1 (1_1); also elsewhere on the board
signal1: C2.2, C17.2, C19.1, CN2.2, R36.2, R37.2, R40.1

Notes on the sheet:
NOTE: net names are kept as in the Cambridge service manual. The output of THIS (left) channel is RO; its other channel nets are RE1, RE2, RFCLIP, RICLIP. The Right Channel sheet uses LO, LE1, LE2, LFCLIP, LICLIP. The L/R letters in these net names do not match the channel names - this is how the m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
LEFT SPEAKER to Loudspeaker PCB 1: OUT 2: RTN (0V)
Changes (marked **): R120** parallel to R116 (fail-safe bias); TP1**, TP2**, TP3** bias test points (bias: >13 mV across each 0.22R emitter resistor). R43**/R41** 1W flameproof; C17** 470u NP; C18** film; R44**/C24** Zobel non-inductive/film.
SIGNAL IN

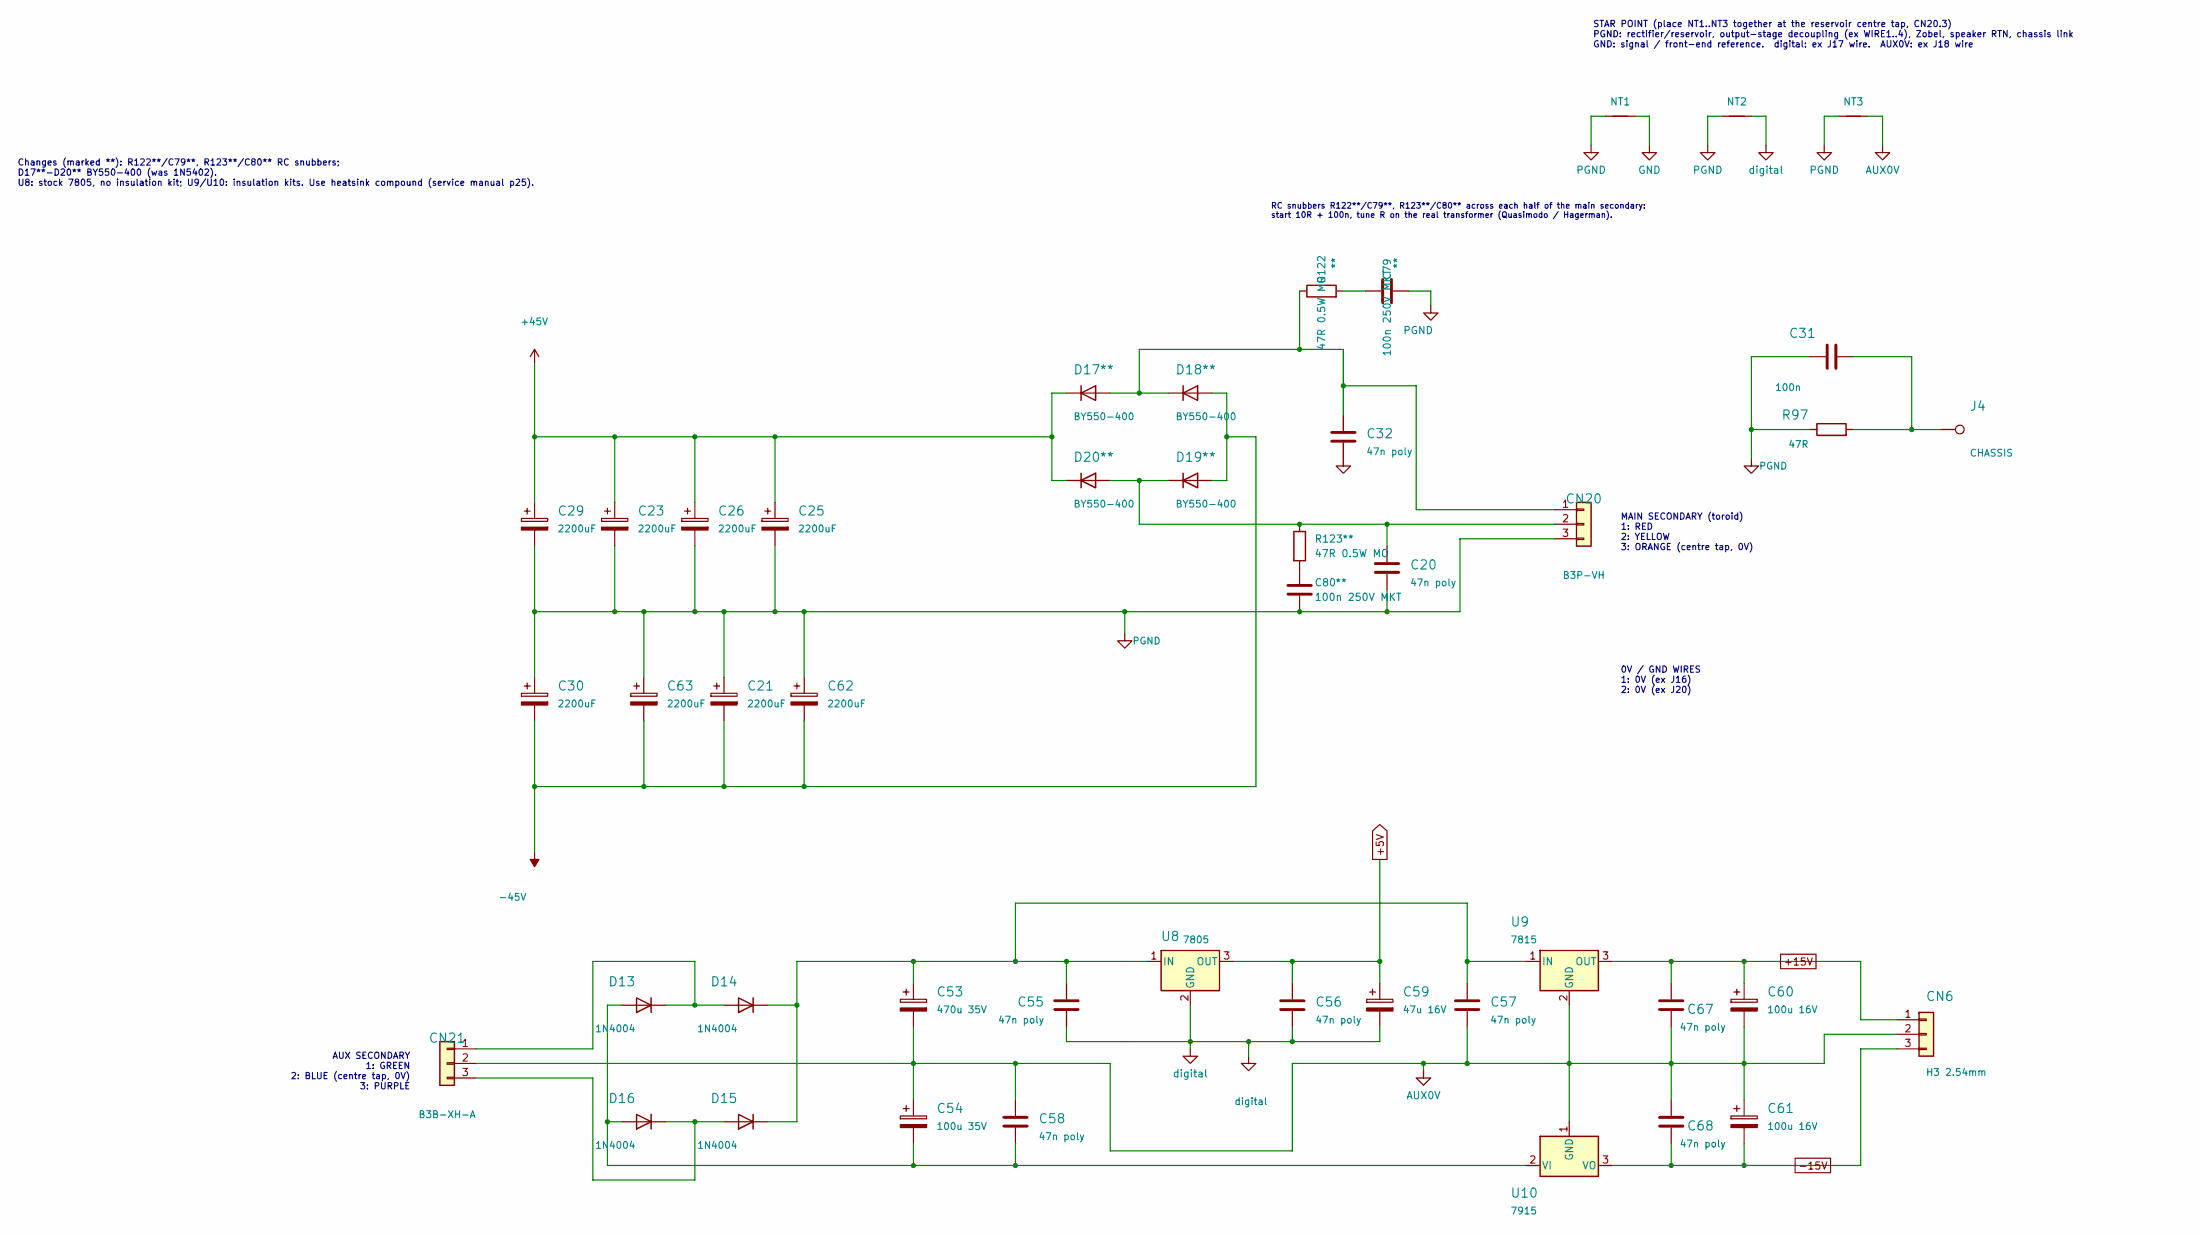
[picture p28: schematic power_supply.kicad_sch, AP12707/6 Power Amp Schematic (Power Supply)]

Parts:
C20, C32, C55, C56, C57, C58, C67, C68: 47n poly; C_Rect_L7.2mm_W2.5mm_P5.00mm_FKS2_FKP2_MKS2_MKP2
C21, C23, C25, C26, C29, C30, C62, C63: 2200uF; CP_Radial_D18.0mm_P7.50mm
C31: 100n; C_Disc_D7.5mm_W2.5mm_P5.00mm
C53: 470u 35V; CP_Radial_D10.0mm_P5.00mm
C54: 100u 35V; CP_Radial_D8.0mm_P3.50mm
C59: 47u 16V; CP_Radial_D5.0mm_P2.50mm
C60, C61: 100u 16V; CP_Radial_D5.0mm_P2.50mm
C79, C80: 100n 250V MKT; C_Rect_L9.0mm_W3.2mm_P7.50mm_MKT; MPN B32560J3104K000
CN6: H3 2.54mm; JST_XH_B3B-XH-A_1x03_P2.50mm_Vertical
CN20: B3P-VH; JST_VH_B3P-VH_1x03_P3.96mm_Vertical; MPN B3P-VH
CN21: B3B-XH-A; JST_XH_B3B-XH-A_1x03_P2.50mm_Vertical; MPN B3B-XH-A
D13, D14, D15, D16: 1N4004; D_DO-41_SOD81_P10.16mm_Horizontal
D17, D18, D19, D20: BY550-400; D_DO-201AD_P13.97mm_Horizontal; MPN BY550-400
J4: CHASSIS; TestPoint_THTPad_3.0x3.0mm_Drill1.5mm
NT1: NetTie_2; NetTie-2_THT_Star
NT2, NT3: NetTie_2; NetTie-2_THT_Pad1.0mm
R97: 47R; R_Axial_DIN0207_L6.3mm_D2.5mm_P10.16mm_Horizontal
R122, R123: 47R 0.5W MO; R_Axial_DIN0207_L6.3mm_D2.5mm_P2.54mm_Vertical; MPN MO-50 0.5W 47R 5%
U8: 7805; TO-220-3_Vertical
U9: 7815; TO-220-3_Vertical
U10: 7915; TO-220-3_Vertical

Connections:
+5V: C56.1, C59.1, U8.3 (OUT); also elsewhere on the board
+15V: C60.1, C67.1, CN6.1, U9.3 (OUT); also elsewhere on the board
+45V: C23.1, C25.1, C26.1, C29.1, D17.1 (K), D20.1 (K); also elsewhere on the board
-15V: C61.2, C68.2, CN6.3, U10.3 (VO); also elsewhere on the board
-45V: C21.2, C30.2, C62.2, C63.2, D18.2 (A), D19.2 (A); also elsewhere on the board
AUX0V: C53.2, C54.1, C57.2, C58.1, C60.2, C61.1, C67.2, C68.1, CN6.2, CN21.2, NT3.2, U9.2 (GND), U10.1 (GND)
GND: NT1.2; also elsewhere on the board
unnamed: C31.2, J4.1 (1_1), R97.2
unnamed: C79.1, R122.2
unnamed: C80.1, R123.2
unnamed: C32.1, CN20.1, D17.2 (A), D18.1 (K), R122.1
unnamed: C20.1, CN20.2, D19.1 (K), D20.2 (A), R123.1
unnamed: CN21.1, D13.1 (K), D14.2 (A)
unnamed: CN21.3, D15.2 (A), D16.1 (K)
unnamed: C54.2, C58.2, D13.2 (A), D16.2 (A), U10.2 (VI)
unnamed: C53.1, C55.1, C57.1, D14.1 (K), D15.1 (K), U8.1 (IN), U9.1 (IN)
PGND: C20.2, C21.1, C23.2, C25.2, C26.2, C29.2, C30.1, C31.1, C32.2, C62.1, C63.1, C79.2, C80.2, CN20.3, NT1.1, NT2.1, NT3.1, R97.1; also elsewhere on the board
digital: C55.2, C56.2, C59.2, NT2.2, U8.2 (GND); also elsewhere on the board

Notes on the sheet:
AUX SECONDARY 1: GREEN 2: BLUE (centre tap, 0V) 3: PURPLE
STAR POINT (place NT1..NT3 together at the reservoir centre tap, CN20.3) PGND: rectifier/reservoir, output-stage decoupling (ex WIRE1..4), Zobel, speaker RTN, chassis link GND: signal / front-end reference. digital: ex J17 wire. AUX0V: ex J18 wire
RC snubbers R122**/C79**, R123**/C80** across each half of the main secondary: start 10R + 100n, tune R on the real transformer (Quasimodo / Hagerman).
MAIN SECONDARY (toroid) 1: RED 2: YELLOW 3: ORANGE (centre tap, 0V)
0V / GND WIRES 1: 0V (ex J16) 2: 0V (ex J20)
Changes (marked **): R122**/C79**, R123**/C80** RC snubbers; D17**-D20** BY550-400 (was 1N5402). U8: stock 7805, no insulation kit; U9/U10: insulation kits. Use heatsink compound (service manual p25).
