SSSound13/Cambridge_640A_PowerAmp/640A_PowerAmp.kicad_pcb

## KiCad design 640A_PowerAmp.kicad_pcb (continued)

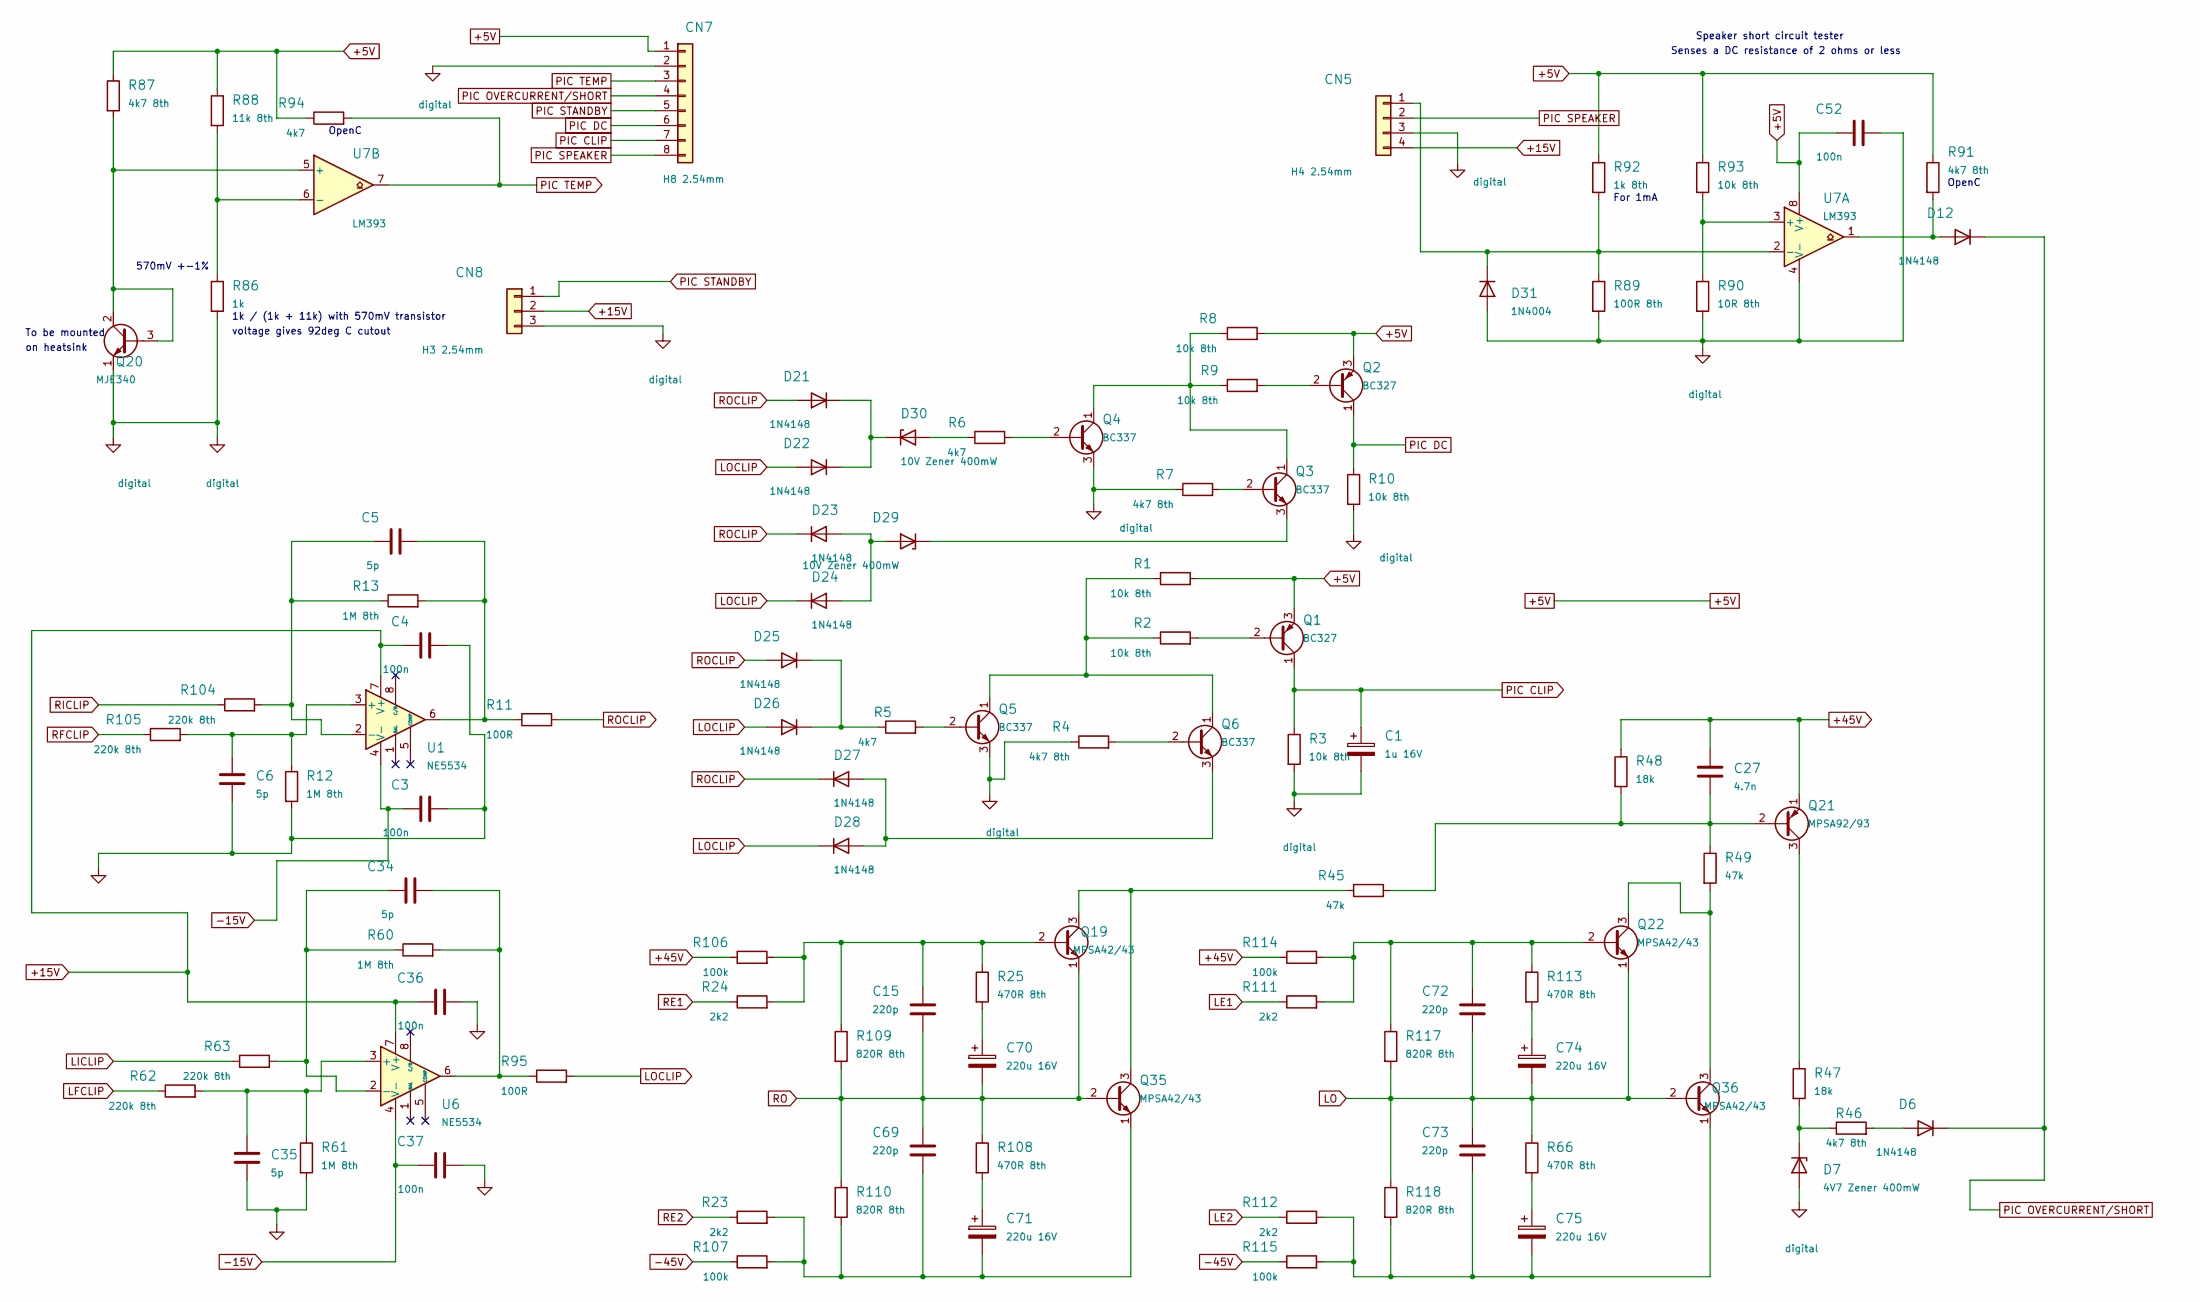
[picture p29: schematic protection.kicad_sch, AP12707/6 Power Amp Schematic (Protection)]

Parts:
C1: 1u 16V; CP_Radial_D5.0mm_P2.50mm
C3, C4, C36, C37, C52: 100n; C_Disc_D7.5mm_W2.5mm_P5.00mm
C5, C6, C34, C35: 5p; C_Disc_D5.0mm_W2.5mm_P5.00mm
C15, C69, C72, C73: 220p; C_Disc_D5.0mm_W2.5mm_P5.00mm
C27: 4.7n; C_Disc_D7.5mm_W2.5mm_P5.00mm
C70, C71, C74, C75: 220u 16V; CP_Radial_D5.0mm_P2.50mm
CN5: H4 2.54mm; JST_XH_B4B-XH-A_1x04_P2.50mm_Vertical
CN7: H8 2.54mm; JST_XH_B8B-XH-A_1x08_P2.50mm_Vertical
CN8: H3 2.54mm; JST_XH_B3B-XH-A_1x03_P2.50mm_Vertical
D6, D12, D21, D22, D23, D24, D25, D26, D27, D28: 1N4148; D_DO-35_SOD27_P7.62mm_Horizontal
D7: 4V7 Zener 400mW; D_DO-35_SOD27_P7.62mm_Horizontal
D29, D30: 10V Zener 400mW; D_DO-35_SOD27_P7.62mm_Horizontal
D31: 1N4004; D_DO-41_SOD81_P10.16mm_Horizontal
Q1, Q2: BC327; TO-92_Inline_Wide
Q3, Q4, Q5, Q6: BC337; TO-92_Inline_Wide
Q19, Q22, Q35, Q36: MPSA42/43; TO-92_Inline_Wide
Q20: MJE340; TO-126-3_Vertical
Q21: MPSA92/93; TO-92_Inline_Wide
R1, R2, R3, R8, R9, R10, R93: 10k 8th; R_Axial_DIN0204_L3.6mm_D1.6mm_P7.62mm_Horizontal
R4, R7, R87, R91: 4k7 8th; R_Axial_DIN0204_L3.6mm_D1.6mm_P7.62mm_Horizontal
R5, R6, R94: 4k7; R_Axial_DIN0207_L6.3mm_D2.5mm_P10.16mm_Horizontal
R11, R95: 100R; R_Axial_DIN0207_L6.3mm_D2.5mm_P10.16mm_Horizontal
R12, R13, R60, R61: 1M 8th; R_Axial_DIN0204_L3.6mm_D1.6mm_P7.62mm_Horizontal
R23, R24, R111, R112: 2k2; R_Axial_DIN0207_L6.3mm_D2.5mm_P10.16mm_Horizontal
R25, R66, R108, R113: 470R 8th; R_Axial_DIN0204_L3.6mm_D1.6mm_P7.62mm_Horizontal
R45, R49: 47k; R_Axial_DIN0207_L6.3mm_D2.5mm_P10.16mm_Horizontal
R46: 4k7 8th; R_Axial_DIN0207_L6.3mm_D2.5mm_P10.16mm_Horizontal
R47, R48: 18k; R_Axial_DIN0207_L6.3mm_D2.5mm_P10.16mm_Horizontal
R62, R63, R104, R105: 220k 8th; R_Axial_DIN0204_L3.6mm_D1.6mm_P7.62mm_Horizontal
R86: 1k; R_Axial_DIN0207_L6.3mm_D2.5mm_P10.16mm_Horizontal
R88: 11k 8th; R_Axial_DIN0204_L3.6mm_D1.6mm_P7.62mm_Horizontal
R89: 100R 8th; R_Axial_DIN0204_L3.6mm_D1.6mm_P7.62mm_Horizontal
R90: 10R 8th; R_Axial_DIN0204_L3.6mm_D1.6mm_P7.62mm_Horizontal
R92: 1k 8th; R_Axial_DIN0204_L3.6mm_D1.6mm_P7.62mm_Horizontal
R106, R107, R114, R115: 100k; R_Axial_DIN0207_L6.3mm_D2.5mm_P10.16mm_Horizontal
R109, R110, R117, R118: 820R 8th; R_Axial_DIN0204_L3.6mm_D1.6mm_P7.62mm_Horizontal
U1, U6: NE5534; DIP-8_W7.62mm
U7: LM393; DIP-8_W7.62mm

Connections:
+5V: C52.1, CN7.1, Q1.3 (E), Q2.3 (E), R1.2, R8.2, R87.1, R88.1, R91.1, R92.1, R93.1, R94.1, U7.8 (V+); also elsewhere on the board
+15V: C4.1, C36.1, CN5.4, CN8.2, U1.7 (V+), U6.7 (V+); also elsewhere on the board
+45V: C27.1, Q21.1 (E), R48.1, R106.1, R114.1; also elsewhere on the board
-15V: C3.1, C37.1, U1.4 (V-), U6.4 (V-); also elsewhere on the board
-45V: R107.1, R115.1; also elsewhere on the board
GND: C3.2, C4.2, C6.2, C35.2, C36.2, C37.2, R12.2, R61.2; also elsewhere on the board
LE1: R111.1; also elsewhere on the board
LE2: R112.1; also elsewhere on the board
LFCLIP: R62.1; also elsewhere on the board
LICLIP: R63.1; also elsewhere on the board
LO: C72.2, C73.1, C74.2, Q22.1 (E), Q36.2 (B), R66.1, R117.2, R118.1; also elsewhere on the board
LOCLIP: D22.2 (A), D24.1 (K), D26.2 (A), D28.1 (K), R95.2
unnamed: C5.2, R11.1, R13.2, U1.6
unnamed: C34.2, R60.2, R95.1, U6.6
unnamed: C70.1, R25.2
unnamed: C71.1, R108.2
unnamed: C74.1, R113.2
unnamed: C75.1, R66.2
unnamed: CN5.1, D31.1 (K), R89.1, R92.2, U7.2 (-)
unnamed: D6.2 (A), R46.2
unnamed: D7.1 (K), R46.1, R47.2
unnamed: D12.2 (A), R91.2, U7.1
unnamed: D21.1 (K), D22.1 (K), D30.1 (K)
unnamed: D23.2 (A), D24.2 (A), D29.2 (A)
unnamed: D25.1 (K), D26.1 (K), R5.1
unnamed: D27.2 (A), D28.2 (A), Q6.3 (E)
unnamed: D29.1 (K), Q3.3 (E)
unnamed: D30.2 (A), R6.1
unnamed: Q1.2 (B), R2.2
unnamed: Q2.2 (B), R9.2
unnamed: Q3.2 (B), R7.2
unnamed: Q3.1 (C), Q4.1 (C), R8.1, R9.1
unnamed: Q4.2 (B), R6.2
unnamed: Q5.2 (B), R5.2
unnamed: Q5.1 (C), Q6.1 (C), R1.1, R2.1
unnamed: Q6.2 (B), R4.2
unnamed: C15.1, Q19.2 (B), R24.2, R25.1, R106.2, R109.1
unnamed: Q19.3 (C), Q35.3 (C), R45.1
unnamed: Q20.2 (C), Q20.3 (B), R87.2, U7.5 (+)
unnamed: C27.2, Q21.2 (B), R45.2, R48.2, R49.1
unnamed: Q21.3 (C), R47.1
unnamed: C72.1, Q22.2 (B), R111.2, R113.1, R114.2, R117.1
unnamed: Q22.3 (C), Q36.3 (C), R49.2
unnamed: C69.2, C71.2, Q35.1 (E), R23.2, R107.2, R110.2
unnamed: C73.2, C75.2, Q36.1 (E), R112.2, R115.2, R118.2
unnamed: C6.1, R12.1, R105.2, U1.3 (+)
unnamed: C5.1, R13.1, R104.2, U1.2 (-)
unnamed: C35.1, R61.1, R62.2, U6.3 (+)
unnamed: C34.1, R60.1, R63.2, U6.2 (-)
unnamed: R90.1, R93.2, U7.3 (+)
unnamed: R86.1, R88.2, U7.6 (-)
PIC CLIP: C1.1, CN7.7, Q1.1 (C), R3.1
PIC DC: CN7.6, Q2.1 (C), R10.1
PIC OVERCURRENT/SHORT: CN7.4, D6.1 (K), D12.1 (K)
PIC SPEAKER: CN5.2, CN7.8
PIC STANDBY: CN7.5, CN8.1
PIC TEMP: CN7.3, R94.2, U7.7
RE1: R24.1; also elsewhere on the board
RE2: R23.1; also elsewhere on the board
RFCLIP: R105.1; also elsewhere on the board
RICLIP: R104.1; also elsewhere on the board
RO: C15.2, C69.1, C70.2, Q19.1 (E), Q35.2 (B), R108.1, R109.2, R110.1; also elsewhere on the board
ROCLIP: D21.2 (A), D23.1 (K), D25.2 (A), D27.1 (K), R11.2
digital: C1.2, C52.2, CN5.3, CN7.2, CN8.3, D7.2 (A), D31.2 (A), Q4.3 (E), Q5.3 (E), Q20.1 (E), R3.2, R4.1, R7.1, R10.2, R86.2, R89.2, R90.2, U7.4 (V-); also elsewhere on the board

Notes on the sheet:
570mV +-1%
For 1mA
OpenC
Senses a DC resistance of 2 ohms or less
To be mounted
Speaker short circuit tester
on heatsink
voltage gives 92deg C cutout
1k / (1k + 11k) with 570mV transistor

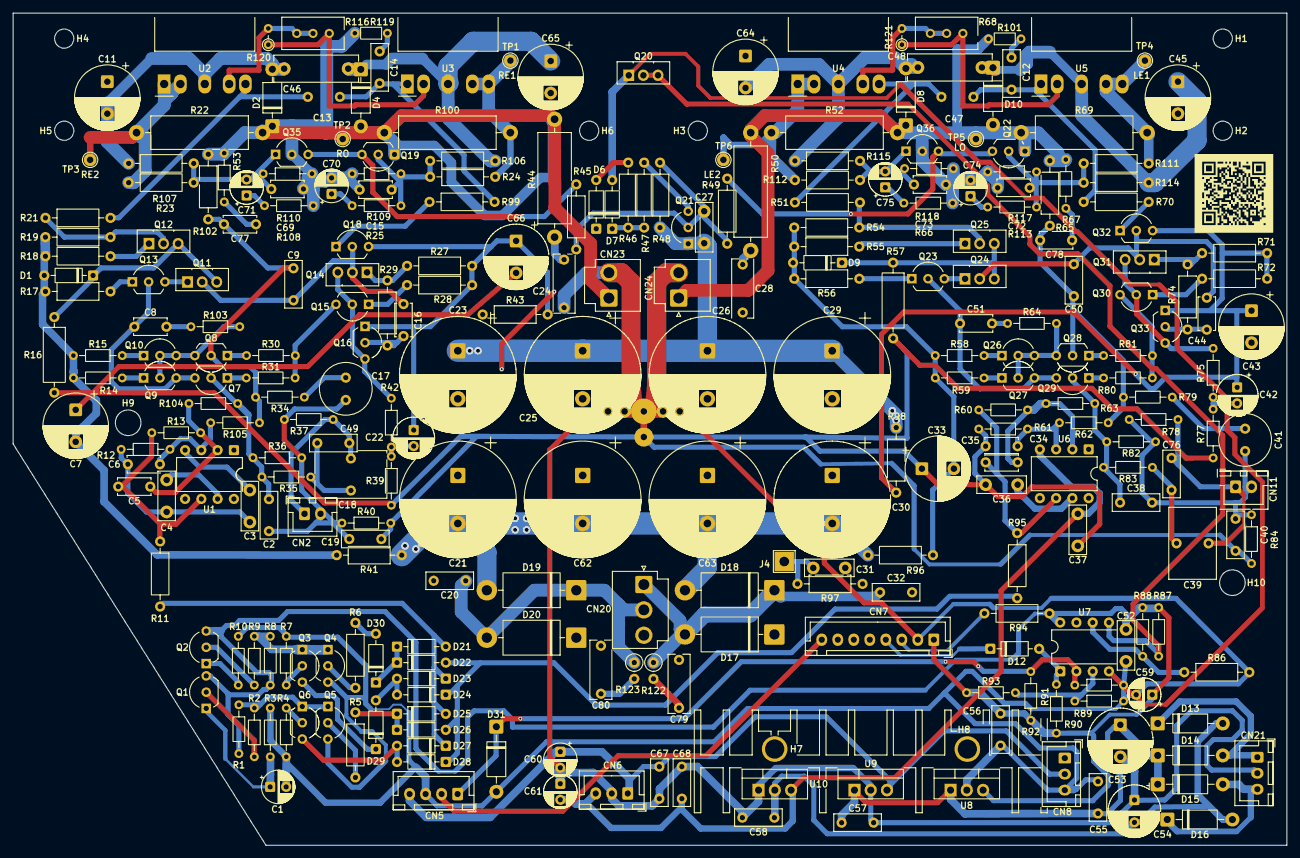
[picture p30: board 640A_PowerAmp.kicad_pcb from above]

Board: 4 copper layers, 198.9 x 130.0 mm, 296 parts (0 on the bottom side), 141 nets.

Other parts of the board:
H1, H2, H3, H4, H5, H6: bracket fixing, 3.0 mm NPTH; MountingHole_NPTH_3.0mm
H7: heatsink pin, 3.0 mm PTH; MountingHole_PTH_3.0mm_Pad4.0mm
H8: heatsink pin, 3.0 mm PTH; no separate digital tra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; MountingHole_PTH_3.0mm_Pad4.0mm
H9, H10: standoff, 4.0 mm NPTH; MountingHole_NPTH_4.0mm
