SSSound13/Cambridge_640A_PowerAmp/(commit log)

2026-10-03 README: преимущества, сравнение с оригиналом; перечень деталей BOM
    [BOM.csv]
2026-10-17 NT1: отверстие PGND 1,6 мм; имена цепей L/R и LK27 в README и схеме; состояние проекта
    [640A_PowerAmp.kicad_pcb, left_channel.kicad_sch, right_channel.kicad_sch]
2026-11-05 docs: record next revision intentions from v2 assembly feedback
2026-11-06 docs: record stock 7805, intact heatsink and removal of H8 ground
2026-11-06 docs: designate next board revision v3 and remove SMD experiment reference
2026-11-06 docs: designate next board revision v3
2026-11-06 v2: publish minimal repairs and project overview
    [640A_PowerAmp.kicad_pcb, BOM.csv, power_supply.kicad_sch, protection.kicad_sch]
2026-11-06 docs: mark historical NT1 chassis wiring advice obsolete
2026-11-06 docs: restore original-versus-v2 comparison with current caveats
2026-11-06 docs: correct bridge diode annotation to BY550-400
    [power_supply.kicad_sch]
2026-11-07 v2: move project QR to top silkscreen below H2
    [640A_PowerAmp.kicad_pcb]
2026-11-07 v2: update Gerber, drills and validation from 5dcab89
    Regenerate all fabrication layers, PTH/NPTH drills, IPC netlist and ZIPs. Preserve PCB and schematics. Record 23 silk overlap warnings and review status; retain historical reports separately.
    [640A_PowerAmp-B_Cu.gbr, 640A_PowerAmp-B_Mask.gbr, 640A_PowerAmp-B_Paste.gbr, 640A_PowerAmp-B_Silkscreen.gbr, 640A_PowerAmp-Edge_Cuts.gbr, 640A_PowerAmp-F_Cu.gbr, 640A_PowerAmp-F_Mask.gbr, 640A_PowerAmp-F_Paste.gbr]
2026-11-07 v2: clear R12 silkscreen and accept four reviewed overlaps
    [640A_PowerAmp-B_Cu.gbr, 640A_PowerAmp-B_Mask.gbr, 640A_PowerAmp-B_Paste.gbr, 640A_PowerAmp-B_Silkscreen.gbr, 640A_PowerAmp-Edge_Cuts.gbr, 640A_PowerAmp-F_Cu.gbr, 640A_PowerAmp-F_Mask.gbr, 640A_PowerAmp-F_Paste.gbr]
